yhqiu16/OCOWFC/docs/fpl21_nand_flash_controller_yunhuiqiu_fudan.pdf

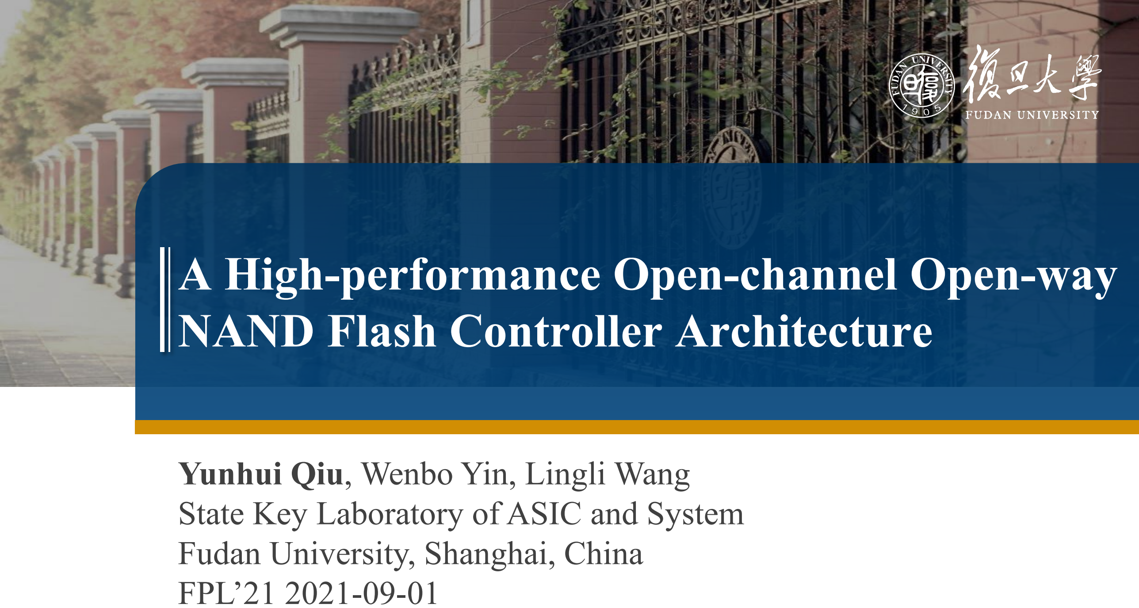
[picture p1: page 1]

# A High-performance Open-channel Open-way NAND Flash Controller Architecture

Yunhui Qiu, Wenbo Yin, Lingli Wang
State Key Laboratory of ASIC and System
Fudan University, Shanghai, China FPL’21 2021-09-01

NAND-Flash-based SSD

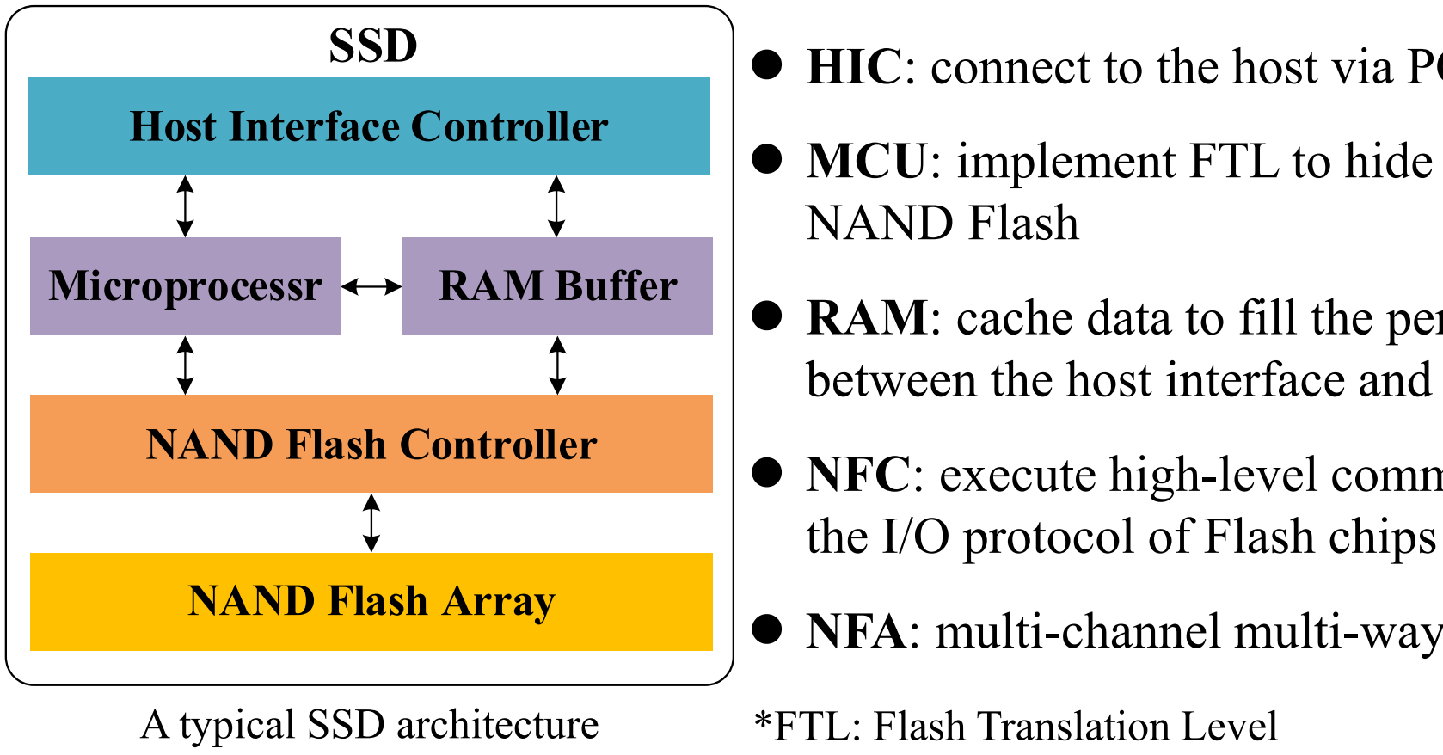
[picture p2: figure]
A typical SSD architecture; SSD; Microprocessr; NAND Flash Controller; NAND Flash Array; Host Interface Controller; RAM Buffer; NAND Flash; the I/O protocol of Flash chips; *FTL: Flash Translation Level

- MCU: implement FTL to hide the peculiarities of
- HIC: connect to the host via PCIe, SATA…
- RAM: cache data to fill the performance gap between the host interface and Flash media
- NFC: execute high-level commands according to
- NFA: multi-channel multi-way Flash chips

Flash Operations

### Challenges

R T
read
cmd

data
transfer

busy
period
(a) read page
P | T | P | S
post-prog
cmd

data
transfer

check
status

busy
period
(b) program page

pre-prog
cmd

E S
check
status

erase
cmd

busy
period
(c) erase block

~10µs

~100µs

~1000µs

- I/O speed: ~10MT/s - ~1000MT/s, lower than the host interface
- Slow execution: serious under-utilization of I/O bandwidth

Multi-level Parallelism
- Channel-level parallelism

multiple channels with independent I/O buses

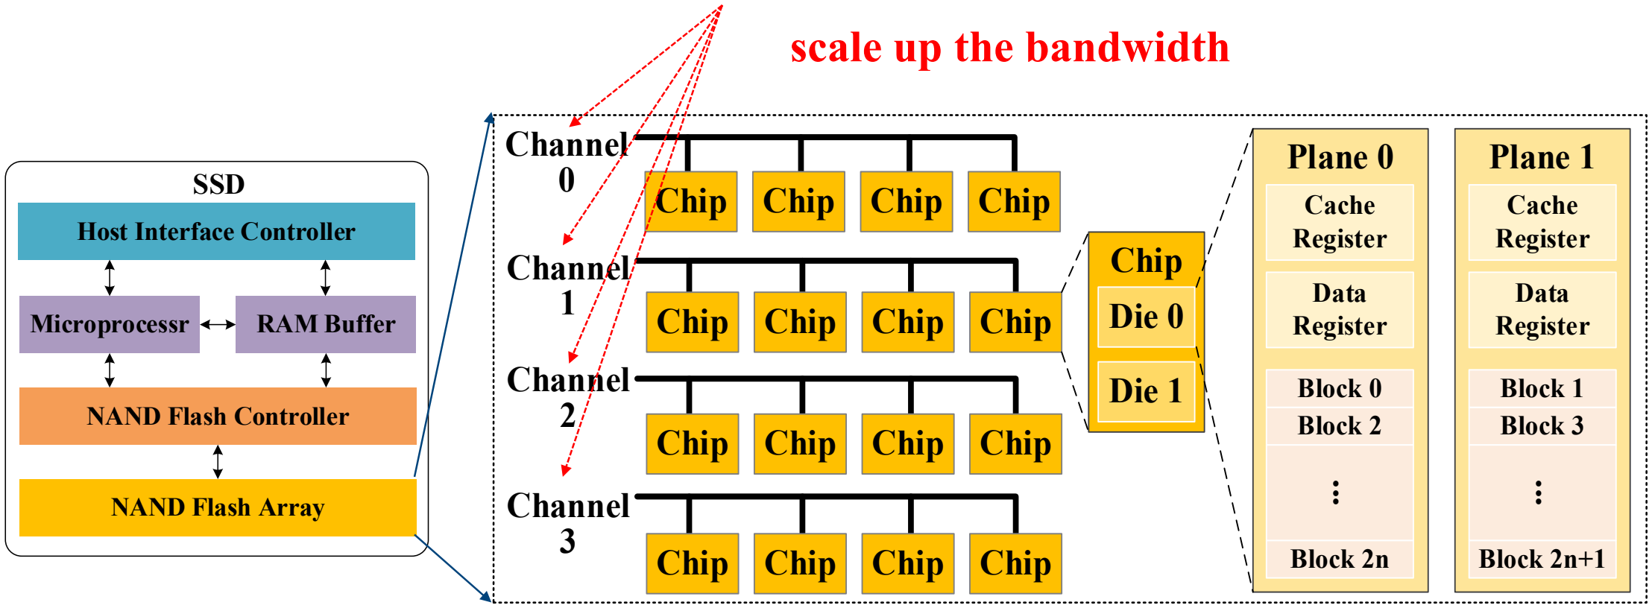
[picture p3: figure]
SSD; Microprocessr; NAND Flash Controller; NAND Flash Array; Host Interface Controller; RAM Buffer; Plane 0; Plane 1; Chip; Chip Chip Chip Chip; Channel 0; Die 0; Die 1; Cache Register Data Register; Block 0 Block 2; Block 2n ...; Block 1 Block 3; Block 2n+1 ...; Channel 1; Channel 2; Channel 3; scale up the bandwidth

Multi-level Parallelism
- Channel-level parallelism: independent I/O buses, scale up the bandwidth
- Way-level interleaving
multiple ways (chips or dies) share an I/O bus

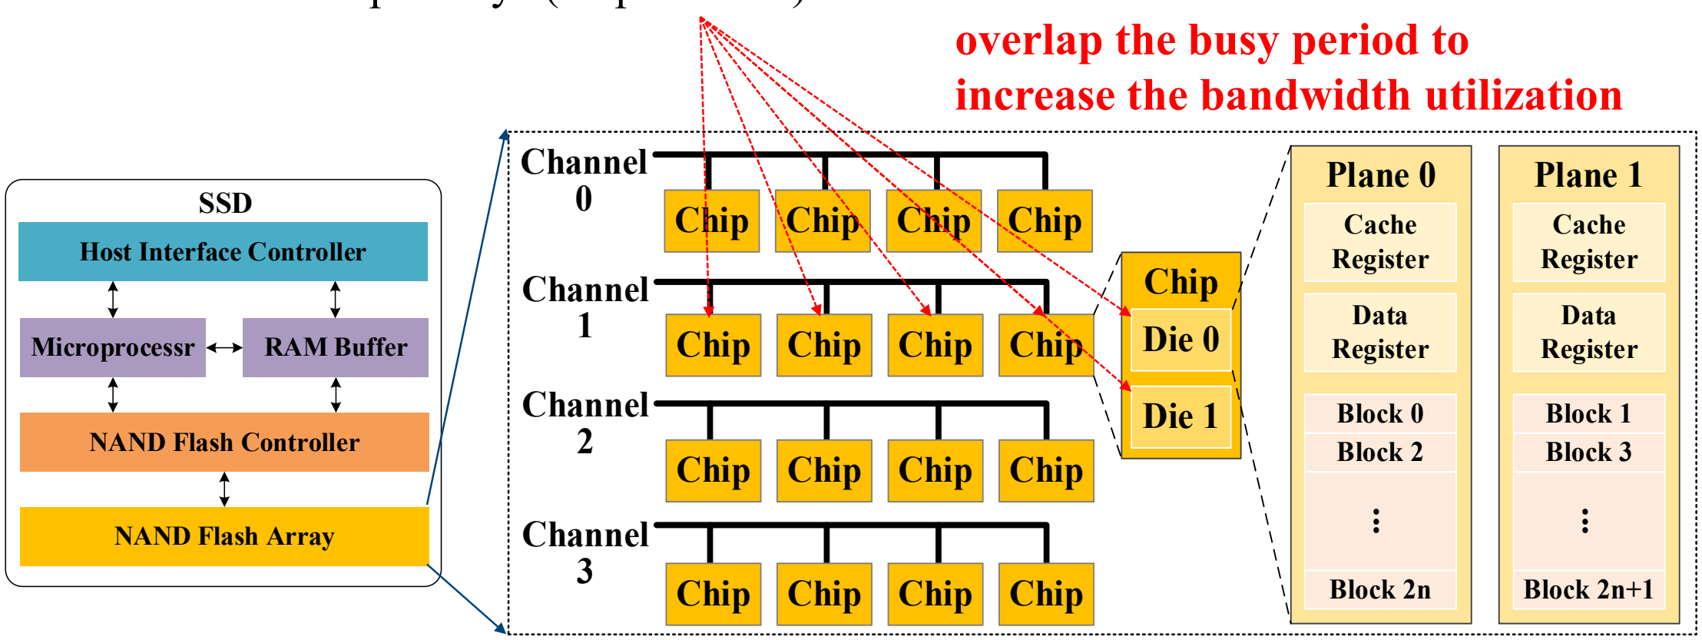
[picture p4: figure]
SSD; Microprocessr; NAND Flash Controller; NAND Flash Array; Host Interface Controller; RAM Buffer; Plane 0; Plane 1; Chip; Chip Chip Chip Chip; Channel 0; Die 0; Die 1; Cache Register Data Register; Block 0 Block 2; Block 2n ...; Block 1 Block 3; Block 2n+1 ...; Channel 1; Channel 2; Channel 3; overlap the busy period to increase the bandwidth utilization

Multi-level Parallelism
- Channel-level parallelism: independent I/O buses, scale up the bandwidth
- Way-level interleaving: share an I/O bus, increase the bandwidth utilization
- Plane-level interleaving
multiple planes in a die operate concurrently with some constraints increase the bandwidth utilization

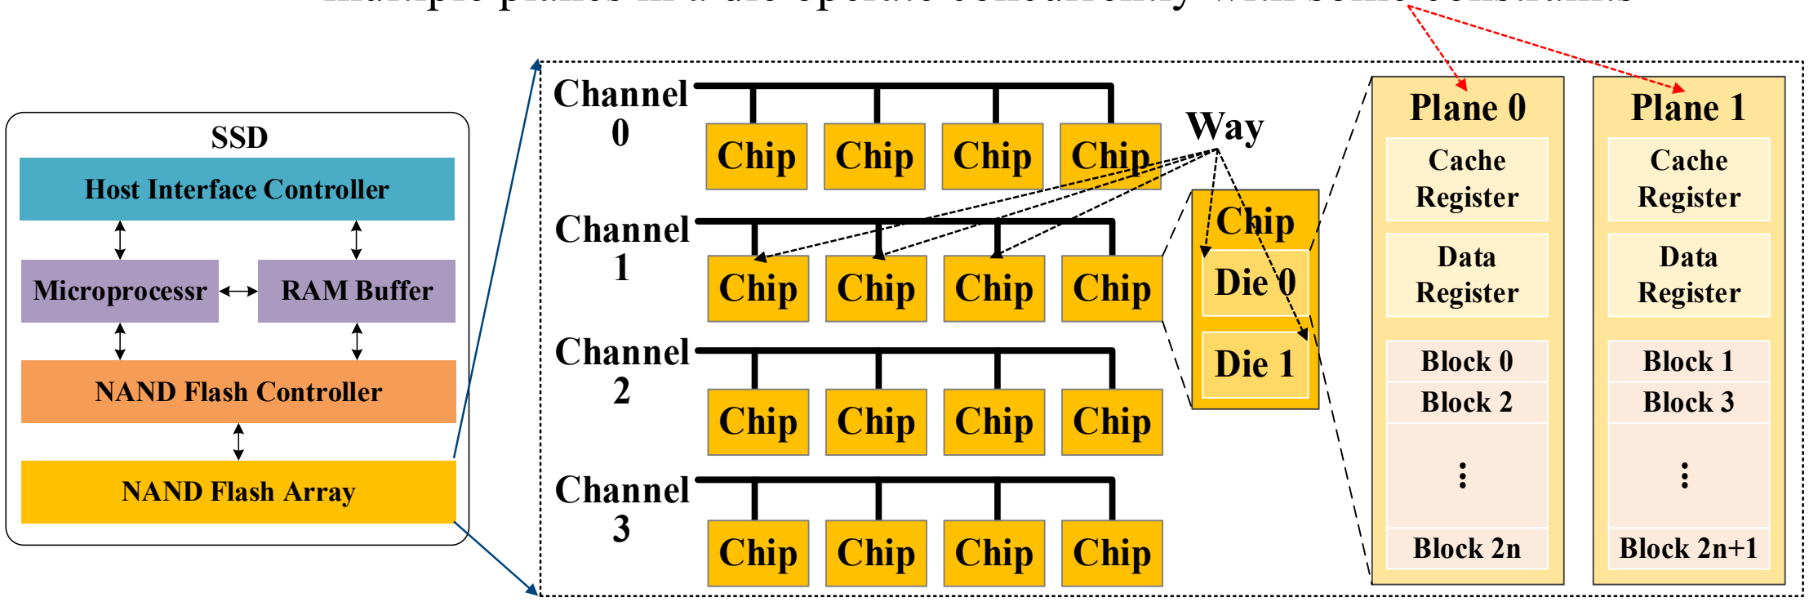
[picture p5: figure]
SSD; Microprocessr; NAND Flash Controller; NAND Flash Array; Host Interface Controller; RAM Buffer; Plane 0; Plane 1; Chip; Chip Chip Chip Chip; Channel 0; Die 0; Die 1; Cache Register Data Register; Block 0 Block 2; Block 2n ...; Block 1 Block 3; Block 2n+1 ...; Channel 1; Channel 2; Channel 3; Way

Multi-level Parallelism
- Channel-level parallelism: independent I/O buses, scale up the bandwidth
- Way-level interleaving: share an I/O bus, increase the bandwidth utilization
- Plane-level interleaving: operate concurrently, increase the bandwidth utilization
- Cache mode pipelining: increase throughput | pipelining

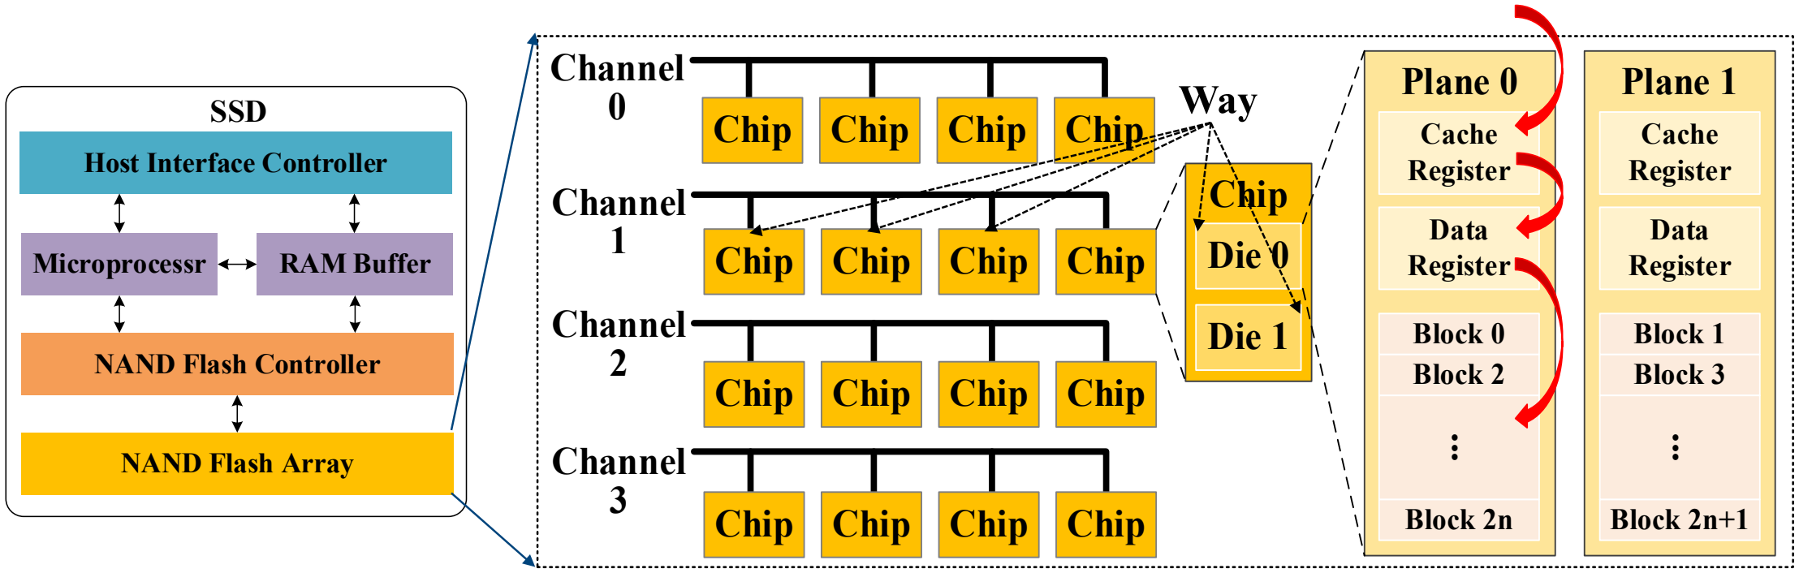
[picture p6: figure]
SSD; Microprocessr; NAND Flash Controller; NAND Flash Array; Host Interface Controller; RAM Buffer; Plane 0; Plane 1; Chip; Chip Chip Chip Chip; Channel 0; Die 0; Die 1; Cache Register Data Register; Block 0 Block 2; Block 2n ...; Block 1 Block 3; Block 2n+1 ...; Channel 1; Channel 2; Channel 3; Way

Motivation: exploit the multi-level parallelism

### 1. Flash simulators [11], [13]-[18]

- fast prototyping and verification
- hard to accurately model hardware controllers
- cannot be evaluated, verified, or tested in a practical environment

Related Work

### 2. Firmware-based I/O scheduling [5], [8], [19]

- tight coupling between FTL and Flash controller
- frequent and time-consuming software-hardware interactions impose serious

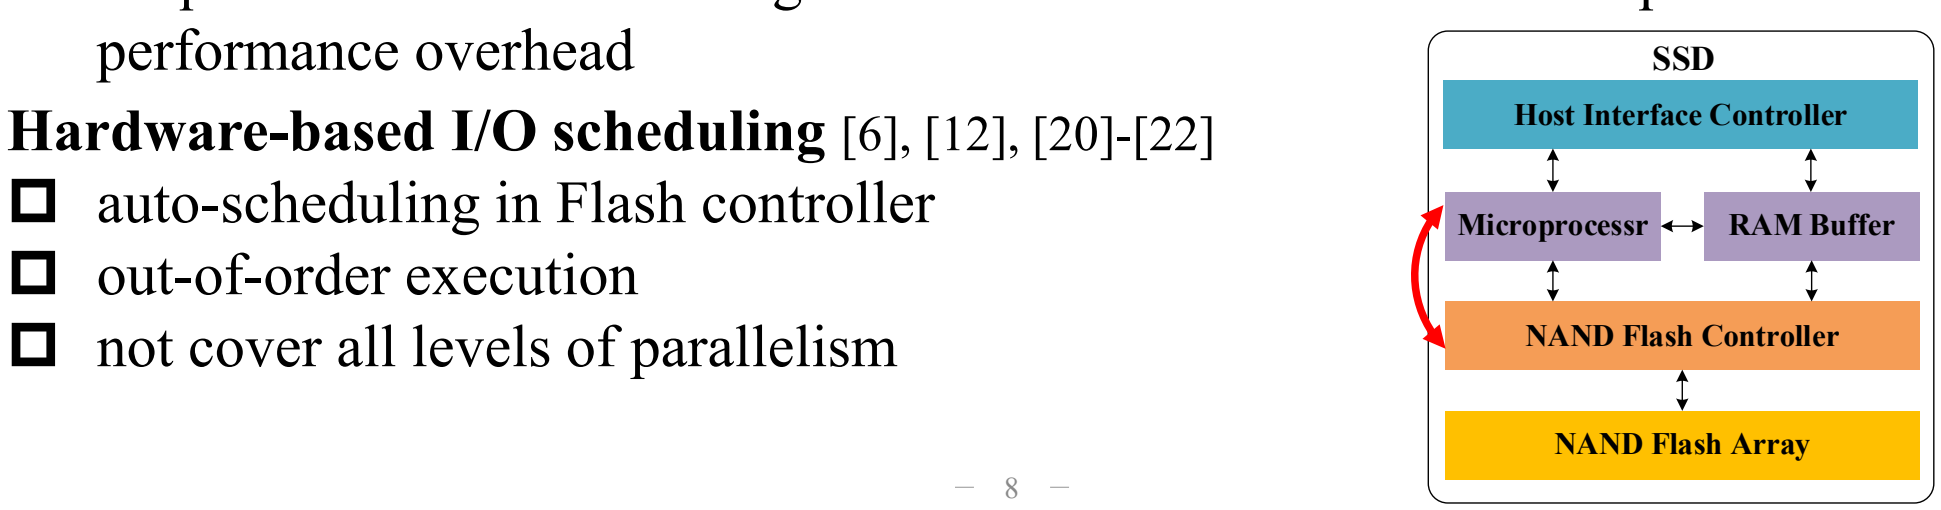
[picture p7: figure]
performance overhead; SSD; Microprocessr; NAND Flash Controller; NAND Flash Array; Host Interface Controller; RAM Buffer; auto-scheduling in Flash controller out-of-order execution not cover all levels of parallelism

### 3. Hardware-based I/O scheduling [6], [12], [20]-[22]

Contributions
An open-source high-performance open-channel open-way Flash controller supporting channel-way-plane levels of parallelism and cache mode pipelining.

### 1. open-way architecture

- expose multi-channel multi-way Flash topology to upper-level module
- queue-based asynchronous interface for each way

### 2. dual-level hardware scheduler

- increase multi-plane and cache mode operations
- auto-interleave commands in fine granularity

### 3. Flash command classification

- four groups: checking status, reading data, writing data, and others.
- one FSM for each group, rather than each command

*open-source RTL codes: https://github.com/yhqiu16/OCOWFC

# Flash Controller Design

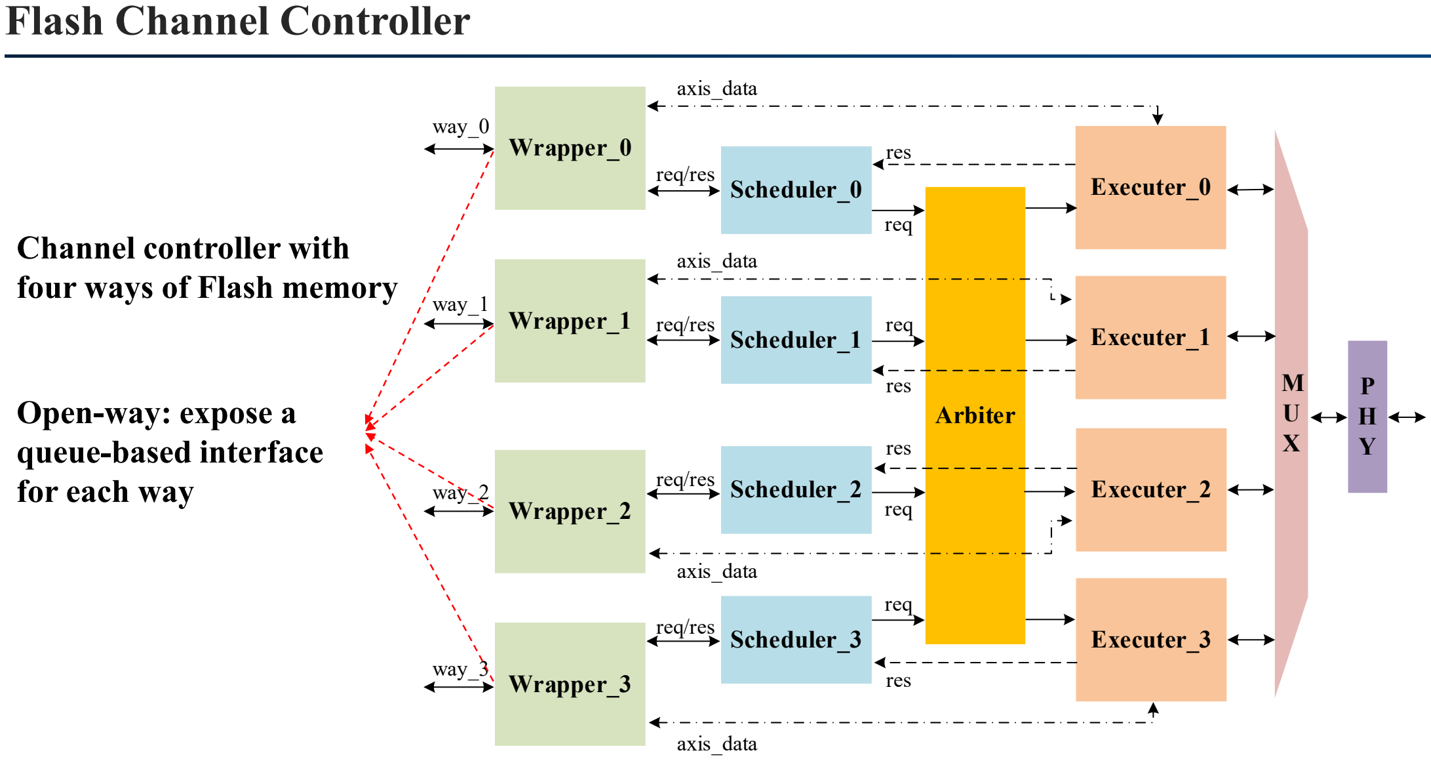
[picture p8: figure]
Flash Channel Controller; Channel controller with four ways of Flash memory; Scheduler_0; Scheduler_1; Executer_0; Executer_1; Arbiter; req; res; req/res; axis_data; Executer_2; Executer_3; Scheduler_2; Scheduler_3; Wrapper_0; Wrapper_1; Wrapper_2; Wrapper_3; way_0; way_1; way_2; way_3; Open-way: expose a queue-based interface for each way

Flash Command Classification

Reset Operations
RESET
SYNCHRONOUS RE-SET
RESET LUN
Identification Operations
READ ID
READ PARAMETERPAGE
READ UNIQUE ID
Configuration Operations
VOLUME SELECT
ODT CONFIGURE
GET FEATURES
SET FEATURES
GET FEATURES byLUN
SET FEATURES byLUN
Column Address Operations
CHANGE READ COL-UMN
CHANGE READ COL-UMN ENHANCED (ONFI) CHANGE READ COL-UMN ENHANCED (JEDEC) CHANGE WRITECOLUMN
CHANGE ROWAD-DRESS

Status Operations
READ STATUS
READ STATUS EN-HANCED
Read Operations
READ MODE
READ PAGE
READ PAGE MULTI-PLANE
READ PAGE CACHESEQUENTIAL
READ PAGE CACHERANDOM
READ PAGE CACHELAST
Program Operations
PROGRAM PAGE
PROGRAM PAGEMULTI-PLANE
PROGRAM PAGECACHE
Erase Operations
ERASE BLOCK
ERASE BLOCK MULTI-PLANE (ON-FI) ERASE BLOCK MUL-TI-PLANE (JEDEC) Copyback Operations
COPYBACK READ
COPYBACK PRO-GRAM
COPYBACK PRO-GRAM MULTI- PLANE

Flash
commands

Flash Command Classification

Flash commands classified into four groups: status, erase, read, and program
- status: status checking commands, e.g. read status and read status enhanced.
- erase: commands not using DQS signals, e.g. erase block and reset.
- read: read data using DQS signals, e.g. read page and read parameter page.
- program: write data using DQS signals, e.g. program page and set feature. One FSM for each group, rather than for each command

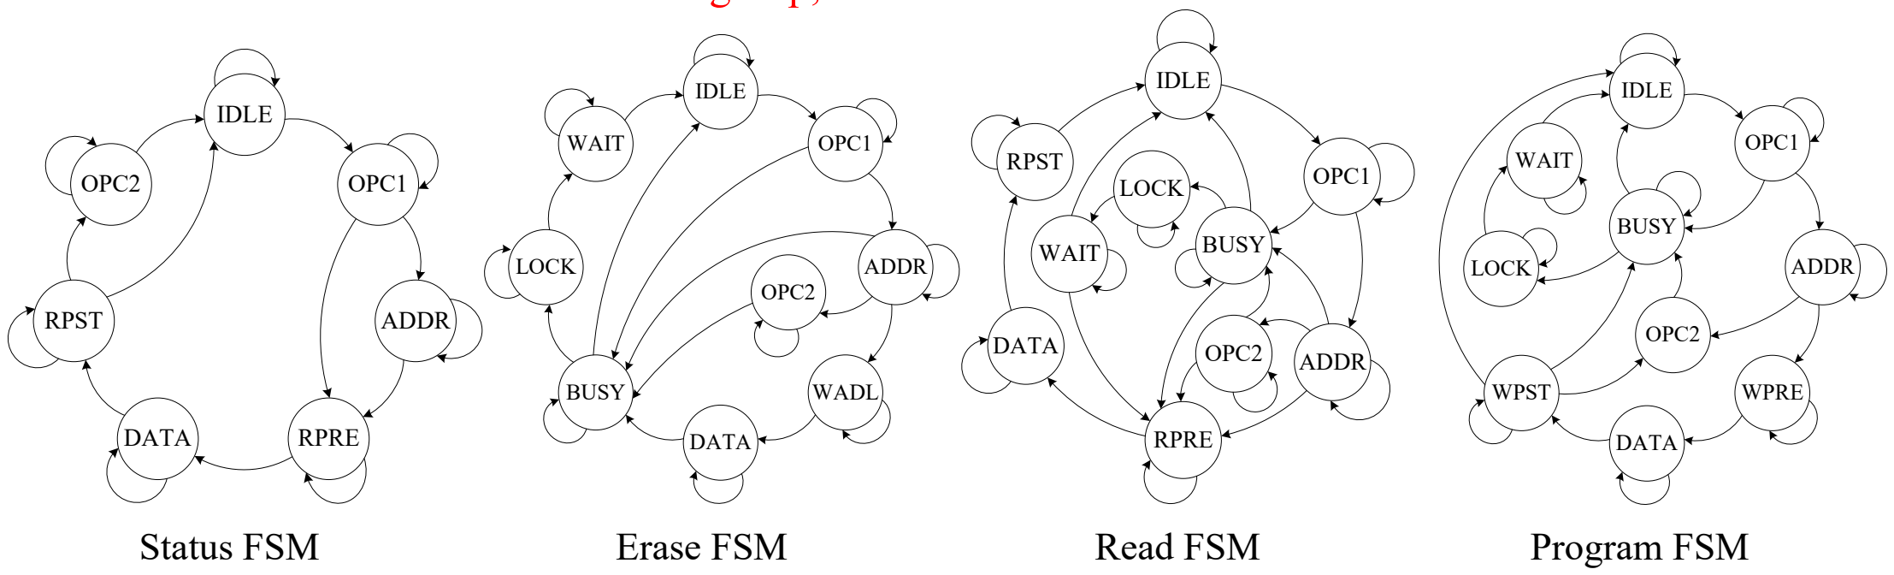
[picture p9: figure]
IDLE; OPC1; ADDR; DATA; RPRE; RPST; OPC2; LOCK; BUSY; WADL; WAIT; WPST; WPRE; Status FSM; Erase FSM; Read FSM; Program FSM

Flash Command Classification Hardware-automated executer Auto-schedule the command launching, data transferring, and status checking

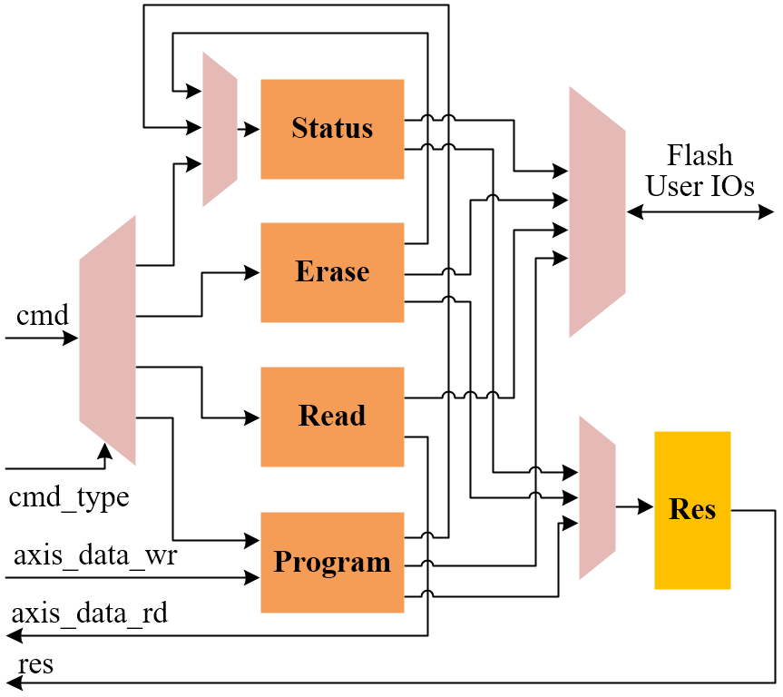
[picture p10: figure]

Executer architecture

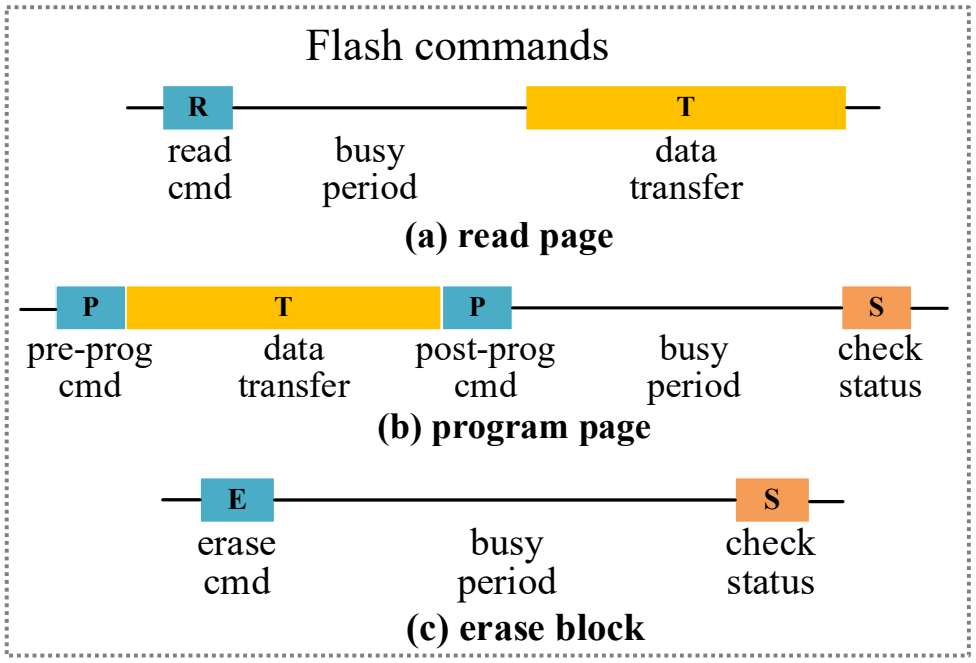
[picture p11: figure]
R T read cmd; data transfer; busy period (a) read page; post-prog cmd; check status; busy period (b) program page; pre-prog cmd; E S check status; erase cmd; busy period (c) erase block; Flash commands

Fine-grained Interleaving

Way-level fine-grained interleaving to overlap the busy period

R0 | T0 | R0 | T0
R1 | T1 | R1 | T1
R2 | T2 | R2 | T2
R3 | T3 | R3 | T3
T0 | R0 | T1 | R1 | T2 | R2 | T3 | R3 | T0

way 0

way 1

way 2

way 3

shared bus

Long busy period & Commands executed in serial for a single way

bandwidth utilization

decrease

increase

original busy period overlapped

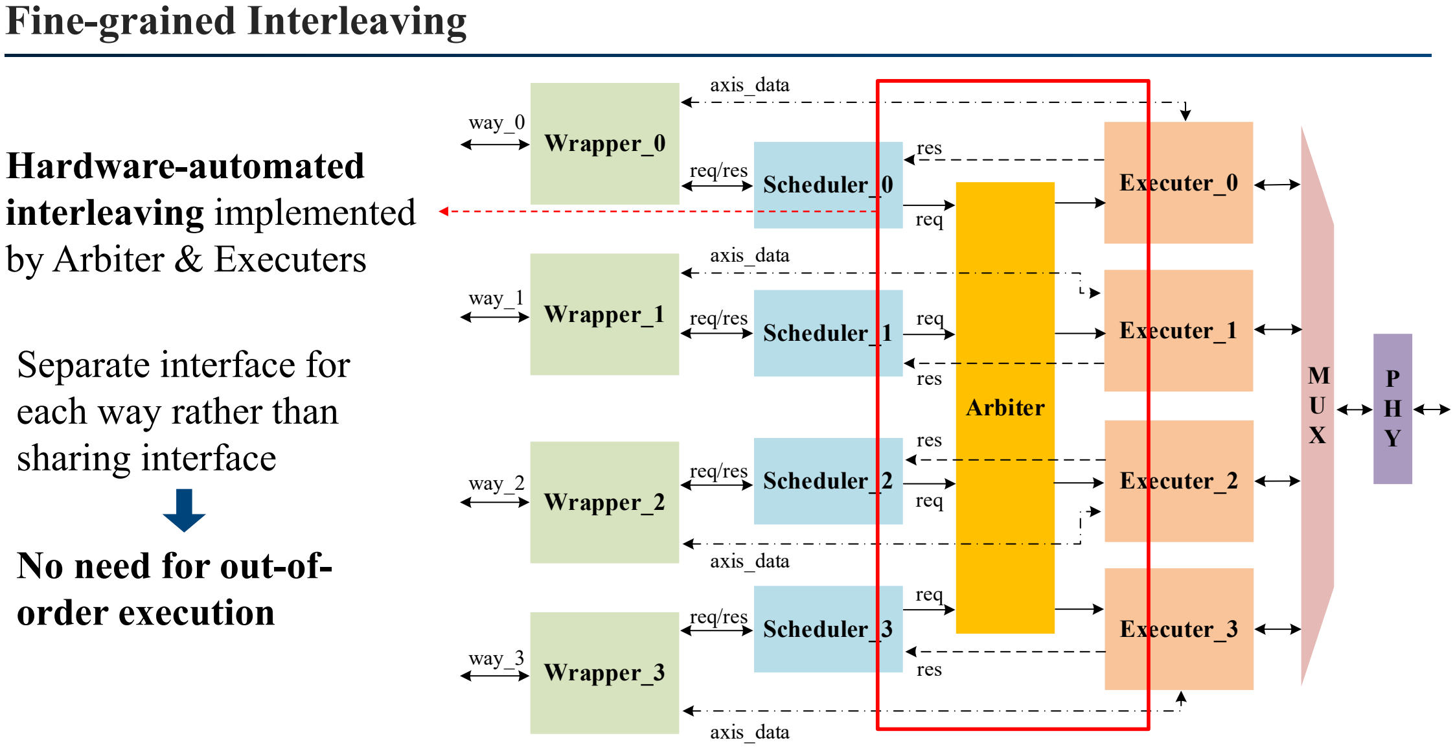
[picture p12: figure]
Fine-grained Interleaving; Hardware-automated interleaving implemented by Arbiter & Executers; Scheduler_0; Scheduler_1; Executer_0; Executer_1; Arbiter; req; res; req/res; axis_data; Executer_2; Executer_3; Scheduler_2; Scheduler_3; Wrapper_0; Wrapper_1; Wrapper_2; Wrapper_3; way_0; way_1; way_2; way_3; Separate interface for each way rather than sharing interface; No need for out-of- order execution

High-level Scheduling

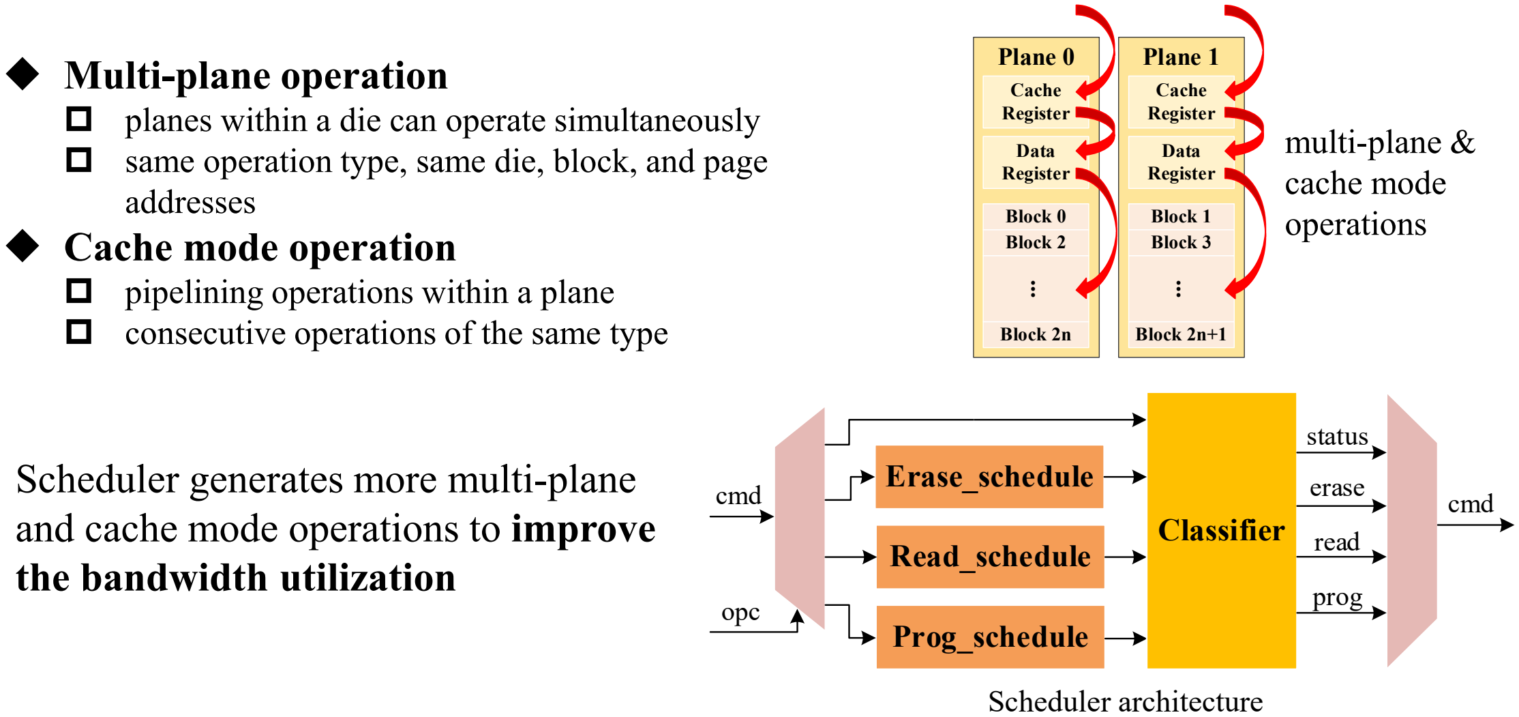
[picture p13: figure]
Scheduler generates more multi-plane and cache mode operations to improve; the bandwidth utilization; Read_schedule; Prog_schedule; cmd cmd; opc; Classifier; prog; read; erase; status; Erase_schedule; Plane 0; Plane 1; Cache Register Data Register; Block 0 Block 2; Block 2n ...; Block 1 Block 3; Block 2n+1 ...; Scheduler architecture; multi-plane & cache mode operations; Multi-plane operation; addresses Cache mode operation pipelining operations within a plane

- planes within a die can operate simultaneously
- same operation type, same die, block, and page
- consecutive operations of the same type

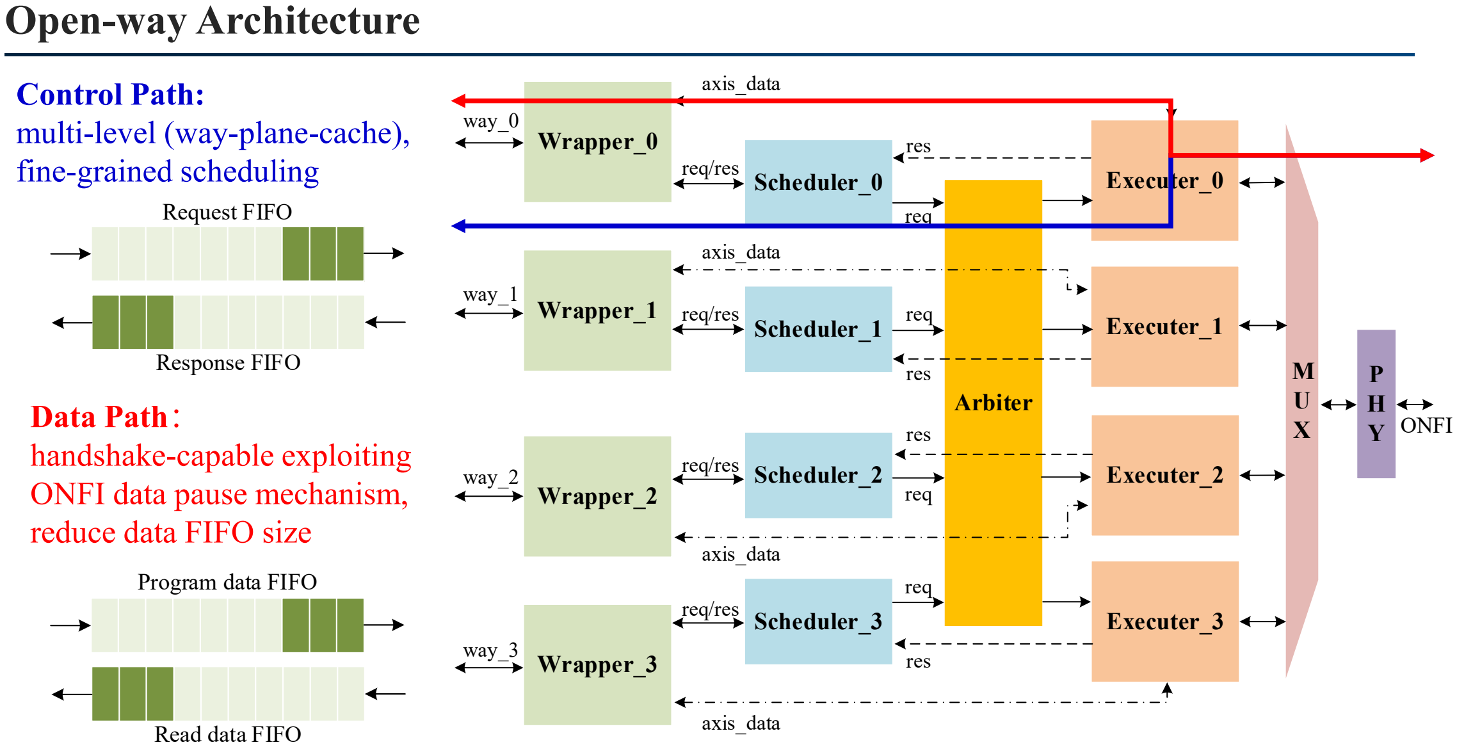
[picture p14: figure]
Open-way Architecture; Control Path: multi-level (way-plane-cache),; fine-grained scheduling; Scheduler_0; Scheduler_1; Executer_0; Executer_1; Arbiter; req; res; req/res; axis_data; Executer_2; Executer_3; Scheduler_2; Scheduler_3; Wrapper_0; Wrapper_1; Wrapper_2; Wrapper_3; way_0; way_1; way_2; way_3; Data Path： handshake-capable exploiting ONFI data pause mechanism, reduce data FIFO size; Program data FIFO; Read data FIFO; Request FIFO; Response FIFO; ONFI

# Evaluations

Experimental Setup

- Heterogeneous platform: FPGA + CPU
- Tester: generate various commands
- NFC: four channels, four ways per channel

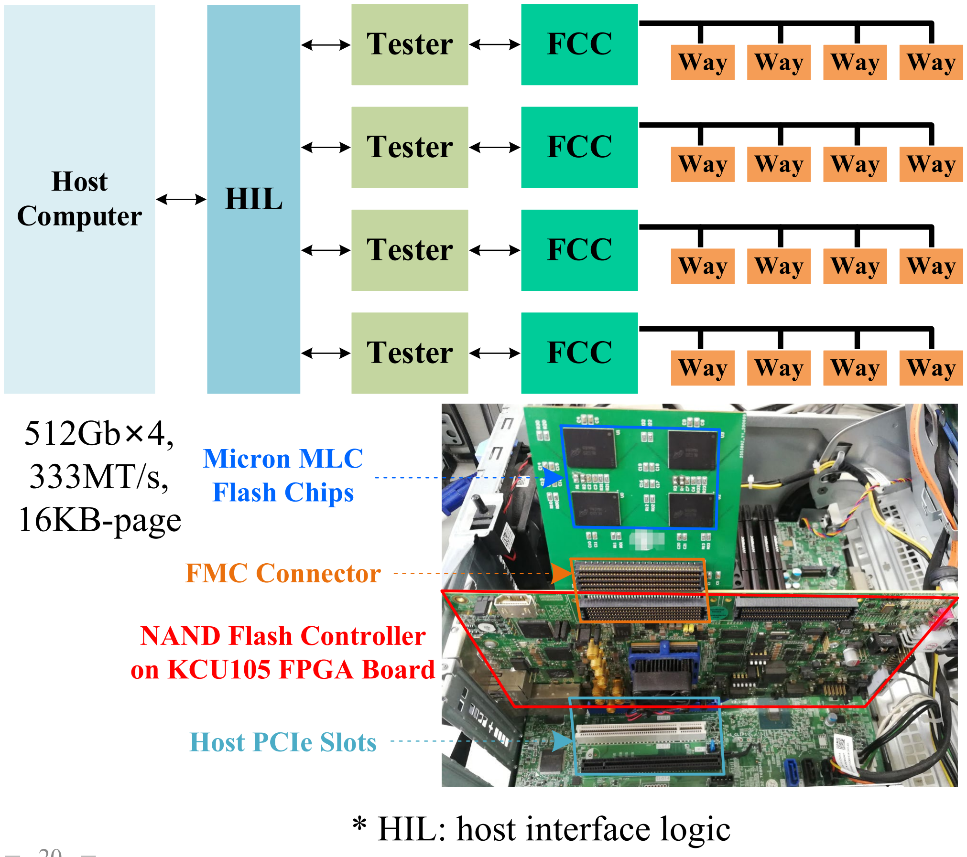
[picture p15: figure]
Way Way Way Way; HIL; Tester; FCC; Host Computer; NAND Flash Controller on KCU105 FPGA Board; FMC Connector; Micron MLC Flash Chips; Host PCIe Slots; 512Gb×4, 333MT/s, 16KB-page; * HIL: host interface logic

Flash operations | Typical | Max
Read page time | -- | 115μs
Cache read busy time | 26μs | 115μs
Program page time | 1600μs | 3000μs
Cache program busy time | 1100μs | 3000μs
Erase block time | 3ms | 12ms

Flash timing characteristics

Overlap the busy period completely:
Given I/O speed (f), page size (s), and busy time (t), the interleaving page number (n): nn =
ffff
ss
n = 2.3/61.0 for read/program
Max theoretical bandwidth: 1.33GB/s

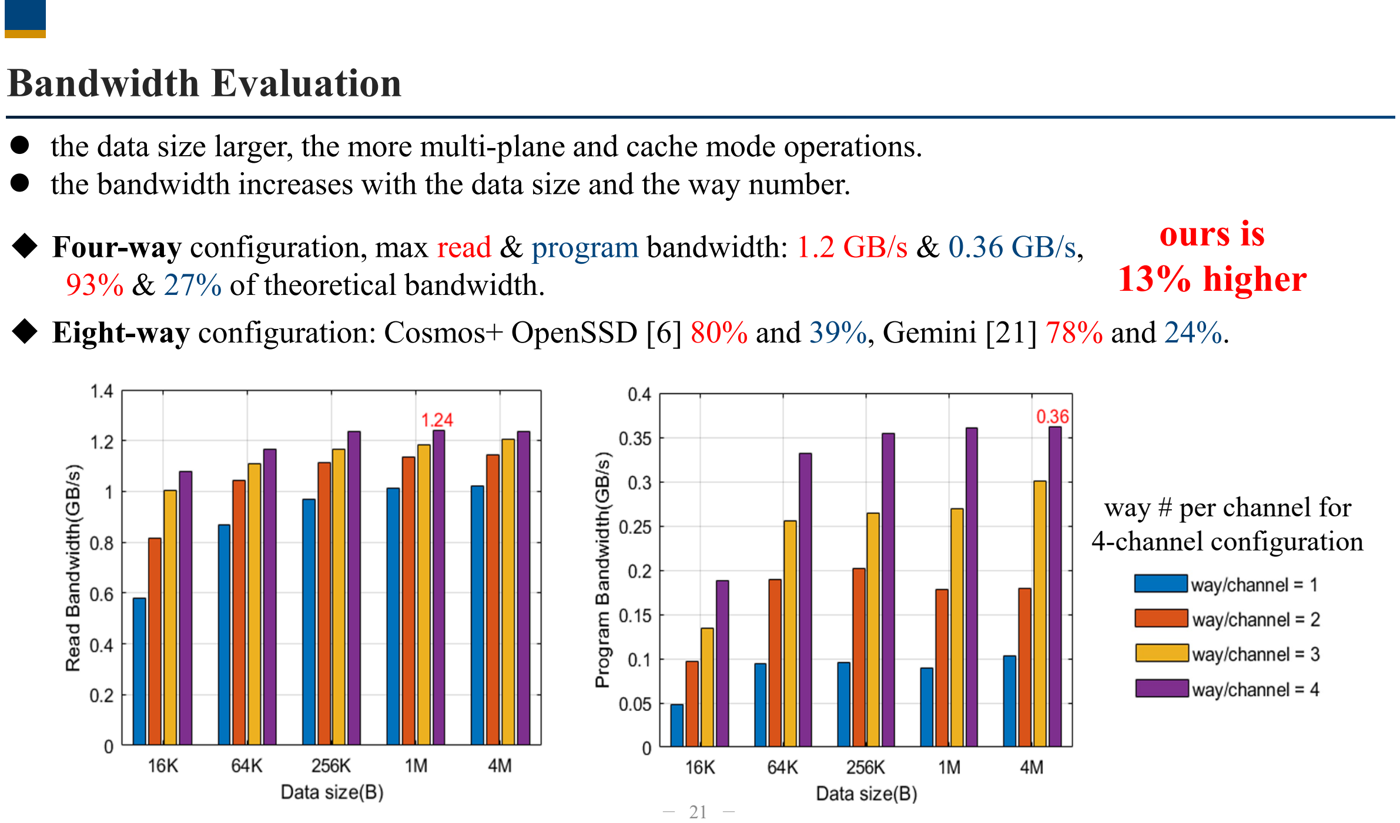
[picture p16: page 21]

Bandwidth Evaluation

- Four-way configuration, max read & program bandwidth: 1.2 GB/s & 0.36 GB/s, 93% & 27% of theoretical bandwidth.
- the data size larger, the more multi-plane and cache mode operations.
- the bandwidth increases with the data size and the way number.
- Eight-way configuration: Cosmos+ OpenSSD [6] 80% and 39%, Gemini [21] 78% and 24%.

ours is
13% higher

way # per channel for
4-channel configuration

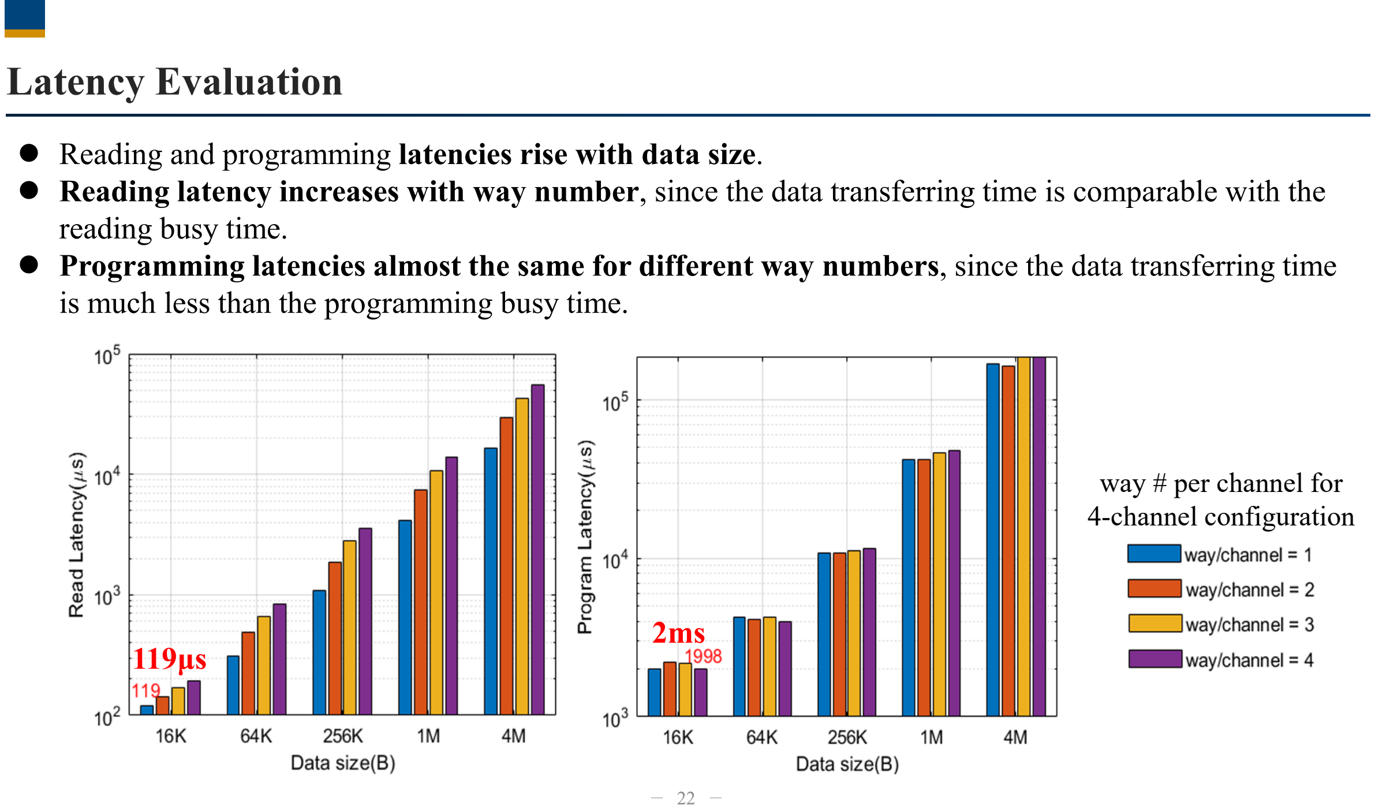
[picture p17: page 22]

Latency Evaluation

- Reading and programming latencies rise with data size.
- Reading latency increases with way number, since the data transferring time is comparable with the reading busy time.
- Programming latencies almost the same for different way numbers, since the data transferring time is much less than the programming busy time.

119μs

2ms

way # per channel for
4-channel configuration

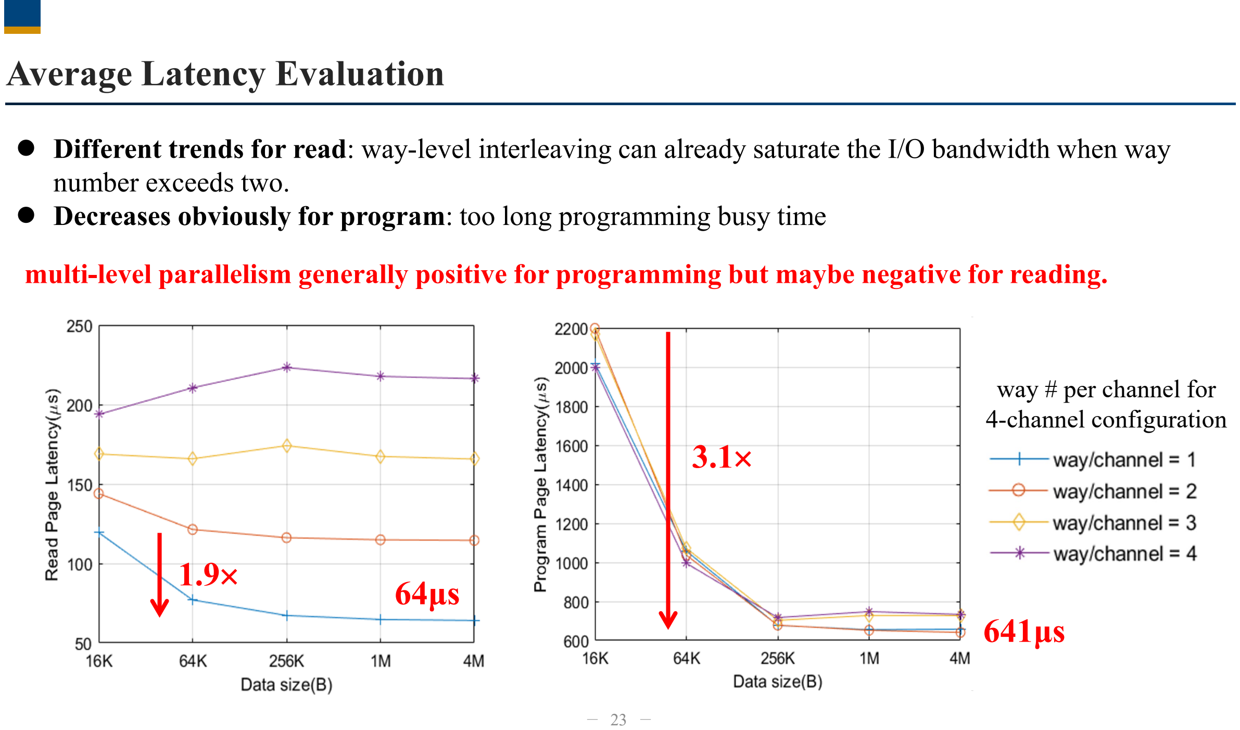
[picture p18: page 23]

Average Latency Evaluation

- Different trends for read: way-level interleaving can already saturate the I/O bandwidth when way number exceeds two.
- Decreases obviously for program: too long programming busy time

64μs
641μs

3.1×

1.9×

multi-level parallelism generally positive for programming but maybe negative for reading.

way # per channel for
4-channel configuration

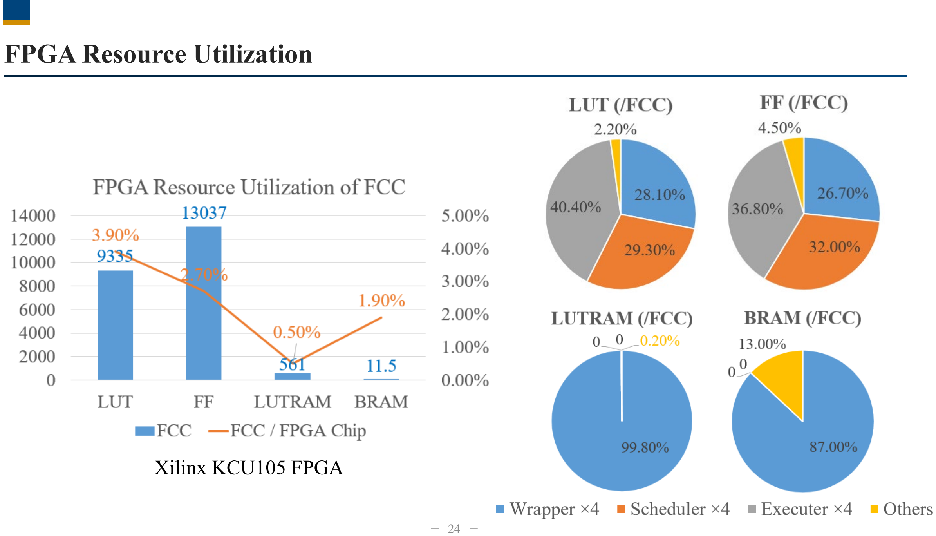
[picture p19: page 24]

FPGA Resource Utilization

Xilinx KCU105 FPGA

Resource Utilization Comparisons

Name | FPGA Device | Page Size | LUT | FF | BRAM
FCC in Gemini [21] | Vertex-6
| XC6VLX240T | 4KB | 1673 | 2314 | 13
FCC in Cosmos+ OpenSSD [6] | Zynq-7000
| XC7Z045-3FFG900 | 16KB | 10988 | 7548 | 21
Our FCC | KCU105
| XCKU040-2FFGVA1156E | 16KB | 9335 | 13037 | 11.5

FPGA resource utilization comparisons between our FCC and other FCCs

Lowest BRAM usage: due to the open-way architecture and the data pause mechanism exploitation Larger LUT & FF usage: our FCC supports more levels of parallelism and more Flash operations.

# Summary

Conclusions

1. Multi-level parallelism
- channel-way-plane-cache (parallel or interleaving or pipelining)
2. Flash controller design
- open-way architecture to improve bandwidth utilization
- dual-level hardware scheduler to improve bandwidth utilization
- Flash command classification to reduce hardware resources
3. Evaluation
- max. bandwidth: 1.2 GB/s, 93% of theoretical bandwidth,
at least 13% higher than other controllers
- min. latency for page read/program: 119μs/2ms
- min. read/program latency with fine-grained interleaving: 64μs /641μs, speeding up by 1.9× and 3.1×

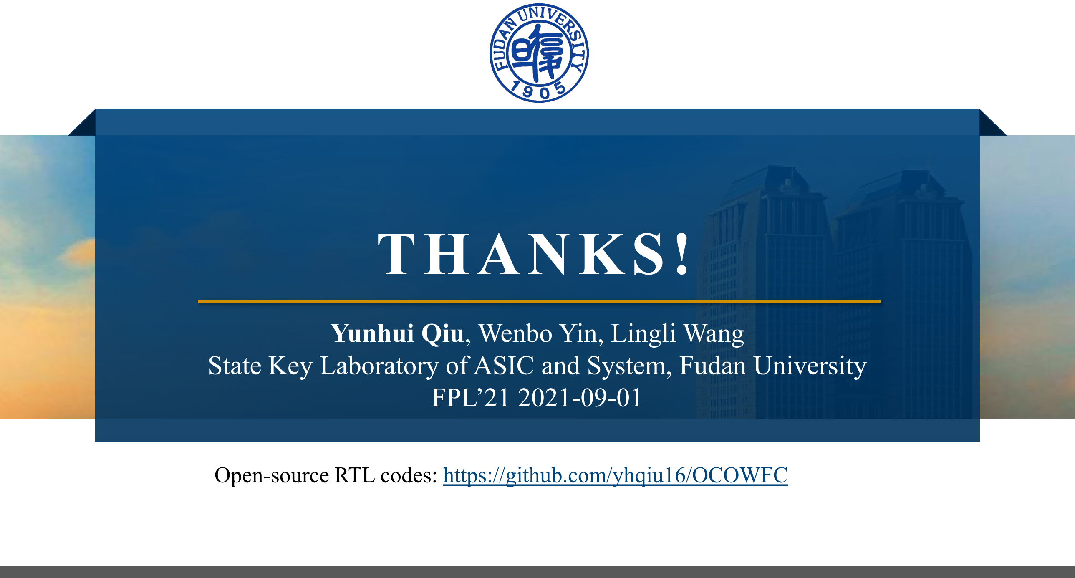
[picture p20: page 28]

# THANKS!

Yunhui Qiu, Wenbo Yin, Lingli Wang State Key Laboratory of ASIC and System, Fudan University FPL’21 2021-09-01

Open-source RTL codes: https://github.com/yhqiu16/OCOWFC
