yhqiu16/OCOWFC/project/NFC/NFC.srcs/sources_1/ip/xdma_0/xdma_v4_1/hdl/verilog/xdma_0_core_top.sv

//-----------------------------------------------------------------------------
//
// (c) Copyright 2012-2012 Xilinx, Inc. All rights reserved.
//
// This file contains confidential and proprietary information
// of Xilinx, Inc. and is protected under U.S. and
// international copyright and other intellectual property
// laws.
//
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
// CRITICAL APPLICATIONS
// Xilinx products are not designed or intended to be fail-
// safe, or for use in any application requiring fail-safe
// performance, such as life-support or safety devices or
// systems, Class III medical devices, nuclear facilities,
// applications related to the deployment of airbags, or any
// other applications that could lead to death, personal
// injury, or severe property or environmental damage
// (individually and collectively, "Critical
// Applications"). Customer assumes the sole risk and
// liability of any use of Xilinx products in Critical
// Applications, subject only to applicable laws and
// regulations governing limitations on product liability.
//
// THIS COPYRIGHT NOTICE AND DISCLAIMER MUST BE RETAINED AS
// PART OF THIS FILE AT ALL TIMES.
//
//-----------------------------------------------------------------------------
//
// Project    : The Xilinx PCI Express DMA 
// File       : xdma_0_core_top.sv
// Version    : 4.1
//-----------------------------------------------------------------------------

`timescale 1ps/1ps
`include "xdma_axi4mm_axi_bridge.vh"
`include "dma_defines.vh"
`include "dma_defines.svh"
module xdma_0_core_top 
#(
  parameter       COMPONENT_NAME               = "xdma_0",
  parameter       VERSION                      = 6,
  parameter       C_DEVICE_NUMBER              = 0, // Device number for Root Port configurations only
  parameter       VCU1262                      = "FALSE",
  parameter       xlnx_ref_board               = "None",
  parameter       GTWIZ_IN_CORE                = 1,
  parameter       INS_LOSS_PROFILE             = "Add-in_Card",
  parameter       PL_UPSTREAM_FACING           = "TRUE",
  parameter       TL_LEGACY_MODE_ENABLE        = "FALSE",
  parameter       PCIE_BLK_LOCN                = 0,
  parameter       PL_LINK_CAP_MAX_LINK_WIDTH   = 1,
  parameter       PL_LINK_CAP_MAX_LINK_SPEED   = 1,
  parameter       REF_CLK_FREQ                 = 0,
  parameter       FREE_RUN_FREQ                = 1,
  parameter       DRP_CLK_SEL                  = 0,
  parameter       AXI_ADDR_WIDTH               = 32,
  parameter       AXI_DATA_WIDTH               = 64,
  parameter       CORE_CLK_FREQ                = 2,
  parameter       PLL_TYPE                     = 0,
  parameter       USER_CLK_FREQ                = 1,
  parameter       PIPE_DEBUG_EN                = "FALSE",
  parameter       SILICON_REV                  = "Production",
  parameter       PIPE_SIM                     = "FALSE",
  parameter       EXT_CH_GT_DRP                = "FALSE",
  parameter       PCIE3_DRP                    = "FALSE",
  parameter       DEDICATE_PERST               = "TRUE",
  parameter       SYS_RESET_POLARITY           = 0,
  parameter       MCAP_ENABLEMENT              = "NONE",
  parameter       MCAP_FPGA_BITSTREAM_VERSION = 32'h00000000,
  parameter       EXT_STARTUP_PRIMITIVE        = "FALSE",
  parameter       PF0_VENDOR_ID                = 16'h10EE,
  parameter       PF0_DEVICE_ID                = 16'h9011,
  parameter       PF0_REVISION_ID              = 8'h00,
  parameter       PF0_SUBSYSTEM_VENDOR_ID      = 16'h10EE,
  parameter       PF0_SUBSYSTEM_ID             = 16'h0007,
  parameter       PF0_CLASS_CODE               = 24'h058000,
  parameter       PF1_VENDOR_ID                = 16'h10EE,
  parameter       PF1_DEVICE_ID                = 16'h9111,
  parameter       PF1_REVISION_ID              = 8'h00,
  parameter       PF1_SUBSYSTEM_VENDOR_ID      = 16'h10EE,
  parameter       PF1_SUBSYSTEM_ID             = 16'h0007,
  parameter       PF1_CLASS_CODE               = 24'h058000,
  parameter       PF2_DEVICE_ID                = 16'h9211,
  parameter       PF2_REVISION_ID              = 8'h00,
  parameter       PF2_SUBSYSTEM_ID             = 16'h0007,
  parameter       PF3_DEVICE_ID                = 16'h9311,
  parameter       PF3_REVISION_ID              = 8'h00,
  parameter       PF3_SUBSYSTEM_ID             = 16'h0007,
  parameter       AXILITE_MASTER_APERTURE_SIZE = 5'b00101,
  parameter       AXILITE_MASTER_CONTROL       = 3'b100,
  parameter       XDMA_APERTURE_SIZE           = 5'b00101,
  parameter       XDMA_CONTROL                 = 3'b000,
  parameter       AXIST_BYPASS_APERTURE_SIZE   = 5'b00101,
  parameter       AXIST_BYPASS_CONTROL         = 3'b000,
  parameter [63:0]C_PCIEBAR2AXIBAR_0           = 64'h0000000000000000,
  parameter [63:0]C_PCIEBAR2AXIBAR_1           = 64'h0000000000000000,
  parameter [63:0]C_PCIEBAR2AXIBAR_2           = 64'h0000000000000000,
  parameter       PF0_INTERRUPT_PIN            = 3'b001,
  parameter       PF0_MSI_CAP_MULTIMSGCAP      = 0,
  parameter       C_COMP_TIMEOUT               = 0,
  parameter       SHARED_LOGIC                 = 1,
  parameter       SHARED_LOGIC_CLK             = "FALSE",
  parameter       SHARED_LOGIC_CLK_7XG2        = "FALSE",
  parameter       SHARED_LOGIC_BOTH            = "FALSE",
  parameter       SHARED_LOGIC_BOTH_7XG2       = "FALSE",
  parameter       SHARED_LOGIC_GTC             = "FALSE",
  parameter       SHARED_LOGIC_GTC_7XG2        = "FALSE",
  parameter       EN_TRANSCEIVER_STATUS_PORTS  = "FALSE",
  parameter       IS_BOARD_PROJECT             = 0,
  parameter       EN_GT_SELECTION              = "FALSE",
  parameter       SELECT_QUAD                  = "GTH_Quad_224",
  parameter       ULTRASCALE                   = "FALSE",
  parameter       ULTRASCALE_PLUS              = "FALSE",
  parameter       V7_GEN3                      = "FALSE",
  parameter       MSI_ENABLED                  = "TRUE",
  parameter       DEV_PORT_TYPE                = 0,
  parameter       XDMA_PCIE_64BIT_EN           = "FALSE",
  parameter       XDMA_AXI_INTF_MM             = 1,
  parameter       XDMA_AXILITE_MASTER          = "FALSE",
  parameter       XDMA_AXIST_BYPASS            = "FALSE",
  parameter       XDMA_RNUM_CHNL               = 1,
  parameter       XDMA_WNUM_CHNL               = 1,
  parameter       XDMA_AXILITE_SLAVE           = "FALSE",
  parameter       XDMA_NUM_USR_IRQ             = 1,
  parameter       XDMA_RNUM_RIDS               = 32,
  parameter       XDMA_WNUM_RIDS               = 16,
  parameter       C_M_AXI_ID_WIDTH             = 4,
  parameter       C_FAMILY                     = "virtex7",
  parameter       XDMA_NUM_PCIE_TAG            = 64,
  parameter       EN_WCHNL_0                   = "TRUE",
  parameter       EN_WCHNL_1                   = "FALSE",
  parameter       EN_WCHNL_2                   = "FALSE",
  parameter       EN_WCHNL_3                   = "FALSE",
  parameter       EN_WCHNL_4                   = "FALSE",
  parameter       EN_WCHNL_5                   = "FALSE",
  parameter       EN_WCHNL_6                   = "FALSE",
  parameter       EN_WCHNL_7                   = "FALSE",
  parameter       EN_RCHNL_0                   = "TRUE",
  parameter       EN_RCHNL_1                   = "FALSE",
  parameter       EN_RCHNL_2                   = "FALSE",
  parameter       EN_RCHNL_3                   = "FALSE",
  parameter       EN_RCHNL_4                   = "FALSE",
  parameter       EN_RCHNL_5                   = "FALSE",
  parameter       EN_RCHNL_6                   = "FALSE",
  parameter       EN_RCHNL_7                   = "FALSE",
  parameter       XDMA_DSC_BYPASS              = "FALSE",
  parameter       C_METERING_ON                = 1,
  parameter       RX_DETECT                    = 0,
  parameter       DSC_BYPASS_RD                = 0,
  parameter       DSC_BYPASS_WR                = 0,
  parameter       XDMA_STS_PORTS               = "FALSE",
  parameter       MSIX_ENABLED                 = "FALSE",
  parameter       WR_CH0_ENABLED               = "FALSE",
  parameter       WR_CH1_ENABLED               = "FALSE",
  parameter       WR_CH2_ENABLED               = "FALSE",
  parameter       WR_CH3_ENABLED               = "FALSE",
  parameter       RD_CH0_ENABLED               = "FALSE",
  parameter       RD_CH1_ENABLED               = "FALSE",
  parameter       RD_CH2_ENABLED               = "FALSE",
  parameter       RD_CH3_ENABLED               = "FALSE",
  parameter       CFG_MGMT_IF                  = "TRUE",
  parameter       RQ_SEQ_NUM_IGNORE            = 0,
  parameter       CFG_EXT_IF                   = "TRUE",
  parameter       LEGACY_CFG_EXT_IF            = "TRUE",
  parameter       C_PARITY_CHECK               = 1,
  parameter       C_PARITY_GEN                 = 1,
  parameter       C_PARITY_PROP                = 0,
  parameter       EN_DEBUG_PORTS               = "FALSE",
  parameter       VU9P_BOARD                   = "FALSE",
  parameter       ENABLE_JTAG_DBG              = "FALSE",
  parameter       ENABLE_IBERT                 = "FALSE",
  parameter       MM_SLAVE_EN                  = 0,
  parameter       DMA_EN                       = 1,
  parameter       FUNC_MODE                    = 1,
  parameter       INTERRUPT_OUT_WIDTH          = 1,
  parameter       C_MSI_RX_PIN_EN              = 0,
  parameter       C_MSIX_RX_PIN_EN             = 1,
  parameter       C_INTX_RX_PIN_EN             = 1,
  parameter       MSIX_RX_DECODE_EN            = "FALSE",
  parameter       MSIX_VEC_NUM                 = 1024,
  parameter       PF1_ENABLED                  = 0,
  parameter       PF2_ENABLED                  = 0,
  parameter       PF3_ENABLED                  = 0,
  parameter       C_AXIBAR_NUM                 = 1,
  parameter [63:0]C_AXIBAR_0                   = 64'h0000_0000_0000_0000,
  parameter [63:0]C_AXIBAR_HIGHADDR_0          = 64'hffff_ffff_ffff_ffff,
  parameter [63:0]C_AXIBAR_1                   = 64'h0000_0000_0000_0000,
  parameter [63:0]C_AXIBAR_HIGHADDR_1          = 64'hffff_ffff_ffff_ffff,
  parameter [63:0]C_AXIBAR_2                   = 64'h0000_0000_0000_0000,
  parameter [63:0]C_AXIBAR_HIGHADDR_2          = 64'hffff_ffff_ffff_ffff,
  parameter [63:0]C_AXIBAR_3                   = 64'h0000_0000_0000_0000,
  parameter [63:0]C_AXIBAR_HIGHADDR_3          = 64'hffff_ffff_ffff_ffff,
  parameter [63:0]C_AXIBAR_4                   = 64'h0000_0000_0000_0000,
  parameter [63:0]C_AXIBAR_HIGHADDR_4          = 64'hffff_ffff_ffff_ffff,
  parameter [63:0]C_AXIBAR_5                   = 64'h0000_0000_0000_0000,
  parameter [63:0]C_AXIBAR_HIGHADDR_5          = 64'hffff_ffff_ffff_ffff,
  parameter [63:0]C_AXIBAR2PCIEBAR_0           = 64'h0000_0000_0000_0000,
  parameter [63:0]C_AXIBAR2PCIEBAR_1           = 64'h0000_0000_0000_0000,
  parameter [63:0]C_AXIBAR2PCIEBAR_2           = 64'h0000_0000_0000_0000,
  parameter [63:0]C_AXIBAR2PCIEBAR_3           = 64'h0000_0000_0000_0000,
  parameter [63:0]C_AXIBAR2PCIEBAR_4           = 64'h0000_0000_0000_0000,
  parameter [63:0]C_AXIBAR2PCIEBAR_5           = 64'h0000_0000_0000_0000,
  parameter       EN_AXI_SLAVE_IF              = "TRUE",
  parameter       EN_AXI_MASTER_IF             = "TRUE",
  parameter       C_INCLUDE_BAROFFSET_REG      = 1,
  parameter [31:0]C_BASEADDR                   = 32'hFFFF_FFFF,
  parameter [31:0]C_HIGHADDR                   = 32'h0000_0000,
  parameter       C_S_AXI_NUM_READ             = 8,
  parameter       C_M_AXI_NUM_READ             = 8,
  parameter       C_S_AXI_NUM_WRITE            = 8,
  parameter       C_M_AXI_NUM_WRITE            = 8,
  parameter       MSIX_IMPL_EXT                = "TRUE",
  parameter       AXI_ACLK_LOOPBACK            = "FALSE",
  parameter       PL_DISABLE_UPCONFIG_CAPABLE  = "FALSE",
  parameter       PF0_BAR0_APERTURE_SIZE       = 5'b00011,
  parameter       PF0_BAR0_CONTROL             = 3'b100,
  parameter       PF0_BAR1_APERTURE_SIZE       = 5'b00000,
  parameter       PF0_BAR1_CONTROL             = 3'b000,
  parameter       PF0_BAR2_APERTURE_SIZE       = 5'b00011,
  parameter       PF0_BAR2_CONTROL             = 3'b100,
  parameter       PF0_BAR3_APERTURE_SIZE       = 5'b00011,
  parameter       PF0_BAR3_CONTROL             = 3'b000,
  parameter       PF0_BAR4_APERTURE_SIZE       = 5'b00011,
  parameter       PF0_BAR4_CONTROL             = 3'b100,
  parameter       PF0_BAR5_APERTURE_SIZE       = 5'b00011,
  parameter       PF0_BAR5_CONTROL             = 3'b000,
  parameter       PF0_EXPANSION_ROM_ENABLE     = "FALSE",
  parameter [4:0] PF0_EXPANSION_ROM_APERTURE_SIZE = 5'b00011,
  parameter       PF1_BAR0_APERTURE_SIZE       = 5'b00011,
  parameter       PF1_BAR0_CONTROL             = 3'b100,
  parameter       PF1_BAR1_APERTURE_SIZE       = 5'b00000,
  parameter       PF1_BAR1_CONTROL             = 3'b000,
  parameter       PF1_BAR2_APERTURE_SIZE       = 5'b00011,
  parameter       PF1_BAR2_CONTROL             = 3'b100,
  parameter       PF1_BAR3_APERTURE_SIZE       = 5'b00011,
  parameter       PF1_BAR3_CONTROL             = 3'b000,
  parameter       PF1_BAR4_APERTURE_SIZE       = 5'b00011,
  parameter       PF1_BAR4_CONTROL             = 3'b100,
  parameter       PF1_BAR5_APERTURE_SIZE       = 5'b00011,
  parameter       PF1_BAR5_CONTROL             = 3'b000,
  parameter       PF1_EXPANSION_ROM_ENABLE     = "FALSE",
  parameter [4:0] PF1_EXPANSION_ROM_APERTURE_SIZE = 5'b00011,
  parameter [63:0]PF1_PCIEBAR2AXIBAR_0         = 64'h0000000000000000,
  parameter [63:0]PF1_PCIEBAR2AXIBAR_1         = 64'h0000000000000000,
  parameter [63:0]PF1_PCIEBAR2AXIBAR_2         = 64'h0000000000000000,
  parameter [63:0]PF1_PCIEBAR2AXIBAR_3         = 64'h0000000000000000,
  parameter [63:0]PF1_PCIEBAR2AXIBAR_4         = 64'h0000000000000000,
  parameter [63:0]PF1_PCIEBAR2AXIBAR_5         = 64'h0000000000000000,
  parameter [63:0]PF1_PCIEBAR2AXIBAR_6         = 64'h0000000000000000,
  parameter       PCIEBAR_NUM                  = 6,
  parameter [63:0]C_PCIEBAR2AXIBAR_3           = 64'h00000000,
  parameter [63:0]C_PCIEBAR2AXIBAR_4           = 64'h00000000,
  parameter [63:0]C_PCIEBAR2AXIBAR_5           = 64'h00000000,
  parameter [63:0]C_PCIEBAR2AXIBAR_6           = 64'h00000000,
  parameter       BARLITE1                     = 0,
  parameter       BARLITE2                     = 0,
  parameter       C_MSIX_INT_TABLE_EN          = 1,
  parameter       VCU118_BOARD                 = "FALSE",
  parameter       TCQ                          = 1,
  parameter       C_AXIBAR_AS_0                = 1,
  parameter       C_AXIBAR_AS_1                = 1,
  parameter       C_AXIBAR_AS_2                = 1,
  parameter       C_AXIBAR_AS_3                = 1,
  parameter       C_AXIBAR_AS_4                = 1,
  parameter       C_AXIBAR_AS_5                = 1,
  parameter       C_MSI_ENABLED                = MSI_ENABLED,
  parameter       C_NUM_DSC_PCIE_RID           = 32,
  parameter       C_NUM_PCIE_DSC_CPL_DID       = 256,
  parameter       C_NUM_AXI_DSC_CPL_DID        = 64,
  parameter [7:0] MULTQ_CHNL                   = 8'h00,
  parameter       IMPL_TARGET                  = "SOFT",
  parameter       C_M_AXI_DATA_WIDTH           = AXI_DATA_WIDTH,
  parameter       C_M_AXI_WUSER_WIDTH          = C_M_AXI_DATA_WIDTH/8,
  parameter       C_M_AXI_BUSER_WIDTH          = 1,
  parameter       C_M_AXI_RUSER_WIDTH          = C_M_AXI_DATA_WIDTH/8,
  parameter       USE_ATTR                     = 0,  // dont want to use Attribute
  parameter       XDMA_DSC_ENG                 = 1,  // Use XDMA dsc format
  parameter       C_H2C_TUSER_WIDTH            = 48,
  parameter       C_C2H_TUSER_WIDTH            = 64,
  parameter       C_AXIBAR_REGIONEN            = 0,
  parameter       C_AXIBAR_NOXLATE             = 0,
  parameter       C_AXIBAR2PCIEATTR_0          = 3'b000,
  parameter       C_AXIBAR2PCIEATTR_1          = 3'b000,
  parameter       C_AXIBAR2PCIEATTR_2          = 3'b000,
  parameter       C_AXIBAR2PCIEATTR_3          = 3'b000,
  parameter       C_AXIBAR2PCIEATTR_4          = 3'b000,
  parameter       C_AXIBAR2PCIEATTR_5          = 3'b000,
  parameter       C_IGNORE_SIZE_AXI_SLAVE      = 1,
  parameter       C_TIMEOUT0_SEL               = 4'h14,
  parameter       C_TIMEOUT1_SEL               = 4'h15,
  parameter       C_TIMEOUT_MULT               = 3'h3,
  parameter       C_OLD_BRIDGE_TIMEOUT         = 0,
  parameter       C_LAST_CORE_CAP_ADDR         = 12'h100,     // DWORD address of last enabled block capability
  parameter       C_VSEC_CAP_ADDR              = 12'h128,     // DWORD address of start of VSEC Header
  parameter       C_VSEC_CAP_LAST              = "FALSE",     // VSEC next capability offset control
  parameter       C_VSEC_ID                    = 16'h0000,
  parameter       C_NUM_USER_INTR              = 9,           // Number of user interrupts in User interrupt vector
  parameter       C_NUM_USER_NEW_INTR          = 6,           // Number of user interrupts in User interrupt vector
  parameter       C_USER_PTR                   = 16'h00D8,    // Address pointer to User Space
  parameter       C_S_AXI_SUPPORTS_NARROW_BURST= 0,
  parameter       C_S_AXI_ID_WIDTH             = 4,
  parameter       C_S_AXI_ADDR_WIDTH           = 64,
  parameter       C_S_AXI_DATA_WIDTH           = AXI_DATA_WIDTH,
  parameter       C_M_AXI_ADDR_WIDTH           = 64,
  parameter       C_S_AXIS_DATA_WIDTH          = AXI_DATA_WIDTH,
  parameter       C_M_AXIS_DATA_WIDTH          = AXI_DATA_WIDTH,
  parameter       C_M_AXIS_RQ_USER_WIDTH       = 60,
  parameter       C_S_AXIS_CQP_USER_WIDTH      = 85,
  parameter       C_S_AXIS_CQ_USER_WIDTH       = 85,
  parameter       C_M_AXIS_RC_USER_WIDTH       = 75,
  parameter       C_S_AXIS_CC_USER_WIDTH       = 33,
  parameter       C_M_AXIL_AWUSER_WIDTH        = 11,
  parameter       C_M_AXIL_ARUSER_WIDTH        = 11,
  parameter       C_M_AXI_AWUSER_WIDTH         = 8,
  parameter       C_M_AXI_ARUSER_WIDTH         = 8,
  parameter       C_S_KEEP_WIDTH               = C_S_AXI_DATA_WIDTH / 32,
  parameter       C_M_KEEP_WIDTH               = C_M_AXI_DATA_WIDTH / 32,
  parameter       C_KEEP_WIDTH                 = AXI_DATA_WIDTH/8,
  parameter       C_S_AXIS_USER_WIDTH          = 64,
  parameter       C_M_AXIS_USER_WIDTH          = 64,
  parameter       C_ADDR_ALGN                  = 1, // Bytes
  parameter       C_ECC_ENABLE                 = 0,
  parameter       C_DSC_MAGIC_EN               = 1,
  parameter       C_NUMQ_PER_CHNL              = 256,
  parameter       C_SLAVE_READ_64OS_EN         = 0,
  parameter       C_RD_BUFFER_ADDR_SIZE        = C_SLAVE_READ_64OS_EN ? 10 : 9,
  parameter       C_RD_BUFFER_SIZE_BITS        = C_SLAVE_READ_64OS_EN ?  6 : 5,
  parameter       C_PCIEBAR_NUM                = PCIEBAR_NUM,
  parameter       C_PCIEBAR_AS                 = 1,
  parameter       C_NUM_MSIX_VECTORS           = 32,
  parameter       DMA_SP                       = 0,
  parameter       DMA_MM                       = 1,
  parameter       DMA_ST                       = 0,
  parameter       DMA_RESET_SOURCE_SEL         = 0,
  parameter       C_ADDR_BITS                  = 64,
  parameter       STS_WIDTH                    = 8,
  parameter       BACKPRESSURE                 = 0,
  parameter       USR_MPL_SIZE                 = 4096,
  parameter       USR_MRS_SIZE                 = 4096,
  parameter       PMON_EN                      = 1,
  parameter       MULT_PF_DES                  = "FALSE",
  parameter       SPLIT_DMA                    = "FALSE",
  parameter       SPLIT_DMA_SINGLE_PF          = "FALSE",
  parameter       PIPE_LINE_STAGE              = 2,
  parameter       AXIS_PIPE_LINE_STAGE         = 2,
  parameter       VU9P_TUL_EX                  = "FALSE",
  parameter       PCIE_BLK_TYPE                = 0,
  parameter       GEN4_EIEOS_0S7               = "FALSE",
  parameter       CCIX_ENABLE                  = "FALSE",
  parameter       CCIX_DVSEC	                 = "FALSE",
  parameter       ENABLE_ATS_SWITCH            = "FALSE",
  parameter       CDC_WB_EN                    = 1,
  parameter       AXIS_CCIX_RX_TDATA_WIDTH     = (AXI_DATA_WIDTH == 512 ? 512 : 256),
  parameter       AXIS_CCIX_TX_TDATA_WIDTH     = (AXI_DATA_WIDTH == 512 ? 512 : 256),
  parameter       AXIS_CCIX_RX_TUSER_WIDTH     = (AXI_DATA_WIDTH == 512 ? 101 : 47),
  parameter       AXIS_CCIX_TX_TUSER_WIDTH     = (AXI_DATA_WIDTH == 512 ? 101 : 47),
  parameter       C_ATS_DATA_WIDTH             = AXI_DATA_WIDTH,
  parameter       C_ATS_CQ_TUSER_WIDTH         = C_S_AXIS_CQ_USER_WIDTH,
  parameter       C_ATS_CC_TUSER_WIDTH         = C_S_AXIS_CC_USER_WIDTH,
  parameter       C_ATS_RQ_TUSER_WIDTH         = C_M_AXIS_RQ_USER_WIDTH,
  parameter       C_ATS_RC_TUSER_WIDTH         = C_M_AXIS_RC_USER_WIDTH,
  parameter       C_ATS_SWITCH_UNIQUE_BDF      = 1,
  parameter       EXT_SYS_CLK_BUFG             = "FALSE",
  parameter       GTCOM_IN_CORE                = 1,
  parameter       C_NUM_OF_SC                  = 1,
  parameter       USR_IRQ_EXDES                = "FALSE",
  parameter       AXI_VIP_IN_EXDES             = "FALSE",
  parameter       XDMA_NON_INCREMENTAL_EXDES   = "FALSE",
  parameter       XDMA_ST_INFINITE_DESC_EXDES  = "FALSE",
  parameter       ACS_EXT_CAP_ENABLE           = "FALSE",
  parameter       EXT_XVC_VSEC_ENABLE          = "FALSE",
  parameter       EN_PCIE_DEBUG_PORTS          = "FALSE",
  parameter       MULTQ_EN                     = 0,
  parameter       C_PCIE_PFS_SUPPORTED         = 0,
  parameter       C_SRIOV_EN                   = 0,
  parameter       BARLITE_EXT_PF0              = 6'h00,
  parameter       BARLITE_EXT_PF1              = 6'h00,
  parameter       BARLITE_EXT_PF2              = 6'h00,
  parameter       BARLITE_EXT_PF3              = 6'h00,
  parameter       BARLITE_INT_PF0              = 6'h01,
  parameter       BARLITE_INT_PF1              = 6'h00,
  parameter       BARLITE_INT_PF2              = 6'h00,
  parameter       BARLITE_INT_PF3              = 6'h00,
  parameter       NUM_VFS_PF0                  = 4,
  parameter       NUM_VFS_PF1                  = 0,
  parameter       NUM_VFS_PF2                  = 0,
  parameter       NUM_VFS_PF3                  = 0,
  parameter       FIRSTVF_OFFSET_PF0           = 0,
  parameter       FIRSTVF_OFFSET_PF1           = 0,
  parameter       FIRSTVF_OFFSET_PF2           = 0,
  parameter       FIRSTVF_OFFSET_PF3           = 0,
  parameter       VF_BARLITE_EXT_PF0           = 6'h00,
  parameter       VF_BARLITE_EXT_PF1           = 6'h00,
  parameter       VF_BARLITE_EXT_PF2           = 6'h00,
  parameter       VF_BARLITE_EXT_PF3           = 6'h00,
  parameter       VF_BARLITE_INT_PF0           = 6'h01,
  parameter       VF_BARLITE_INT_PF1           = 6'h00,
  parameter       VF_BARLITE_INT_PF2           = 6'h00,
  parameter       VF_BARLITE_INT_PF3           = 6'h00,
  parameter       C_C2H_NUM_CHNL               = 4,
  parameter       C_H2C_NUM_CHNL               = 4,
  parameter       H2C_XDMA_CHNL                = 8'h0F,
  parameter       C2H_XDMA_CHNL                = 8'h0F,
  parameter[17:0] AXISTEN_IF_ENABLE_MSG_ROUTE  =18'h0,
  parameter       ENABLE_MORE                  ="FALSE",
  parameter       DISABLE_BRAM_PIPELINE        ="FALSE",
  parameter       DISABLE_EQ_SYNCHRONIZER      ="FALSE",
  parameter       C_ENABLE_RESOURCE_REDUCTION  ="FALSE",
  parameter       C_ATS_ENABLE                 ="FALSE",
  parameter       C_PRI_ENABLE                 ="FALSE",
  parameter       C_FF_ON_INT_IF               ="FALSE",
  parameter       SOFT_RESET_EN                ="FALSE",
  parameter[29:0] C_ATS_OFFSET                 = 30'h120, // In DW offset; << 2 bits for Byte offset
  parameter[29:0] C_PR_OFFSET                  = 30'h124, // In DW offset; << 2 bits for Byte offset
  parameter[11:0] C_ATS_CAP_NEXTPTR            = 12'h000,
  parameter[11:0] C_PR_CAP_NEXTPTR             = 12'h000,
  parameter[4:0]  C_INV_QUEUE_DEPTH            = 5'h00,
  parameter[1:0]  TL_PF_ENABLE_REG             = 2'h0,
  parameter       PCIE_ID_IF                   = "FALSE",
  parameter[31:0] C_OST_PR_CAP                 = 32'h0,
  parameter       AXSIZE_BYTE_ACCESS_EN        = "FALSE",
  parameter       PF_SWAP                      = "FALSE",
  parameter    [4:0]PF0_MSIX_TAR_ID            = 5'h8,
  parameter    [4:0]PF1_MSIX_TAR_ID            = 5'h9,
  parameter       RUNBIT_FIX                   = "FALSE",
  parameter       RBAR_ENABLE                  = "FALSE",
  parameter       C_SMMU_EN                    = 0,
  parameter       C_M_AXI_NUM_READQ            = 2,
  parameter       USE_STANDARD_INTERFACES      = "FALSE",
  parameter       DMA_2RP                      = "FALSE",
  parameter       SRIOV_ACTIVE_VFS             = 252
)
(
  sys_clk,
  sys_clk_ce_out,
  sys_clk_gt,
  sys_rst_n,
  dma_bridge_resetn,
  user_lnk_up,
  cfg_ltssm_state,

  pci_exp_txp,
  pci_exp_txn,
  pci_exp_rxp,
  pci_exp_rxn,

  free_run_clock,

  gt_drp_clk,
  axi_aclk,
  axi_aresetn,

  axi_ctl_aclk,
  axi_ctl_aresetn,

  usr_irq_req,
  usr_irq_ack,
  usr_irq_function_number,
  msi_enable,
  msix_enable,
  msi_vector_width,

  // AXI MM interface
  m_axi_awid,
  m_axi_awaddr,
  m_axi_awlen,
  m_axi_awsize,
  m_axi_awburst,
  m_axi_awprot,
  m_axi_awvalid,
  m_axi_awready,
  m_axi_awlock,
  m_axi_awcache,
  m_axi_wdata,
  m_axi_wuser,
  m_axi_wstrb,
  m_axi_wlast,
  m_axi_wvalid,
  m_axi_wready,
  m_axi_bid,
  m_axi_bresp,
  m_axi_bvalid,
  m_axi_bready,
  m_axi_arid,
  m_axi_araddr,
  m_axi_arlen,
  m_axi_arsize,
  m_axi_arburst,
  m_axi_arprot,
  m_axi_arvalid,
  m_axi_arready,
  m_axi_arlock,
  m_axi_arcache,
  m_axi_rid,
  m_axi_rdata,
  m_axi_ruser,
  m_axi_rresp,
  m_axi_rlast,
  m_axi_rvalid,
  m_axi_rready,

  // AXI BYPASS interface
  m_axib_awid,
  m_axib_awaddr,
  m_axib_awuser,
  m_axib_awlen,
  m_axib_awsize,
  m_axib_awburst,
  m_axib_awprot,
  m_axib_awvalid,
  m_axib_awready,
  m_axib_awlock,
  m_axib_awcache,
  m_axib_wdata,
  m_axib_wuser,
  m_axib_wstrb,
  m_axib_wlast,
  m_axib_wvalid,
  m_axib_wready,
  m_axib_bid,
  m_axib_bresp,
  m_axib_bvalid,
  m_axib_bready,
  m_axib_arid,
  m_axib_araddr,
  m_axib_aruser,
  m_axib_arlen,
  m_axib_arsize,
  m_axib_arburst,
  m_axib_arprot,
  m_axib_arvalid,
  m_axib_arready,
  m_axib_arlock,
  m_axib_arcache,
  m_axib_rid,
  m_axib_rdata,
  m_axib_ruser,
  m_axib_rresp,
  m_axib_rlast,
  m_axib_rvalid,
  m_axib_rready,

// AXI-Slave Interface (BRIDGE)
  s_axib_awid,
  s_axib_awaddr,
  s_axib_awregion,
  s_axib_awlen,
  s_axib_awsize,
  s_axib_awburst,
  s_axib_awvalid,
  s_axib_awready,
  s_axib_wdata,
  s_axib_wstrb,
  s_axib_wlast,
  s_axib_wvalid,
  s_axib_wready,
  s_axib_bid,
  s_axib_bresp,
  s_axib_bvalid,
  s_axib_bready,
  s_axib_arid,
  s_axib_araddr,
  s_axib_arregion,
  s_axib_arlen,
  s_axib_arsize,
  s_axib_arburst,
  s_axib_arvalid,
  s_axib_arready,
  s_axib_rid,
  s_axib_rresp,
  s_axib_rlast,
  s_axib_rvalid,
  s_axib_rdata,
  s_axib_wuser,
  s_axib_ruser,
  s_axib_rready,
  interrupt_out,
  interrupt_out_msi_vec0to31,
  interrupt_out_msi_vec32to63,
  interrupt_out_msix_0,
  interrupt_out_msix_1,
  interrupt_out_msix_2,
  interrupt_out_msix_3,
  s_axis_c2h_tdata_0,
  s_axis_c2h_tlast_0,
  s_axis_c2h_tuser_0,
  s_axis_c2h_tkeep_0,
  s_axis_c2h_tvalid_0,
  s_axis_c2h_tready_0,

  m_axis_h2c_tdata_0,
  m_axis_h2c_tlast_0,
  m_axis_h2c_tuser_0,
  m_axis_h2c_tkeep_0,
  m_axis_h2c_tvalid_0,
  m_axis_h2c_tready_0,

  s_axis_c2h_tdata_1,
  s_axis_c2h_tlast_1,
  s_axis_c2h_tuser_1,
  s_axis_c2h_tkeep_1,
  s_axis_c2h_tvalid_1,
  s_axis_c2h_tready_1,

  m_axis_h2c_tdata_1,
  m_axis_h2c_tlast_1,
  m_axis_h2c_tuser_1,
  m_axis_h2c_tkeep_1,
  m_axis_h2c_tvalid_1,
  m_axis_h2c_tready_1,

  s_axis_c2h_tdata_2,
  s_axis_c2h_tlast_2,
  s_axis_c2h_tuser_2,
  s_axis_c2h_tkeep_2,
  s_axis_c2h_tvalid_2,
  s_axis_c2h_tready_2,

  m_axis_h2c_tdata_2,
  m_axis_h2c_tlast_2,
  m_axis_h2c_tuser_2,
  m_axis_h2c_tkeep_2,
  m_axis_h2c_tvalid_2,
  m_axis_h2c_tready_2,

  s_axis_c2h_tdata_3,
  s_axis_c2h_tlast_3,
  s_axis_c2h_tuser_3,
  s_axis_c2h_tkeep_3,
  s_axis_c2h_tvalid_3,
  s_axis_c2h_tready_3,

  m_axis_h2c_tdata_3,
  m_axis_h2c_tlast_3,
  m_axis_h2c_tuser_3,
  m_axis_h2c_tkeep_3,
  m_axis_h2c_tvalid_3,
  m_axis_h2c_tready_3,

  // AXI-Lite Interface
  m_axil_awaddr,
  m_axil_awuser,
  m_axil_awprot,
  m_axil_awvalid,
  m_axil_awready,
  m_axil_wdata,
  m_axil_wstrb,
  m_axil_wvalid,
  m_axil_wready,
  m_axil_bvalid,
  m_axil_bresp,
  m_axil_bready,
  m_axil_araddr,
  m_axil_aruser,
  m_axil_arprot,
  m_axil_arvalid,
  m_axil_arready,
  m_axil_rdata,
  m_axil_rresp,
  m_axil_rvalid,
  m_axil_rready,

  // AXI-Lite Interface
  s_axil_awaddr,
  s_axil_awprot,
  s_axil_awvalid,
  s_axil_awready,
  s_axil_wdata,
  s_axil_wstrb,
  s_axil_wvalid,
  s_axil_wready,
  s_axil_bvalid,
  s_axil_bresp,
  s_axil_bready,
  s_axil_araddr,
  s_axil_arprot,
  s_axil_arvalid,
  s_axil_arready,
  s_axil_rdata,
  s_axil_rresp,
  s_axil_rvalid,
  s_axil_rready,

  // Descriptor Bypass
  c2h_dsc_byp_ready_0,
  c2h_dsc_byp_src_addr_0,
  c2h_dsc_byp_dst_addr_0,
  c2h_dsc_byp_len_0,
  c2h_dsc_byp_ctl_0,
  c2h_dsc_byp_load_0,

  c2h_dsc_byp_ready_1,
  c2h_dsc_byp_src_addr_1,
  c2h_dsc_byp_dst_addr_1,
  c2h_dsc_byp_len_1,
  c2h_dsc_byp_ctl_1,
  c2h_dsc_byp_load_1,

  c2h_dsc_byp_ready_2,
  c2h_dsc_byp_src_addr_2,
  c2h_dsc_byp_dst_addr_2,
  c2h_dsc_byp_len_2,
  c2h_dsc_byp_ctl_2,
  c2h_dsc_byp_load_2,

  c2h_dsc_byp_ready_3,
  c2h_dsc_byp_src_addr_3,
  c2h_dsc_byp_dst_addr_3,
  c2h_dsc_byp_len_3,
  c2h_dsc_byp_ctl_3,
  c2h_dsc_byp_load_3,

  h2c_dsc_byp_ready_0,
  h2c_dsc_byp_src_addr_0,
  h2c_dsc_byp_dst_addr_0,
  h2c_dsc_byp_len_0,
  h2c_dsc_byp_ctl_0,
  h2c_dsc_byp_load_0,

  h2c_dsc_byp_ready_1,
  h2c_dsc_byp_src_addr_1,
  h2c_dsc_byp_dst_addr_1,
  h2c_dsc_byp_len_1,
  h2c_dsc_byp_ctl_1,
  h2c_dsc_byp_load_1,

  h2c_dsc_byp_ready_2,
  h2c_dsc_byp_src_addr_2,
  h2c_dsc_byp_dst_addr_2,
  h2c_dsc_byp_len_2,
  h2c_dsc_byp_ctl_2,
  h2c_dsc_byp_load_2,

  h2c_dsc_byp_ready_3,
  h2c_dsc_byp_src_addr_3,
  h2c_dsc_byp_dst_addr_3,
  h2c_dsc_byp_len_3,
  h2c_dsc_byp_ctl_3,
  h2c_dsc_byp_load_3,

  c2h_sts_0,
  h2c_sts_0,
  c2h_sts_1,
  h2c_sts_1,
  c2h_sts_2,
  h2c_sts_2,
  c2h_sts_3,
  h2c_sts_3,

  pipe_debug_ctl_in_tx0,
  pipe_debug_ctl_in_tx1,
  pipe_debug_ctl_in_rx0,
  pipe_debug_ctl_in_rx1,
  pipe_debug_ltssm_rec_spd_1,
  pipe_debug_ltssm_pol_act,
  pipe_debug_ctl_vec4,
  pipe_debug_mux_ctl,
  pipe_debug_debug_out_128_0,
  pipe_debug_debug_out_ext_16_0,
  pipe_debug_debug_out_128_1,
  pipe_debug_debug_out_ext_16_1,
  pipe_debug_debug_out_128_2,
  pipe_debug_debug_out_ext_16_2,
  pipe_debug_debug_out_128_3,
  pipe_debug_debug_out_ext_16_3,
  pipe_debug_inject_tx_status,
  pipe_debug_inject_rx_status,


  cfg_vend_id,
  cfg_subsys_vend_id,
  cfg_dev_id_pf0,
  cfg_rev_id_pf0,
  cfg_subsys_id_pf0,
  cfg_dev_id_pf1,
  cfg_rev_id_pf1,
  cfg_subsys_id_pf1,
  cfg_dev_id_pf2,
  cfg_rev_id_pf2,
  cfg_subsys_id_pf2,
  cfg_dev_id_pf3,
  cfg_rev_id_pf3,
  cfg_subsys_id_pf3,
  common_commands_in,
  pipe_rx_0_sigs,
  pipe_rx_1_sigs,
  pipe_rx_2_sigs,
  pipe_rx_3_sigs,
  pipe_rx_4_sigs,
  pipe_rx_5_sigs,
  pipe_rx_6_sigs,
  pipe_rx_7_sigs,
  pipe_rx_8_sigs,
  pipe_rx_9_sigs,
  pipe_rx_10_sigs,
  pipe_rx_11_sigs,
  pipe_rx_12_sigs,
  pipe_rx_13_sigs,
  pipe_rx_14_sigs,
  pipe_rx_15_sigs,
  common_commands_out,
  pipe_tx_0_sigs,
  pipe_tx_1_sigs,
  pipe_tx_2_sigs,
  pipe_tx_3_sigs,
  pipe_tx_4_sigs,
  pipe_tx_5_sigs,
  pipe_tx_6_sigs,
  pipe_tx_7_sigs,
  pipe_tx_8_sigs,
  pipe_tx_9_sigs,
  pipe_tx_10_sigs,
  pipe_tx_11_sigs,
  pipe_tx_12_sigs,
  pipe_tx_13_sigs,
  pipe_tx_14_sigs,
  pipe_tx_15_sigs,

  cfg_mgmt_addr,
  cfg_mgmt_write,
  cfg_mgmt_write_data,
  cfg_mgmt_byte_enable,
  cfg_mgmt_read,
  cfg_mgmt_read_data,
  cfg_mgmt_read_write_done,
  cfg_mgmt_type1_cfg_reg_access,

  pipe_txprbssel,
  pipe_rxprbssel,
  pipe_txprbsforceerr,
  pipe_rxprbscntreset,
  pipe_loopback,
  pipe_rxprbserr,
  pipe_txinhibit,
  pipe_rst_fsm,
  pipe_qrst_fsm,
  pipe_rate_fsm,
  pipe_sync_fsm_tx,
  pipe_sync_fsm_rx,
  pipe_drp_fsm,
  pipe_rst_idle,
  pipe_qrst_idle,
  pipe_rate_idle,
  pipe_eyescandataerror,
  pipe_rxstatus,
  pipe_dmonitorout,
  pipe_cpll_lock,
  pipe_qpll_lock,
  pipe_rxpmaresetdone,
  pipe_rxbufstatus,
  pipe_txphaligndone,
  pipe_txphinitdone,
  pipe_txdlysresetdone,
  pipe_rxphaligndone,
  pipe_rxdlysresetdone,
  pipe_rxsyncdone,
  pipe_rxdisperr,
  pipe_rxnotintable,
  pipe_rxcommadet,
  gt_ch_drp_rdy,
  pipe_debug_0,
  pipe_debug_1,
  pipe_debug_2,
  pipe_debug_3,
  pipe_debug_4,
  pipe_debug_5,
  pipe_debug_6,
  pipe_debug_7,
  pipe_debug_8,
  pipe_debug_9,
  pipe_debug,

  gt_pcieuserratedone,
  gt_loopback,
  gt_txprbsforceerr,
  gt_txinhibit,
  gt_txprbssel,
  gt_rxprbssel,
  gt_rxprbscntreset,
  gt_dmonitorclk,
  gt_dmonfiforeset,
  gt_txelecidle,
  gt_txresetdone,
  gt_rxresetdone,
  gt_rxpmaresetdone,
  gt_txphaligndone,
  gt_txphinitdone,
  gt_txdlysresetdone,
  gt_rxphaligndone,
  gt_rxdlysresetdone,
  gt_rxsyncdone,
  gt_eyescandataerror,
  gt_rxprbserr,
  gt_dmonitorout,
  gt_rxcommadet,
  gt_phystatus,
  gt_rxvalid,
  gt_rxcdrlock,
  gt_pcierateidle,
  gt_pcieuserratestart,
  gt_gtpowergood,
  gt_cplllock,
  gt_rxoutclk,
  gt_rxrecclkout,
  gt_qpll1lock,
  gt_rxstatus,
  gt_rxbufstatus,
  gt_bufgtdiv,
  phy_txeq_ctrl,
  phy_txeq_preset,
  phy_rst_fsm,
  phy_txeq_fsm,
  phy_rxeq_fsm,
  phy_rst_idle,
  phy_rrst_n,
  phy_prst_n,

  ext_ch_gt_drpclk,
  ext_ch_gt_drpaddr,
  ext_ch_gt_drpen,
  ext_ch_gt_drpwe,
  ext_ch_gt_drpdi,
  ext_ch_gt_drprdy,
  ext_ch_gt_drpdo,
  //--------------------------------------------------------------------------------------//
  //  MCAP Design Switch signal                                                           //
  //   - This signal goes high once the tandem stage2 bitstream is loaded.                //
  //   - This signal may be asserted high by SW after the first PR programming sequence   //
  //     has completed.                                                                   //
  //   - After going high, this signal should not be written back to zero by SW.          //
  //--------------------------------------------------------------------------------------//
  mcap_design_switch,
  //--------------------------------------------------------------------------------------//
  //  Configuration Arbitration Signals                                                   //
  //    - These signals should be used to arbitrate for control of the underlying FPGA    //
  //      Configuration logic. Request, Grant, and Release signals should be connected in //
  //      the user design.                                                                //
  //--------------------------------------------------------------------------------------//
  cap_req,
  cap_gnt,
  cap_rel,
  //--------------------------------------------------------------------------------------//
  //  End of Startup (EOS) Signal                                                         //
  //    - This singal should be driven directly by the End of Startup (EOS) output of     //
  //      the STARTUP primitive                                                           //
  //--------------------------------------------------------------------------------------//
  mcap_eos_in,
  //--------------------------------------------------------------------------------------//
  //  Startup Signals                                                                     //
  //    - The startup interface is exposed to the external user for connectifity to other //
  //      IPs                                                                             //
  //--------------------------------------------------------------------------------------//
  startup_cfgclk,
  startup_cfgmclk,
  startup_di,
  startup_eos,
  startup_preq,
  startup_do,
  startup_dts,
  startup_fcsbo,
  startup_fcsbts,
  startup_gsr,
  startup_gts,
  startup_keyclearb,
  startup_pack,
  startup_usrcclko,
  startup_usrcclkts,
  startup_usrdoneo,
  startup_usrdonets,

  drp_rdy,
  drp_do,
  drp_clk,
  drp_en,
  drp_we,
  drp_addr,
  drp_di,

  cfg_ext_read_received,
  cfg_ext_write_received,
  cfg_ext_register_number,
  cfg_ext_function_number,
  cfg_ext_write_data,
  cfg_ext_write_byte_enable,
  cfg_ext_read_data,
  cfg_ext_read_data_valid,

  // --- Shared Logic Clock Internal Interface for pcie3_7x
  int_pclk_out_slave,
  int_pipe_rxusrclk_out,
  int_rxoutclk_out,
  int_dclk_out,
  int_userclk1_out,
  int_userclk2_out,
  int_oobclk_out,
  int_qplllock_out,
  int_qplloutclk_out,
  int_qplloutrefclk_out,
  int_pclk_sel_slave,

  // --- Shared Logic Clock External Interface for pcie3_7x
  pipe_pclk_in,
  pipe_rxusrclk_in,
  pipe_rxoutclk_in,
  pipe_dclk_in,
  pipe_userclk1_in,
  pipe_userclk2_in,
  pipe_oobclk_in,
  pipe_mmcm_rst_n,
  pipe_mmcm_lock_in,
  pipe_txoutclk_out,
  pipe_rxoutclk_out,
  pipe_pclk_sel_out,
  pipe_gen3_out,

  // --- Shared Logic External GT COMMON for pcie3_7x
  qpll_drp_crscode,
  qpll_drp_fsm,
  qpll_drp_done,
  qpll_drp_reset,
  qpll_qplllock,
  qpll_qplloutclk,
  qpll_qplloutrefclk,
  qpll_qplld,
  qpll_qpllreset,
  qpll_drp_clk,
  qpll_drp_rst_n,
  qpll_drp_ovrd,
  qpll_drp_gen3,
  qpll_drp_start,

  // --- Shared Logic GT_COMMON Internal Interface for pcie3_us
  int_qpll1lock_out,
  int_qpll1outclk_out,
  int_qpll1outrefclk_out,

  // --- Shared Logic GT_COMMON External Interface for pcie3_us
  ext_qpll1refclk,
  ext_qpll1pd,
  ext_qpll1rate,
  ext_qpll1reset,
  ext_qpll1lock_out,
  ext_qpll1outclk_out,
  ext_qpll1outrefclk_out,

  m_axis_rq_tdata_out,
  m_axis_rq_tlast_out,
  m_axis_rq_tuser_out,
  m_axis_rq_tkeep_out,
  m_axis_rq_tready_out,
  m_axis_rq_tvalid_out,

  s_axis_rc_tdata_out,
  s_axis_rc_tuser_out,
  s_axis_rc_tlast_out,
  s_axis_rc_tkeep_out,
  s_axis_rc_tvalid_out,
  s_axis_rc_tready_out,

  s_axis_cq_tdata_out,
  s_axis_cq_tuser_out,
  s_axis_cq_tlast_out,
  s_axis_cq_tkeep_out,
  s_axis_cq_tvalid_out,
  s_axis_cq_tready_out,

  m_axis_cc_tdata_out,
  m_axis_cc_tuser_out,
  m_axis_cc_tlast_out,
  m_axis_cc_tkeep_out,
  m_axis_cc_tvalid_out,
  m_axis_cc_tready_out,

  gt_qpll0lock,
  gt_gen34_eios_det,
  gt_txoutclk,
  gt_txoutclkfabric,
  gt_rxoutclkfabric,
  gt_txoutclkpcs,
  gt_rxoutclkpcs,
  gt_txpmareset,
  gt_rxpmareset,
  gt_txpcsreset,
  gt_rxpcsreset,
  gt_rxbufreset,
  gt_rxcdrreset,
  gt_rxdfelpmreset,
  gt_txprogdivresetdone,
  gt_txpmaresetdone,
  gt_txsyncdone,
  gt_rxprbslocked,

  //--------------------------------------------------------------------------
  //  GT WIZARD IP is not in the US PCIe core
  //--------------------------------------------------------------------------
  bufgtce_us_out ,
  bufgtcemask_us_out ,
  bufgtdiv_us_out ,
  bufgtreset_us_out ,
  bufgtrstmask_us_out ,
  cplllock_us_out,
  dmonitorout_us_out,
  drpdo_us_out,
  drprdy_us_out,
  eyescandataerror_us_out,
  gthtxn_us_out,
  gthtxp_us_out,
  gtpowergood_us_out,
  pcierategen3_us_out,
  pcierateidle_us_out,
  pcierateqpllpd_us_out,
  pcierateqpllreset_us_out,
  pciesynctxsyncdone_us_out,
  pcieusergen3rdy_us_out,
  pcieuserphystatusrst_us_out,
  pcieuserratestart_us_out,
  pcsrsvdout_us_out,
  phystatus_us_out,
  rxbufstatus_us_out,
  rxbyteisaligned_us_out,
  rxbyterealign_us_out,
  rxcdrlock_us_out,
  rxclkcorcnt_us_out,
  rxcommadet_us_out,
  rxctrl0_us_out,
  rxctrl1_us_out,
  rxctrl2_us_out,
  rxctrl3_us_out,
  rxdata_us_out,
  rxdlysresetdone_us_out,
  rxelecidle_us_out,
  rxoutclk_us_out,
  rxphaligndone_us_out,
  rxpmaresetdone_us_out,
  rxprbserr_us_out,
  rxprbslocked_us_out,
  rxprgdivresetdone_us_out,
  rxratedone_us_out,
  rxresetdone_us_out,
  rxstatus_us_out,
  rxsyncdone_us_out,
  rxvalid_us_out,
  txdlysresetdone_us_out,
  txoutclk_us_out,
  txphaligndone_us_out,
  txphinitdone_us_out,
  txpmaresetdone_us_out,
  txprgdivresetdone_us_out,
  txresetdone_us_out,
  txsyncout_us_out,
  txsyncdone_us_out,

  cpllpd_us_in,
  rxdfeagchold_us_in ,
  rxdfecfokhold_us_in,
  rxdfelfhold_us_in  ,
  rxdfekhhold_us_in  ,
  rxdfetap2hold_us_in,
  rxdfetap3hold_us_in,
  rxdfetap4hold_us_in,
  rxdfetap5hold_us_in,
  rxdfetap6hold_us_in,
  rxdfetap7hold_us_in,
  rxdfetap8hold_us_in,
  rxdfetap9hold_us_in,
  rxdfetap10hold_us_in,
  rxdfetap11hold_us_in,
  rxdfetap12hold_us_in,
  rxdfetap13hold_us_in,
  rxdfetap14hold_us_in,
  rxdfetap15hold_us_in,
  rxdfeuthold_us_in,
  rxdfevphold_us_in,
  rxoshold_us_in   ,
  rxlpmgchold_us_in,
  rxlpmhfhold_us_in,
  rxlpmlfhold_us_in,
  rxlpmoshold_us_in,
  cpllreset_us_in,
  dmonfiforeset_us_in,
  dmonitorclk_us_in,
  drpclk_us_in,
  drpaddr_us_in,
  drpdi_us_in,
  drpen_us_in,
  drpwe_us_in,
  eyescanreset_us_in,
  gthrxn_us_in,
  gthrxp_us_in,
  gtrefclk0_us_in,
  gtrxreset_us_in,
  gttxreset_us_in,
  gtwiz_reset_rx_done_us_in,
  gtwiz_reset_tx_done_us_in,
  gtwiz_userclk_rx_active_us_in ,
  gtwiz_userclk_tx_active_us_in ,
  gtwiz_userclk_tx_reset_us_in,
  loopback_us_in,
  pcieeqrxeqadaptdone_us_in ,
  pcierstidle_us_in,
  pciersttxsyncstart_us_in,
  pcieuserratedone_us_in,
  pcsrsvdin_us_in,
  rx8b10ben_us_in,
  rxbufreset_us_in,
  rxcdrhold_us_in,
  rxcommadeten_us_in,
  rxlpmen_us_in,
  rxmcommaalignen_us_in,
  rxpcommaalignen_us_in,
  rxpd_us_in,
  rxpolarity_us_in,
  rxprbscntreset_us_in,
  rxprbssel_us_in,
  rxprogdivreset_us_in,
  rxrate_us_in,
  rxratemode_us_in,
  rxslide_us_in,
  rxuserrdy_us_in,
  rxusrclk2_us_in,
  rxusrclk_us_in,
  tx8b10ben_us_in,
  txctrl0_us_in,
  txctrl1_us_in,
  txctrl2_us_in,
  txdata_us_in,
  txdeemph_us_in,
  txdetectrx_us_in,
  txdiffctrl_us_in,
  txdlybypass_us_in,
  txdlyen_us_in,
  txdlyhold_us_in,
  txdlyovrden_us_in,
  txdlysreset_us_in,
  txdlyupdown_us_in,
  txelecidle_us_in,
  txinhibit_us_in,
  txmaincursor_us_in,
  txmargin_us_in,
  txoutclksel_us_in,
  txpd_us_in,
  txphalign_us_in,
  txphalignen_us_in,
  txphdlypd_us_in,
  txphdlyreset_us_in,
  txphdlytstclk_us_in ,
  txphinit_us_in,
  txphovrden_us_in,
  txpostcursor_us_in,
  txprbsforceerr_us_in,
  txprbssel_us_in,
  txprecursor_us_in,
  txprogdivreset_us_in,
  txrate_us_in,
  txswing_us_in,
  txsyncallin_us_in,
  txsyncin_us_in,
  txsyncmode_us_in,
  txuserrdy_us_in,
  txusrclk2_us_in,
  txusrclk_us_in,

  qpll0clk_us_in,
  qpll0refclk_us_in,
  qpll1clk_us_in,
  qpll1refclk_us_in,

  gtrefclk01_us_in,
  qpll1pd_us_in,
  qpll1reset_us_in,
  qpllrsvd2_us_in,
  qpllrsvd3_us_in,
  qpll1lock_us_out,
  qpll1outclk_us_out,
  qpll1outrefclk_us_out,

  //--------------------------------------------------------------------------
  //  GT WIZARD IP is not in the US+ PCIe core
  //--------------------------------------------------------------------------
  gtrefclk01_usp_in,
  gtrefclk00_usp_in,
  pcierateqpll0_usp_in,
  pcierateqpll1_usp_in,
  qpll0pd_usp_in,
  qpll0reset_usp_in,
  qpll1pd_usp_in,
  qpll1reset_usp_in,
  qpll0lock_usp_out,
  qpll0outclk_usp_out,
  qpll0outrefclk_usp_out,
  qpll1lock_usp_out,
  qpll1outclk_usp_out,
  qpll1outrefclk_usp_out,
  qpll0freqlock_usp_in,
  qpll1freqlock_usp_in,
  pcierateqpllpd_usp_out,
  pcierateqpllreset_usp_out,

  rcalenb_usp_in,
  txpisopd_usp_in,
  bufgtce_usp_out,
  bufgtcemask_usp_out,
  bufgtdiv_usp_out,
  bufgtreset_usp_out,
  bufgtrstmask_usp_out,
  cpllfreqlock_usp_in,
  cplllock_usp_out,
  cpllpd_usp_in,
  cpllreset_usp_in,
  dmonfiforeset_usp_in,
  dmonitorclk_usp_in,
  dmonitorout_usp_out,
  eyescanreset_usp_in,
  gtpowergood_usp_out,
  gtrefclk0_usp_in,
  gtrxreset_usp_in,
  gttxreset_usp_in,
  gtwiz_reset_rx_done_usp_in,
  gtwiz_reset_tx_done_usp_in,
  gtwiz_userclk_rx_active_usp_in,
  gtwiz_userclk_tx_active_usp_in,

  loopback_usp_in,
  pcieeqrxeqadaptdone_usp_in,
  pcierategen3_usp_out,
  pcierateidle_usp_out,
  pcierstidle_usp_in,
  pciersttxsyncstart_usp_in,
  pciesynctxsyncdone_usp_out,
  pcieusergen3rdy_usp_out,
  pcieuserphystatusrst_usp_out,
  pcieuserratedone_usp_in,
  pcieuserratestart_usp_out,
  phystatus_usp_out,
  resetovrd_usp_in,
  rx8b10ben_usp_in,
  rxbufreset_usp_in,
  rxbufstatus_usp_out,
  rxbyteisaligned_usp_out,
  rxbyterealign_usp_out,
  rxcdrfreqreset_usp_in,
  rxcdrhold_usp_in,
  rxcdrlock_usp_out,
  rxcdrreset_usp_in,
  rxclkcorcnt_usp_out,
  rxcommadet_usp_out,
  rxcommadeten_usp_in,
  rxctrl0_usp_out,
  rxctrl1_usp_out,
  rxctrl2_usp_out,
  rxctrl3_usp_out,
  rxdata_usp_out,
  rxdfeagchold_usp_in,
  rxdfecfokhold_usp_in,
  rxdfekhhold_usp_in,
  rxdfelfhold_usp_in,
  rxdfelpmreset_usp_in,
  rxdfetap10hold_usp_in,
  rxdfetap11hold_usp_in,
  rxdfetap12hold_usp_in,
  rxdfetap13hold_usp_in,
  rxdfetap14hold_usp_in,
  rxdfetap15hold_usp_in,
  rxdfetap2hold_usp_in,
  rxdfetap3hold_usp_in,
  rxdfetap4hold_usp_in,
  rxdfetap5hold_usp_in,
  rxdfetap6hold_usp_in,
  rxdfetap7hold_usp_in,
  rxdfetap8hold_usp_in,
  rxdfetap9hold_usp_in,
  rxdfeuthold_usp_in,
  rxdfevphold_usp_in,
  rxdlysresetdone_usp_out,
  rxelecidle_usp_out,
  rxlpmen_usp_in,
  rxlpmgchold_usp_in,
  rxlpmhfhold_usp_in,
  rxlpmlfhold_usp_in,
  rxlpmoshold_usp_in,
  rxmcommaalignen_usp_in,
  rxoshold_usp_in,
  rxoutclk_usp_out,
  rxoutclkfabric_usp_out,
  rxoutclkpcs_usp_out,
  rxpcommaalignen_usp_in,
  rxpcsreset_usp_in,
  rxpd_usp_in,
  rxphaligndone_usp_out,
  rxpmareset_usp_in,
  rxpmaresetdone_usp_out,
  rxpolarity_usp_in,
  rxprbscntreset_usp_in,
  rxprbserr_usp_out,
  rxprbslocked_usp_out,
  rxprbssel_usp_in,
  rxprogdivreset_usp_in,
  rxrate_usp_in,
  rxratedone_usp_out,
  rxrecclkout_usp_out,
  rxresetdone_usp_out,
  rxslide_usp_in,
  rxstatus_usp_out,
  rxsyncdone_usp_out,
  rxtermination_usp_in,
  rxuserrdy_usp_in,
  rxusrclk2_usp_in,
  rxusrclk_usp_in,
  rxvalid_usp_out,
  tx8b10ben_usp_in,
  txctrl0_usp_in,
  txctrl1_usp_in,
  txctrl2_usp_in,
  txdata_usp_in,
  txdeemph_usp_in,
  txdetectrx_usp_in,
  txdiffctrl_usp_in,
  txdlybypass_usp_in,
  txdlyen_usp_in,
  txdlyhold_usp_in,
  txdlyovrden_usp_in,
  txdlysreset_usp_in,
  txdlysresetdone_usp_out,
  txdlyupdown_usp_in,
  txelecidle_usp_in,
  txmaincursor_usp_in,
  txmargin_usp_in,
  txoutclk_usp_out,
  txoutclkfabric_usp_out,
  txoutclkpcs_usp_out,
  txoutclksel_usp_in,
  txpcsreset_usp_in,
  txpd_usp_in,
  txphalign_usp_in,
  txphaligndone_usp_out,
  txphalignen_usp_in,
  txphdlypd_usp_in,
  txphdlyreset_usp_in,
  txphdlytstclk_usp_in,
  txphinit_usp_in,
  txphinitdone_usp_out,
  txphovrden_usp_in,
  rxratemode_usp_in,
  txpmareset_usp_in,
  txpmaresetdone_usp_out,
  txpostcursor_usp_in,
  txprbsforceerr_usp_in,
  txprbssel_usp_in,
  txprecursor_usp_in,
  txprgdivresetdone_usp_out,
  txprogdivreset_usp_in,
  txrate_usp_in,
  txresetdone_usp_out,
  txswing_usp_in,
  txsyncallin_usp_in,
  txsyncdone_usp_out,
  txsyncin_usp_in,
  txsyncmode_usp_in,
  txsyncout_usp_out,
  txuserrdy_usp_in,
  txusrclk2_usp_in,
  txusrclk_usp_in,
  drpclk_usp_in,
  drpaddr_usp_in,
  drpen_usp_in,
  drprst_usp_in,
  drpwe_usp_in,
  drpdi_usp_in,
  drprdy_usp_out,
  drpdo_usp_out,

  ext_phy_clk_pclk2_gt,
  ext_phy_clk_int_clock,
  ext_phy_clk_pclk,
  ext_phy_clk_phy_pclk2,
  ext_phy_clk_phy_coreclk,
  ext_phy_clk_phy_userclk,
  ext_phy_clk_phy_mcapclk,

  ext_phy_clk_bufg_gt_ce,
  ext_phy_clk_bufg_gt_reset,
  ext_phy_clk_rst_idle,
  ext_phy_clk_txoutclk,
  ext_phy_clk_bufgtcemask,
  ext_phy_clk_gt_bufgtrstmask,
  ext_phy_clk_bufgtdiv,

  //---------- Internal GT COMMON Ports US+ ----------------------
  int_usp_qpll0lock_out,
  int_usp_qpll0outrefclk_out,
  int_usp_qpll0outclk_out,
  int_usp_qpll1lock_out,
  int_usp_qpll1outrefclk_out,
  int_usp_qpll1outclk_out,

  //---------- External GT COMMON Ports US+ ----------------------
  ext_usp_qpllxrefclk,
  ext_usp_qpllxrate,
  ext_usp_qpllxrcalenb,

  ext_usp_qpll0pd,
  ext_usp_qpll0reset,
  ext_usp_qpll0lock_out,
  ext_usp_qpll0outclk_out,
  ext_usp_qpll0outrefclk_out,
  ext_usp_qpll1pd,
  ext_usp_qpll1reset,
  ext_usp_qpll1lock_out,
  ext_usp_qpll1outclk_out,
  ext_usp_qpll1outrefclk_out,

  //--------------------------------------------------------------------------
  cfg_negotiated_width_o,
  cfg_current_speed_o,
  cfg_ltssm_state_o,
  pipe_tx0_rcvr_det,
  pipe_clk,
  sys_clk_bufg,
  pipe_tx0_powerdown,
  cfg_function_status,
  cfg_max_read_req,
  cfg_max_payload,
  cfg_flr_done,
  cfg_flr_in_process,
  cfg_vf_flr_in_process,
  cfg_vf_flr_func_num,
  cfg_vf_flr_done,
  cfg_interrupt_msi_enable,
  cfg_interrupt_msix_enable,
  cfg_interrupt_msix_mask,
  cfg_interrupt_msix_data,
  cfg_interrupt_msix_address,
  cfg_interrupt_msix_int,
  cfg_interrupt_msi_sent,
  cfg_interrupt_msi_fail,
  cfg_interrupt_msix_sent,
  cfg_interrupt_msix_fail,

  phy_rdy_out_sd,
  cfg_err_cor_in_sd,
  cfg_link_training_enable_sd,
  cfg_ltssm_state_sd,
  user_lnk_up_sd,
  s_axis_rq_tdata_sd,
  s_axis_rq_tlast_sd,
  s_axis_rq_tuser_sd,
  s_axis_rq_tkeep_sd,
  s_axis_rq_tvalid_sd,
  s_axis_rq_tready_sd,

  m_axis_rc_tdata_sd,
  m_axis_rc_tuser_sd,
  m_axis_rc_tlast_sd,
  m_axis_rc_tkeep_sd,
  m_axis_rc_tvalid_sd,
  m_axis_rc_tready_sd,

  m_axis_cq_tdata_sd,
  m_axis_cq_tuser_sd,
  m_axis_cq_tlast_sd,
  m_axis_cq_tkeep_sd,
  m_axis_cq_tvalid_sd,
  m_axis_cq_tready_sd,

  s_axis_cc_tdata_sd,
  s_axis_cc_tuser_sd,
  s_axis_cc_tlast_sd,
  s_axis_cc_tkeep_sd,
  s_axis_cc_tvalid_sd,
  s_axis_cc_tready_sd,

  rbar_bar_size_sd,
  rbar_function_number_sd,
  rbar_write_enable_bar0_sd,
  rbar_write_enable_bar1_sd,
  rbar_write_enable_bar2_sd,
  rbar_write_enable_bar3_sd,
  rbar_write_enable_bar4_sd,
  rbar_write_enable_bar5_sd,
  user_clk_sd,
  user_reset_sd,
  pcie_cq_np_req_sd,
  pcie_cq_np_req_count_sd,
  pcie_tfc_nph_av_sd,
  pcie_tfc_npd_av_sd,
  pcie_rq_seq_num_vld0_sd,
  pcie_rq_seq_num0_sd,
  pcie_rq_seq_num_vld1_sd,
  pcie_rq_seq_num1_sd,
  cfg_fc_nph_sd,
  cfg_fc_sel_sd,
  cfg_phy_link_down_sd,
  cfg_phy_link_status_sd,
  cfg_negotiated_width_sd,
  cfg_current_speed_sd,
  cfg_pl_status_change_sd,
  cfg_hot_reset_out_sd,
  cfg_ds_port_number_sd,
  cfg_ds_bus_number_sd,
  cfg_ds_device_number_sd,
  cfg_ds_function_number_sd,
  cfg_dsn_sd,
  cfg_function_status_sd,
  cfg_max_read_req_sd,
  cfg_max_payload_sd,
  cfg_err_uncor_in_sd,
  cfg_flr_done_sd,
  cfg_flr_in_process_sd,
  cfg_vf_flr_in_process_sd,


  cfg_err_cor_out_sd,
  cfg_err_nonfatal_out_sd,
  cfg_err_fatal_out_sd,
  cfg_local_error_out_sd,

  cfg_msg_received_sd,
  cfg_msg_received_data_sd,
  cfg_msg_received_type_sd,
  cfg_msg_transmit_sd,
  cfg_msg_transmit_type_sd,
  cfg_msg_transmit_data_sd,
  cfg_msg_transmit_done_sd,

  cfg_mgmt_addr_sd,
  cfg_mgmt_write_sd,
  cfg_mgmt_write_data_sd,
  cfg_mgmt_byte_enable_sd,
  cfg_mgmt_read_sd,
  cfg_mgmt_type1_cfg_reg_access_sd,
  cfg_mgmt_read_data_sd,
  cfg_mgmt_read_write_done_sd,
  cfg_mgmt_function_number_sd,

  cfg_interrupt_int_sd,
  cfg_interrupt_sent_sd,
  cfg_interrupt_pending_sd,

  cfg_interrupt_msi_enable_sd,
  cfg_interrupt_msi_mask_update_sd,
  cfg_interrupt_msi_data_sd,
  cfg_interrupt_msi_int_sd,
  cfg_interrupt_msi_pending_status_sd,
  cfg_interrupt_msi_pending_status_data_enable_sd,
  cfg_interrupt_msi_pending_status_function_num_sd,
  cfg_interrupt_msi_attr_sd,
  cfg_interrupt_msi_tph_present_sd,
  cfg_interrupt_msi_tph_type_sd,
  cfg_interrupt_msi_tph_st_tag_sd,
  cfg_interrupt_msi_function_number_sd,

  cfg_interrupt_msi_sent_sd,
  cfg_interrupt_msi_fail_sd,

  cfg_interrupt_msix_enable_sd,
  cfg_interrupt_msix_mask_sd,
  cfg_interrupt_msix_data_sd,
  cfg_interrupt_msix_address_sd,
  cfg_interrupt_msix_int_sd,
  cfg_interrupt_msix_vf_enable_sd,
  cfg_interrupt_msix_vf_mask_sd,

  rd_interrupt,
  wr_interrupt,
  ats_pri_en,
  cfg_fc_vc_sel,
  core_clk,

  // CXS interface
  cxs0_active_req_tx,
  cxs0_active_ack_tx,
  cxs0_deact_hint_tx,
  cxs0_valid_tx,
  cxs0_crdgnt_tx,
  cxs0_crdrtn_tx,
  cxs0_cntl_tx,
  cxs0_data_tx,
  cxs0_valid_chk_tx,
  cxs0_crdgnt_chk_tx,
  cxs0_crdrtn_chk_tx,
  cxs0_cntl_chk_tx,
  cxs0_data_chk_tx,
  cxs0_active_req_rx,
  cxs0_active_ack_rx,
  cxs0_deact_hint_rx,
  cxs0_valid_rx,
  cxs0_crdgnt_rx,
  cxs0_crdrtn_rx,
  cxs0_cntl_rx,
  cxs0_data_rx,
  cxs0_valid_chk_rx,
  cxs0_crdgnt_chk_rx,
  cxs0_crdrtn_chk_rx,
  cxs0_cntl_chk_rx,
  cxs0_data_chk_rx,

  // CXS interface
  pcie4_cxs0_active_req_tx_sd,
  pcie4_cxs0_active_ack_tx_sd,
  pcie4_cxs0_deact_hint_tx_sd,
  pcie4_cxs0_valid_tx_sd,
  pcie4_cxs0_crdgnt_tx_sd,
  pcie4_cxs0_crdrtn_tx_sd,
  pcie4_cxs0_cntl_tx_sd,
  pcie4_cxs0_data_tx_sd,
  pcie4_cxs0_valid_chk_tx_sd,
  pcie4_cxs0_crdgnt_chk_tx_sd,
  pcie4_cxs0_crdrtn_chk_tx_sd,
  pcie4_cxs0_cntl_chk_tx_sd,
  pcie4_cxs0_data_chk_tx_sd,
  pcie4_cxs0_active_req_rx_sd,
  pcie4_cxs0_active_ack_rx_sd,
  pcie4_cxs0_deact_hint_rx_sd,
  pcie4_cxs0_valid_rx_sd,
  pcie4_cxs0_crdgnt_rx_sd,
  pcie4_cxs0_crdrtn_rx_sd,
  pcie4_cxs0_cntl_rx_sd,
  pcie4_cxs0_data_rx_sd,
  pcie4_cxs0_valid_chk_rx_sd,
  pcie4_cxs0_crdgnt_chk_rx_sd,
  pcie4_cxs0_crdrtn_chk_rx_sd,
  pcie4_cxs0_cntl_chk_rx_sd,
  pcie4_cxs0_data_chk_rx_sd,

  ccix_optimized_tlp_tx_and_rx_enable_in,

  sc0_ats_s_axis_rq_tvalid,
  sc0_ats_s_axis_rq_tready,
  sc0_ats_s_axis_rq_tdata,
  sc0_ats_s_axis_rq_tkeep,
  sc0_ats_s_axis_rq_tlast,
  sc0_ats_s_axis_rq_tuser,

  sc0_ats_m_axis_rc_tvalid,
  sc0_ats_m_axis_rc_tready,
  sc0_ats_m_axis_rc_tdata,
  sc0_ats_m_axis_rc_tkeep,
  sc0_ats_m_axis_rc_tlast,
  sc0_ats_m_axis_rc_tuser,

  sc0_ats_s_axis_cc_tvalid,
  sc0_ats_s_axis_cc_tready,
  sc0_ats_s_axis_cc_tdata,
  sc0_ats_s_axis_cc_tkeep,
  sc0_ats_s_axis_cc_tlast,
  sc0_ats_s_axis_cc_tuser,

  sc0_ats_m_axis_cq_tvalid,
  sc0_ats_m_axis_cq_tready,
  sc0_ats_m_axis_cq_tdata,
  sc0_ats_m_axis_cq_tkeep,
  sc0_ats_m_axis_cq_tlast,
  sc0_ats_m_axis_cq_tuser,

  sc1_ats_s_axis_rq_tvalid,
  sc1_ats_s_axis_rq_tready,
  sc1_ats_s_axis_rq_tdata,
  sc1_ats_s_axis_rq_tkeep,
  sc1_ats_s_axis_rq_tlast,
  sc1_ats_s_axis_rq_tuser,

  sc1_ats_m_axis_rc_tvalid,
  sc1_ats_m_axis_rc_tready,
  sc1_ats_m_axis_rc_tdata,
  sc1_ats_m_axis_rc_tkeep,
  sc1_ats_m_axis_rc_tlast,
  sc1_ats_m_axis_rc_tuser,

  sc1_ats_s_axis_cc_tvalid,
  sc1_ats_s_axis_cc_tready,
  sc1_ats_s_axis_cc_tdata,
  sc1_ats_s_axis_cc_tkeep,
  sc1_ats_s_axis_cc_tlast,
  sc1_ats_s_axis_cc_tuser,

  sc1_ats_m_axis_cq_tvalid,
  sc1_ats_m_axis_cq_tready,
  sc1_ats_m_axis_cq_tdata,
  sc1_ats_m_axis_cq_tkeep,
  sc1_ats_m_axis_cq_tlast,
  sc1_ats_m_axis_cq_tuser,

  // AXI SLAVE Interface to MicroProcessor
  s_aclk,
  s_aresetn,
  s_axi_araddr,
  s_axi_arburst,
  s_axi_arcache,
  s_axi_arid,
  s_axi_arlen,
  s_axi_arlock,
  s_axi_arprot,
  s_axi_arqos,
  s_axi_arready,
  s_axi_arsize,
  s_axi_aruser,
  s_axi_arvalid,
  s_axi_awaddr,
  s_axi_awburst,
  s_axi_awcache,
  s_axi_awid,
  s_axi_awlen,
  s_axi_awlock,
  s_axi_awprot,
  s_axi_awqos,
  s_axi_awready,
  s_axi_awsize,
  s_axi_awuser,
  s_axi_awvalid,
  s_axi_bid,
  s_axi_bready,
  s_axi_bresp,
  s_axi_bvalid,
  s_axi_rdata,
  s_axi_rid,
  s_axi_rlast,
  s_axi_rready,
  s_axi_rresp,
  s_axi_rvalid,
  s_axi_wdata,
  s_axi_wlast,
  s_axi_wready,
  s_axi_wstrb,
  s_axi_wvalid,

  // ATS Signals - Start
  atspri_m_axis_cq_tdata,
  atspri_m_axis_cq_tuser,
  atspri_m_axis_cq_tlast,
  atspri_m_axis_cq_tkeep,
  atspri_m_axis_cq_tvalid,
  atspri_m_axis_cq_tready,
  atspri_s_axis_rq_tdata,
  atspri_s_axis_rq_tuser,
  atspri_s_axis_rq_tlast,
  atspri_s_axis_rq_tkeep,
  atspri_s_axis_rq_tvalid,
  atspri_s_axis_rq_tready,
  cfg_status_ats_stu,
  cfg_status_ats_en,
  cfg_status_pr_en,
  cfg_status_pr_rst,
  cfg_status_pr_uprgi,
  cfg_status_set_uprgi,
  cfg_status_pr_rf,
  cfg_status_set_rf,
  cfg_status_set_s,
  cfg_status_clr_s,
  cfg_status_ost_pr_alloc
  // ATS Signals - End
);
  //--------------------------------------------------------------------------
  //  GT WIZARD IP is not in the US+ PCIe core
  //--------------------------------------------------------------------------
  output  [(PL_LINK_CAP_MAX_LINK_WIDTH-1)>>2:0]      gtrefclk01_usp_in;
  output  [(PL_LINK_CAP_MAX_LINK_WIDTH-1)>>2:0]      gtrefclk00_usp_in;
  output  [((((PL_LINK_CAP_MAX_LINK_WIDTH-1)>>2)+1)*3)-1:0] pcierateqpll0_usp_in;
  output  [((((PL_LINK_CAP_MAX_LINK_WIDTH-1)>>2)+1)*3)-1:0] pcierateqpll1_usp_in;
  output  [(PL_LINK_CAP_MAX_LINK_WIDTH-1)>>2 : 0]   qpll0pd_usp_in;
  output  [(PL_LINK_CAP_MAX_LINK_WIDTH-1)>>2 : 0]   qpll0reset_usp_in;
  output  [(PL_LINK_CAP_MAX_LINK_WIDTH-1)>>2 : 0]   qpll1pd_usp_in;
  output  [(PL_LINK_CAP_MAX_LINK_WIDTH-1)>>2 : 0]   qpll1reset_usp_in;
  input   [(PL_LINK_CAP_MAX_LINK_WIDTH-1)>>2:0]     qpll0lock_usp_out;
  input   [(PL_LINK_CAP_MAX_LINK_WIDTH-1)>>2:0]     qpll0outclk_usp_out;
  input   [(PL_LINK_CAP_MAX_LINK_WIDTH-1)>>2:0]     qpll0outrefclk_usp_out;
  input   [(PL_LINK_CAP_MAX_LINK_WIDTH-1)>>2:0]     qpll1lock_usp_out;
  input   [(PL_LINK_CAP_MAX_LINK_WIDTH-1)>>2:0]     qpll1outclk_usp_out;
  input   [(PL_LINK_CAP_MAX_LINK_WIDTH-1)>>2:0]     qpll1outrefclk_usp_out;
  output  [PL_LINK_CAP_MAX_LINK_WIDTH-1:0]          qpll0freqlock_usp_in;
  output  [PL_LINK_CAP_MAX_LINK_WIDTH-1:0]          qpll1freqlock_usp_in;
  input   [(PL_LINK_CAP_MAX_LINK_WIDTH*2)-1:0]      pcierateqpllpd_usp_out;
  input   [(PL_LINK_CAP_MAX_LINK_WIDTH*2)-1:0]      pcierateqpllreset_usp_out;

  output  [(PL_LINK_CAP_MAX_LINK_WIDTH-1)>>2 : 0]   rcalenb_usp_in;
  output  [PL_LINK_CAP_MAX_LINK_WIDTH-1:0]      txpisopd_usp_in;
  input   [PL_LINK_CAP_MAX_LINK_WIDTH-1:0]      bufgtce_usp_out;
  input   [(PL_LINK_CAP_MAX_LINK_WIDTH* 3)-1:0] bufgtcemask_usp_out;
  input   [(PL_LINK_CAP_MAX_LINK_WIDTH* 9)-1:0] bufgtdiv_usp_out;
  input   [PL_LINK_CAP_MAX_LINK_WIDTH-1:0]      bufgtreset_usp_out;
  input   [(PL_LINK_CAP_MAX_LINK_WIDTH* 3)-1:0] bufgtrstmask_usp_out;
  output  [PL_LINK_CAP_MAX_LINK_WIDTH-1:0]      cpllfreqlock_usp_in;
  input   [PL_LINK_CAP_MAX_LINK_WIDTH-1:0]      cplllock_usp_out;
  output  [PL_LINK_CAP_MAX_LINK_WIDTH-1:0]      cpllpd_usp_in;
  output  [PL_LINK_CAP_MAX_LINK_WIDTH-1:0]      cpllreset_usp_in;
  output  [PL_LINK_CAP_MAX_LINK_WIDTH-1:0]      dmonfiforeset_usp_in;
  output  [PL_LINK_CAP_MAX_LINK_WIDTH-1:0]      dmonitorclk_usp_in;
  input   [(PL_LINK_CAP_MAX_LINK_WIDTH*16)-1:0] dmonitorout_usp_out;
  output  [PL_LINK_CAP_MAX_LINK_WIDTH-1:0]      eyescanreset_usp_in;
  input   [PL_LINK_CAP_MAX_LINK_WIDTH-1:0]      gtpowergood_usp_out;
  output  [PL_LINK_CAP_MAX_LINK_WIDTH-1:0]      gtrefclk0_usp_in;
  output  [PL_LINK_CAP_MAX_LINK_WIDTH-1:0]      gtrxreset_usp_in;
  output  [PL_LINK_CAP_MAX_LINK_WIDTH-1:0]      gttxreset_usp_in;
  output  gtwiz_reset_rx_done_usp_in;
  output  gtwiz_reset_tx_done_usp_in;
  output  gtwiz_userclk_rx_active_usp_in;
  output  gtwiz_userclk_tx_active_usp_in;

  output  [(PL_LINK_CAP_MAX_LINK_WIDTH* 3)-1:0] loopback_usp_in;
  output  [PL_LINK_CAP_MAX_LINK_WIDTH-1:0] pcieeqrxeqadaptdone_usp_in;
  input   [PL_LINK_CAP_MAX_LINK_WIDTH-1:0] pcierategen3_usp_out;
  input   [PL_LINK_CAP_MAX_LINK_WIDTH-1:0] pcierateidle_usp_out;
  output  [PL_LINK_CAP_MAX_LINK_WIDTH-1:0] pcierstidle_usp_in;
  output  [PL_LINK_CAP_MAX_LINK_WIDTH-1:0] pciersttxsyncstart_usp_in;
  input   [PL_LINK_CAP_MAX_LINK_WIDTH-1:0] pciesynctxsyncdone_usp_out;
  input   [PL_LINK_CAP_MAX_LINK_WIDTH-1:0] pcieusergen3rdy_usp_out;
  input   [PL_LINK_CAP_MAX_LINK_WIDTH-1:0] pcieuserphystatusrst_usp_out;
  output  [PL_LINK_CAP_MAX_LINK_WIDTH-1:0] pcieuserratedone_usp_in;
  input   [PL_LINK_CAP_MAX_LINK_WIDTH-1:0] pcieuserratestart_usp_out;
  input   [PL_LINK_CAP_MAX_LINK_WIDTH-1:0] phystatus_usp_out;
  output  [PL_LINK_CAP_MAX_LINK_WIDTH-1:0] resetovrd_usp_in;

  output  [PL_LINK_CAP_MAX_LINK_WIDTH-1:0]         rx8b10ben_usp_in;
  output  [PL_LINK_CAP_MAX_LINK_WIDTH-1:0]         rxbufreset_usp_in;
  input   [(PL_LINK_CAP_MAX_LINK_WIDTH*3)-1:0]     rxbufstatus_usp_out;
  input   [PL_LINK_CAP_MAX_LINK_WIDTH-1 : 0]       rxbyteisaligned_usp_out;
  input   [PL_LINK_CAP_MAX_LINK_WIDTH-1 : 0]       rxbyterealign_usp_out;
  output  [PL_LINK_CAP_MAX_LINK_WIDTH-1:0]         rxcdrfreqreset_usp_in;
  output  [PL_LINK_CAP_MAX_LINK_WIDTH-1:0]         rxcdrhold_usp_in;
  input   [PL_LINK_CAP_MAX_LINK_WIDTH-1:0]         rxcdrlock_usp_out;
  output  [PL_LINK_CAP_MAX_LINK_WIDTH-1:0]         rxcdrreset_usp_in;
  input   [(PL_LINK_CAP_MAX_LINK_WIDTH * 2)-1 : 0] rxclkcorcnt_usp_out;
  input   [PL_LINK_CAP_MAX_LINK_WIDTH-1:0]         rxcommadet_usp_out;
  output  [PL_LINK_CAP_MAX_LINK_WIDTH-1:0]         rxcommadeten_usp_in;
  input   [(PL_LINK_CAP_MAX_LINK_WIDTH*16)-1:0]    rxctrl0_usp_out;
  input   [(PL_LINK_CAP_MAX_LINK_WIDTH*16)-1:0]    rxctrl1_usp_out;
  input   [(PL_LINK_CAP_MAX_LINK_WIDTH*8)-1:0]     rxctrl2_usp_out;
  input   [(PL_LINK_CAP_MAX_LINK_WIDTH*8)-1:0]     rxctrl3_usp_out;
  input   [(PL_LINK_CAP_MAX_LINK_WIDTH*128)-1:0]   rxdata_usp_out;
  output  [PL_LINK_CAP_MAX_LINK_WIDTH-1 : 0]       rxdfeagchold_usp_in;
  output  [PL_LINK_CAP_MAX_LINK_WIDTH-1 : 0]       rxdfecfokhold_usp_in;
  output  [PL_LINK_CAP_MAX_LINK_WIDTH-1 : 0]       rxdfekhhold_usp_in;
  output  [PL_LINK_CAP_MAX_LINK_WIDTH-1 : 0]       rxdfelfhold_usp_in;
  output  [PL_LINK_CAP_MAX_LINK_WIDTH-1:0]         rxdfelpmreset_usp_in;
  output  [PL_LINK_CAP_MAX_LINK_WIDTH-1 : 0]       rxdfetap10hold_usp_in;
  output  [PL_LINK_CAP_MAX_LINK_WIDTH-1 : 0]       rxdfetap11hold_usp_in;
  output  [PL_LINK_CAP_MAX_LINK_WIDTH-1 : 0]       rxdfetap12hold_usp_in;
  output  [PL_LINK_CAP_MAX_LINK_WIDTH-1 : 0]       rxdfetap13hold_usp_in;
  output  [PL_LINK_CAP_MAX_LINK_WIDTH-1 : 0]       rxdfetap14hold_usp_in;
  output  [PL_LINK_CAP_MAX_LINK_WIDTH-1 : 0]       rxdfetap15hold_usp_in;
  output  [PL_LINK_CAP_MAX_LINK_WIDTH-1 : 0]       rxdfetap2hold_usp_in;
  output  [PL_LINK_CAP_MAX_LINK_WIDTH-1 : 0]       rxdfetap3hold_usp_in;
  output  [PL_LINK_CAP_MAX_LINK_WIDTH-1 : 0]       rxdfetap4hold_usp_in;
  output  [PL_LINK_CAP_MAX_LINK_WIDTH-1 : 0]       rxdfetap5hold_usp_in;
  output  [PL_LINK_CAP_MAX_LINK_WIDTH-1 : 0]       rxdfetap6hold_usp_in;
  output  [PL_LINK_CAP_MAX_LINK_WIDTH-1 : 0]       rxdfetap7hold_usp_in;
  output  [PL_LINK_CAP_MAX_LINK_WIDTH-1 : 0]       rxdfetap8hold_usp_in;
  output  [PL_LINK_CAP_MAX_LINK_WIDTH-1 : 0]       rxdfetap9hold_usp_in;
  output  [PL_LINK_CAP_MAX_LINK_WIDTH-1 : 0]       rxdfeuthold_usp_in;
  output  [PL_LINK_CAP_MAX_LINK_WIDTH-1 : 0]       rxdfevphold_usp_in;
  input   [PL_LINK_CAP_MAX_LINK_WIDTH-1:0]         rxdlysresetdone_usp_out;
  input   [PL_LINK_CAP_MAX_LINK_WIDTH-1:0]         rxelecidle_usp_out;
  output  [PL_LINK_CAP_MAX_LINK_WIDTH-1:0]         rxlpmen_usp_in;
  output  [PL_LINK_CAP_MAX_LINK_WIDTH-1 : 0]       rxlpmgchold_usp_in;
  output  [PL_LINK_CAP_MAX_LINK_WIDTH-1 : 0]       rxlpmhfhold_usp_in;
  output  [PL_LINK_CAP_MAX_LINK_WIDTH-1 : 0]       rxlpmlfhold_usp_in;
  output  [PL_LINK_CAP_MAX_LINK_WIDTH-1 : 0]       rxlpmoshold_usp_in;
  output  [PL_LINK_CAP_MAX_LINK_WIDTH-1:0]         rxmcommaalignen_usp_in;
  output  [PL_LINK_CAP_MAX_LINK_WIDTH-1 : 0]       rxoshold_usp_in;
  input   [PL_LINK_CAP_MAX_LINK_WIDTH-1 : 0]       rxoutclk_usp_out;
  input   [PL_LINK_CAP_MAX_LINK_WIDTH-1:0]         rxoutclkfabric_usp_out;
  input   [PL_LINK_CAP_MAX_LINK_WIDTH-1:0]         rxoutclkpcs_usp_out;
  output  [PL_LINK_CAP_MAX_LINK_WIDTH-1:0]         rxpcommaalignen_usp_in;
  output  [PL_LINK_CAP_MAX_LINK_WIDTH-1:0]         rxpcsreset_usp_in;
  output  [(PL_LINK_CAP_MAX_LINK_WIDTH* 2)-1:0]    rxpd_usp_in;
  input   [PL_LINK_CAP_MAX_LINK_WIDTH-1:0]         rxphaligndone_usp_out;
  output  [PL_LINK_CAP_MAX_LINK_WIDTH-1:0]         rxpmareset_usp_in;
  input   [PL_LINK_CAP_MAX_LINK_WIDTH-1:0]         rxpmaresetdone_usp_out;
  output  [PL_LINK_CAP_MAX_LINK_WIDTH-1:0]         rxpolarity_usp_in;
  output  [PL_LINK_CAP_MAX_LINK_WIDTH-1:0]         rxprbscntreset_usp_in;
  input   [PL_LINK_CAP_MAX_LINK_WIDTH-1:0]         rxprbserr_usp_out;
  input   [PL_LINK_CAP_MAX_LINK_WIDTH-1:0]         rxprbslocked_usp_out;
  output  [(PL_LINK_CAP_MAX_LINK_WIDTH* 4)-1:0]    rxprbssel_usp_in;
  output  [PL_LINK_CAP_MAX_LINK_WIDTH-1:0]         rxprogdivreset_usp_in;
  output  [(PL_LINK_CAP_MAX_LINK_WIDTH* 3)-1:0]    rxrate_usp_in;
  input   [PL_LINK_CAP_MAX_LINK_WIDTH-1:0]         rxratedone_usp_out;
  input   [PL_LINK_CAP_MAX_LINK_WIDTH-1:0]         rxrecclkout_usp_out;
  input   [PL_LINK_CAP_MAX_LINK_WIDTH-1:0]         rxresetdone_usp_out;
  output  [PL_LINK_CAP_MAX_LINK_WIDTH-1:0]         rxslide_usp_in;
  input   [(PL_LINK_CAP_MAX_LINK_WIDTH* 3)-1:0]    rxstatus_usp_out;
  input   [PL_LINK_CAP_MAX_LINK_WIDTH-1:0]         rxsyncdone_usp_out;
  output  [PL_LINK_CAP_MAX_LINK_WIDTH-1:0]         rxtermination_usp_in;
  output  [PL_LINK_CAP_MAX_LINK_WIDTH-1:0]         rxuserrdy_usp_in;
  output  [PL_LINK_CAP_MAX_LINK_WIDTH-1:0]         rxusrclk2_usp_in;
  output  [PL_LINK_CAP_MAX_LINK_WIDTH-1:0]         rxusrclk_usp_in;
  input   [PL_LINK_CAP_MAX_LINK_WIDTH-1:0]         rxvalid_usp_out;

  output  [PL_LINK_CAP_MAX_LINK_WIDTH-1:0]       tx8b10ben_usp_in;
  output  [(PL_LINK_CAP_MAX_LINK_WIDTH*16)-1:0]  txctrl0_usp_in;
  output  [(PL_LINK_CAP_MAX_LINK_WIDTH*16)-1:0]  txctrl1_usp_in;
  output  [(PL_LINK_CAP_MAX_LINK_WIDTH* 8)-1:0]  txctrl2_usp_in;
  output  [(PL_LINK_CAP_MAX_LINK_WIDTH*128)-1:0] txdata_usp_in;
  output  [(PL_LINK_CAP_MAX_LINK_WIDTH* 2)-1:0]  txdeemph_usp_in;
  output  [PL_LINK_CAP_MAX_LINK_WIDTH-1:0]       txdetectrx_usp_in;
  output  [(PL_LINK_CAP_MAX_LINK_WIDTH*5)-1:0]   txdiffctrl_usp_in;
  output  [PL_LINK_CAP_MAX_LINK_WIDTH-1:0]       txdlybypass_usp_in;
  output  [PL_LINK_CAP_MAX_LINK_WIDTH-1:0]       txdlyen_usp_in;
  output  [PL_LINK_CAP_MAX_LINK_WIDTH-1:0]       txdlyhold_usp_in;
  output  [PL_LINK_CAP_MAX_LINK_WIDTH-1:0]       txdlyovrden_usp_in;
  output  [PL_LINK_CAP_MAX_LINK_WIDTH-1:0]       txdlysreset_usp_in;
  input   [PL_LINK_CAP_MAX_LINK_WIDTH-1:0]       txdlysresetdone_usp_out;
  output  [PL_LINK_CAP_MAX_LINK_WIDTH-1:0]       txdlyupdown_usp_in;
  output  [PL_LINK_CAP_MAX_LINK_WIDTH-1:0]       txelecidle_usp_in;
  output  [(PL_LINK_CAP_MAX_LINK_WIDTH* 7)-1:0]  txmaincursor_usp_in;
  output  [(PL_LINK_CAP_MAX_LINK_WIDTH* 3)-1:0]  txmargin_usp_in;
  input   [PL_LINK_CAP_MAX_LINK_WIDTH-1:0]       txoutclk_usp_out;
  input   [PL_LINK_CAP_MAX_LINK_WIDTH-1:0]       txoutclkfabric_usp_out;
  input   [PL_LINK_CAP_MAX_LINK_WIDTH-1:0]       txoutclkpcs_usp_out;
  output  [(PL_LINK_CAP_MAX_LINK_WIDTH* 3)-1:0]  txoutclksel_usp_in;
  output  [PL_LINK_CAP_MAX_LINK_WIDTH-1:0]       txpcsreset_usp_in;
  output  [(PL_LINK_CAP_MAX_LINK_WIDTH* 2)-1:0]  txpd_usp_in;
  output  [PL_LINK_CAP_MAX_LINK_WIDTH-1:0]       txphalign_usp_in;
  input   [PL_LINK_CAP_MAX_LINK_WIDTH-1:0]       txphaligndone_usp_out;
  output  [PL_LINK_CAP_MAX_LINK_WIDTH-1:0]       txphalignen_usp_in;
  output  [PL_LINK_CAP_MAX_LINK_WIDTH-1:0]       txphdlypd_usp_in;
  output  [PL_LINK_CAP_MAX_LINK_WIDTH-1:0]       txphdlyreset_usp_in;
  output  [PL_LINK_CAP_MAX_LINK_WIDTH-1:0]       txphdlytstclk_usp_in;
  output  [PL_LINK_CAP_MAX_LINK_WIDTH-1:0]       txphinit_usp_in;
  input   [PL_LINK_CAP_MAX_LINK_WIDTH-1:0]       txphinitdone_usp_out;
  output  [PL_LINK_CAP_MAX_LINK_WIDTH-1:0]       txphovrden_usp_in;
  output  [PL_LINK_CAP_MAX_LINK_WIDTH-1:0]       rxratemode_usp_in;
  output  [PL_LINK_CAP_MAX_LINK_WIDTH-1:0]       txpmareset_usp_in;
  input   [PL_LINK_CAP_MAX_LINK_WIDTH-1 : 0]     txpmaresetdone_usp_out;
  output  [(PL_LINK_CAP_MAX_LINK_WIDTH* 5)-1:0]  txpostcursor_usp_in;
  output  [PL_LINK_CAP_MAX_LINK_WIDTH-1:0]       txprbsforceerr_usp_in;
  output  [(PL_LINK_CAP_MAX_LINK_WIDTH* 4)-1:0]  txprbssel_usp_in;
  output  [(PL_LINK_CAP_MAX_LINK_WIDTH* 5)-1:0]  txprecursor_usp_in;
  input   [PL_LINK_CAP_MAX_LINK_WIDTH-1:0]       txprgdivresetdone_usp_out;
  output  [PL_LINK_CAP_MAX_LINK_WIDTH-1:0]       txprogdivreset_usp_in;
  output  [(PL_LINK_CAP_MAX_LINK_WIDTH* 3)-1:0]  txrate_usp_in;
  input   [PL_LINK_CAP_MAX_LINK_WIDTH-1:0]       txresetdone_usp_out;
  output  [PL_LINK_CAP_MAX_LINK_WIDTH-1:0]       txswing_usp_in;
  output  [(PL_LINK_CAP_MAX_LINK_WIDTH-1) : 0]   txsyncallin_usp_in;
  input   [PL_LINK_CAP_MAX_LINK_WIDTH-1 : 0]     txsyncdone_usp_out;
  output  [(PL_LINK_CAP_MAX_LINK_WIDTH-1) : 0]   txsyncin_usp_in;
  output  [PL_LINK_CAP_MAX_LINK_WIDTH-1:0]       txsyncmode_usp_in;
  input   [PL_LINK_CAP_MAX_LINK_WIDTH-1:0]       txsyncout_usp_out;
  output  [PL_LINK_CAP_MAX_LINK_WIDTH-1:0]       txuserrdy_usp_in;
  output  [PL_LINK_CAP_MAX_LINK_WIDTH-1:0]       txusrclk2_usp_in;
  output  [PL_LINK_CAP_MAX_LINK_WIDTH-1:0]       txusrclk_usp_in;

  output                                            drpclk_usp_in;
  output  [((PL_LINK_CAP_MAX_LINK_WIDTH * 10)-1):0] drpaddr_usp_in;
  output  [((PL_LINK_CAP_MAX_LINK_WIDTH *  1)-1):0] drpen_usp_in;
  output  [((PL_LINK_CAP_MAX_LINK_WIDTH *  1)-1):0] drprst_usp_in;
  output  [((PL_LINK_CAP_MAX_LINK_WIDTH *  1)-1):0] drpwe_usp_in;
  output  [((PL_LINK_CAP_MAX_LINK_WIDTH * 16)-1):0] drpdi_usp_in;
  input   [((PL_LINK_CAP_MAX_LINK_WIDTH *  1)-1):0] drprdy_usp_out;
  input   [((PL_LINK_CAP_MAX_LINK_WIDTH * 16)-1):0] drpdo_usp_out;

  input        ext_phy_clk_pclk2_gt;
  input        ext_phy_clk_int_clock;
  input        ext_phy_clk_pclk;
  input        ext_phy_clk_phy_pclk2;
  input        ext_phy_clk_phy_coreclk;
  input        ext_phy_clk_phy_userclk;
  input        ext_phy_clk_phy_mcapclk;

  output       ext_phy_clk_bufg_gt_ce;
  output       ext_phy_clk_bufg_gt_reset;
  output       ext_phy_clk_rst_idle;
  output       ext_phy_clk_txoutclk;
  output       ext_phy_clk_bufgtcemask;
  output       ext_phy_clk_gt_bufgtrstmask;
  output [8:0] ext_phy_clk_bufgtdiv;

//----- Internal GT COMMON Ports US+ ----------------------
  output [((PL_LINK_CAP_MAX_LINK_WIDTH-1)>>2):0] int_usp_qpll0lock_out;
  output [((PL_LINK_CAP_MAX_LINK_WIDTH-1)>>2):0] int_usp_qpll0outrefclk_out;
  output [((PL_LINK_CAP_MAX_LINK_WIDTH-1)>>2):0] int_usp_qpll0outclk_out;
  output [((PL_LINK_CAP_MAX_LINK_WIDTH-1)>>2):0] int_usp_qpll1lock_out;
  output [((PL_LINK_CAP_MAX_LINK_WIDTH-1)>>2):0] int_usp_qpll1outrefclk_out;
  output [((PL_LINK_CAP_MAX_LINK_WIDTH-1)>>2):0] int_usp_qpll1outclk_out;

//----- External GT COMMON Ports US+ ----------------------
  output [((PL_LINK_CAP_MAX_LINK_WIDTH-1)>>2):0] ext_usp_qpllxrefclk;
  output [((((PL_LINK_CAP_MAX_LINK_WIDTH-1)>>2)+1)*3)-1:0] ext_usp_qpllxrate;
  output                                                   ext_usp_qpllxrcalenb;

  output [((PL_LINK_CAP_MAX_LINK_WIDTH-1)>>2):0] ext_usp_qpll0pd;
  output [((PL_LINK_CAP_MAX_LINK_WIDTH-1)>>2):0] ext_usp_qpll0reset;
  input  [((PL_LINK_CAP_MAX_LINK_WIDTH-1)>>2):0] ext_usp_qpll0lock_out;
  input  [((PL_LINK_CAP_MAX_LINK_WIDTH-1)>>2):0] ext_usp_qpll0outclk_out;
  input  [((PL_LINK_CAP_MAX_LINK_WIDTH-1)>>2):0] ext_usp_qpll0outrefclk_out;
  output [((PL_LINK_CAP_MAX_LINK_WIDTH-1)>>2):0] ext_usp_qpll1pd;
  output [((PL_LINK_CAP_MAX_LINK_WIDTH-1)>>2):0] ext_usp_qpll1reset;
  input  [((PL_LINK_CAP_MAX_LINK_WIDTH-1)>>2):0] ext_usp_qpll1lock_out;
  input  [((PL_LINK_CAP_MAX_LINK_WIDTH-1)>>2):0] ext_usp_qpll1outclk_out;
  input  [((PL_LINK_CAP_MAX_LINK_WIDTH-1)>>2):0] ext_usp_qpll1outrefclk_out;

 //--------------------------------------------------------------------------
 //  GT WIZARD IP is not in the US PCIe core
 //--------------------------------------------------------------------------

  input [(PL_LINK_CAP_MAX_LINK_WIDTH* 3)-1:0]    bufgtce_us_out ;
  input [(PL_LINK_CAP_MAX_LINK_WIDTH* 3)-1:0]    bufgtcemask_us_out ;
  input [(PL_LINK_CAP_MAX_LINK_WIDTH* 9)-1:0]    bufgtdiv_us_out ;
  input [(PL_LINK_CAP_MAX_LINK_WIDTH* 3)-1:0]    bufgtreset_us_out ;
  input [(PL_LINK_CAP_MAX_LINK_WIDTH* 3)-1:0]    bufgtrstmask_us_out ;
  input [PL_LINK_CAP_MAX_LINK_WIDTH-1:0]         cplllock_us_out;
  input [(PL_LINK_CAP_MAX_LINK_WIDTH*17)-1:0]    dmonitorout_us_out;
  input [(PL_LINK_CAP_MAX_LINK_WIDTH* 16)-1:0]   drpdo_us_out;
  input [(PL_LINK_CAP_MAX_LINK_WIDTH* 1)-1:0]    drprdy_us_out;
  input [PL_LINK_CAP_MAX_LINK_WIDTH-1:0]         eyescandataerror_us_out;
  input [PL_LINK_CAP_MAX_LINK_WIDTH-1:0]         gthtxn_us_out;
  input [PL_LINK_CAP_MAX_LINK_WIDTH-1:0]         gthtxp_us_out;
  input [PL_LINK_CAP_MAX_LINK_WIDTH-1:0]         gtpowergood_us_out;
  input [PL_LINK_CAP_MAX_LINK_WIDTH-1:0]         pcierategen3_us_out;
  input [PL_LINK_CAP_MAX_LINK_WIDTH-1:0]         pcierateidle_us_out;
  input [(PL_LINK_CAP_MAX_LINK_WIDTH*2)-1:0]     pcierateqpllpd_us_out;
  input [(PL_LINK_CAP_MAX_LINK_WIDTH*2)-1:0]     pcierateqpllreset_us_out;
  input [PL_LINK_CAP_MAX_LINK_WIDTH-1:0]         pciesynctxsyncdone_us_out;
  input [PL_LINK_CAP_MAX_LINK_WIDTH-1:0]         pcieusergen3rdy_us_out;
  input [PL_LINK_CAP_MAX_LINK_WIDTH-1:0]         pcieuserphystatusrst_us_out;
  input [PL_LINK_CAP_MAX_LINK_WIDTH-1:0]         pcieuserratestart_us_out;
  input [(PL_LINK_CAP_MAX_LINK_WIDTH*12)-1:0]    pcsrsvdout_us_out;
  input [PL_LINK_CAP_MAX_LINK_WIDTH-1:0]         phystatus_us_out;
  input [(PL_LINK_CAP_MAX_LINK_WIDTH*3)-1:0]     rxbufstatus_us_out;
  input [PL_LINK_CAP_MAX_LINK_WIDTH-1 : 0]       rxbyteisaligned_us_out;
  input [PL_LINK_CAP_MAX_LINK_WIDTH-1 : 0]       rxbyterealign_us_out;
  input [PL_LINK_CAP_MAX_LINK_WIDTH-1:0]         rxcdrlock_us_out;
  input [(PL_LINK_CAP_MAX_LINK_WIDTH * 2)-1 : 0] rxclkcorcnt_us_out;
  input [PL_LINK_CAP_MAX_LINK_WIDTH-1:0]         rxcommadet_us_out;
  input [(PL_LINK_CAP_MAX_LINK_WIDTH*16)-1:0]    rxctrl0_us_out;
  input [(PL_LINK_CAP_MAX_LINK_WIDTH*16)-1:0]    rxctrl1_us_out;
  input [(PL_LINK_CAP_MAX_LINK_WIDTH*8)-1:0]     rxctrl2_us_out;
  input [(PL_LINK_CAP_MAX_LINK_WIDTH*8)-1:0]     rxctrl3_us_out;
  input [(PL_LINK_CAP_MAX_LINK_WIDTH*128)-1:0]   rxdata_us_out;
  input [PL_LINK_CAP_MAX_LINK_WIDTH-1:0]         rxdlysresetdone_us_out;
  input [PL_LINK_CAP_MAX_LINK_WIDTH-1:0]         rxelecidle_us_out;
  input [PL_LINK_CAP_MAX_LINK_WIDTH-1 : 0]       rxoutclk_us_out;
  input [PL_LINK_CAP_MAX_LINK_WIDTH-1:0]         rxphaligndone_us_out;
  input [PL_LINK_CAP_MAX_LINK_WIDTH-1:0]         rxpmaresetdone_us_out;
  input [PL_LINK_CAP_MAX_LINK_WIDTH-1:0]         rxprbserr_us_out;
  input [PL_LINK_CAP_MAX_LINK_WIDTH-1:0]         rxprbslocked_us_out;
  input [PL_LINK_CAP_MAX_LINK_WIDTH-1:0]         rxprgdivresetdone_us_out;
  input [PL_LINK_CAP_MAX_LINK_WIDTH-1:0]         rxratedone_us_out;
  input [PL_LINK_CAP_MAX_LINK_WIDTH-1:0]         rxresetdone_us_out;
  input [(PL_LINK_CAP_MAX_LINK_WIDTH* 3)-1:0]    rxstatus_us_out;
  input [PL_LINK_CAP_MAX_LINK_WIDTH-1:0]         rxsyncdone_us_out;
  input [PL_LINK_CAP_MAX_LINK_WIDTH-1:0]         rxvalid_us_out;
  input [PL_LINK_CAP_MAX_LINK_WIDTH-1:0]         txdlysresetdone_us_out;
  input [PL_LINK_CAP_MAX_LINK_WIDTH-1:0]         txoutclk_us_out;
  input [PL_LINK_CAP_MAX_LINK_WIDTH-1:0]         txphaligndone_us_out;
  input [PL_LINK_CAP_MAX_LINK_WIDTH-1:0]         txphinitdone_us_out;
  input [PL_LINK_CAP_MAX_LINK_WIDTH-1 : 0]       txpmaresetdone_us_out;
  input [PL_LINK_CAP_MAX_LINK_WIDTH-1:0]         txprgdivresetdone_us_out;
  input [PL_LINK_CAP_MAX_LINK_WIDTH-1:0]         txresetdone_us_out;
  input [PL_LINK_CAP_MAX_LINK_WIDTH-1:0]         txsyncout_us_out;
  input [PL_LINK_CAP_MAX_LINK_WIDTH-1 : 0]       txsyncdone_us_out;

  output [PL_LINK_CAP_MAX_LINK_WIDTH-1:0]    cpllpd_us_in;
  output [PL_LINK_CAP_MAX_LINK_WIDTH-1 : 0]  rxdfeagchold_us_in;
  output [PL_LINK_CAP_MAX_LINK_WIDTH-1 : 0]  rxdfecfokhold_us_in;
  output [PL_LINK_CAP_MAX_LINK_WIDTH-1 : 0]  rxdfelfhold_us_in;
  output [PL_LINK_CAP_MAX_LINK_WIDTH-1 : 0]  rxdfekhhold_us_in;
  output [PL_LINK_CAP_MAX_LINK_WIDTH-1 : 0]  rxdfetap2hold_us_in;
  output [PL_LINK_CAP_MAX_LINK_WIDTH-1 : 0]  rxdfetap3hold_us_in;
  output [PL_LINK_CAP_MAX_LINK_WIDTH-1 : 0]  rxdfetap4hold_us_in;
  output [PL_LINK_CAP_MAX_LINK_WIDTH-1 : 0]  rxdfetap5hold_us_in;
  output [PL_LINK_CAP_MAX_LINK_WIDTH-1 : 0]  rxdfetap6hold_us_in;
  output [PL_LINK_CAP_MAX_LINK_WIDTH-1 : 0]  rxdfetap7hold_us_in;
  output [PL_LINK_CAP_MAX_LINK_WIDTH-1 : 0]  rxdfetap8hold_us_in;
  output [PL_LINK_CAP_MAX_LINK_WIDTH-1 : 0]  rxdfetap9hold_us_in;
  output [PL_LINK_CAP_MAX_LINK_WIDTH-1 : 0]  rxdfetap10hold_us_in;
  output [PL_LINK_CAP_MAX_LINK_WIDTH-1 : 0]  rxdfetap11hold_us_in;
  output [PL_LINK_CAP_MAX_LINK_WIDTH-1 : 0]  rxdfetap12hold_us_in;
  output [PL_LINK_CAP_MAX_LINK_WIDTH-1 : 0]  rxdfetap13hold_us_in;
  output [PL_LINK_CAP_MAX_LINK_WIDTH-1 : 0]  rxdfetap14hold_us_in;
  output [PL_LINK_CAP_MAX_LINK_WIDTH-1 : 0]  rxdfetap15hold_us_in;
  output [PL_LINK_CAP_MAX_LINK_WIDTH-1 : 0]  rxdfeuthold_us_in;
  output [PL_LINK_CAP_MAX_LINK_WIDTH-1 : 0]  rxdfevphold_us_in;
  output [PL_LINK_CAP_MAX_LINK_WIDTH-1 : 0]  rxoshold_us_in;
  output [PL_LINK_CAP_MAX_LINK_WIDTH-1 : 0]  rxlpmgchold_us_in;
  output [PL_LINK_CAP_MAX_LINK_WIDTH-1 : 0]  rxlpmhfhold_us_in;
  output [PL_LINK_CAP_MAX_LINK_WIDTH-1 : 0]  rxlpmlfhold_us_in;
  output [PL_LINK_CAP_MAX_LINK_WIDTH-1 : 0]  rxlpmoshold_us_in;

  output [PL_LINK_CAP_MAX_LINK_WIDTH-1:0]         cpllreset_us_in;
  output [PL_LINK_CAP_MAX_LINK_WIDTH-1:0]         dmonfiforeset_us_in;
  output [PL_LINK_CAP_MAX_LINK_WIDTH-1:0]         dmonitorclk_us_in;
  output [PL_LINK_CAP_MAX_LINK_WIDTH-1:0]         drpclk_us_in;
  output [(PL_LINK_CAP_MAX_LINK_WIDTH* 9)-1:0]    drpaddr_us_in;
  output [(PL_LINK_CAP_MAX_LINK_WIDTH* 16)-1:0]   drpdi_us_in;
  output [(PL_LINK_CAP_MAX_LINK_WIDTH* 1)-1:0]    drpen_us_in;
  output [(PL_LINK_CAP_MAX_LINK_WIDTH* 1)-1:0]    drpwe_us_in;
  output [PL_LINK_CAP_MAX_LINK_WIDTH-1:0]         eyescanreset_us_in;
  output [PL_LINK_CAP_MAX_LINK_WIDTH-1:0]         gthrxn_us_in;
  output [PL_LINK_CAP_MAX_LINK_WIDTH-1:0]         gthrxp_us_in;
  output [PL_LINK_CAP_MAX_LINK_WIDTH-1:0]         gtrefclk0_us_in;
  output [PL_LINK_CAP_MAX_LINK_WIDTH-1:0]         gtrxreset_us_in;
  output [PL_LINK_CAP_MAX_LINK_WIDTH-1:0]         gttxreset_us_in;
  output   gtwiz_reset_rx_done_us_in;
  output   gtwiz_reset_tx_done_us_in;
  output   gtwiz_userclk_rx_active_us_in ;
  output   gtwiz_userclk_tx_active_us_in ;
  output   gtwiz_userclk_tx_reset_us_in;
  output [(PL_LINK_CAP_MAX_LINK_WIDTH* 3)-1:0]    loopback_us_in;
  output [PL_LINK_CAP_MAX_LINK_WIDTH-1:0]         pcieeqrxeqadaptdone_us_in ;
  output [PL_LINK_CAP_MAX_LINK_WIDTH-1:0]         pcierstidle_us_in;
  output [PL_LINK_CAP_MAX_LINK_WIDTH-1:0]         pciersttxsyncstart_us_in;
  output [PL_LINK_CAP_MAX_LINK_WIDTH-1:0]         pcieuserratedone_us_in;
  output [(PL_LINK_CAP_MAX_LINK_WIDTH*16)-1:0]    pcsrsvdin_us_in;
  output [PL_LINK_CAP_MAX_LINK_WIDTH-1:0]         rx8b10ben_us_in;
  output [PL_LINK_CAP_MAX_LINK_WIDTH-1:0]         rxbufreset_us_in;
  output [PL_LINK_CAP_MAX_LINK_WIDTH-1:0]         rxcdrhold_us_in;
  output [PL_LINK_CAP_MAX_LINK_WIDTH-1:0]         rxcommadeten_us_in;
  output [PL_LINK_CAP_MAX_LINK_WIDTH-1:0]         rxlpmen_us_in;
  output [PL_LINK_CAP_MAX_LINK_WIDTH-1:0]         rxmcommaalignen_us_in;
  output [PL_LINK_CAP_MAX_LINK_WIDTH-1:0]         rxpcommaalignen_us_in;
  output [(PL_LINK_CAP_MAX_LINK_WIDTH* 2)-1:0]    rxpd_us_in;
  output [PL_LINK_CAP_MAX_LINK_WIDTH-1:0]         rxpolarity_us_in;
  output [PL_LINK_CAP_MAX_LINK_WIDTH-1:0]         rxprbscntreset_us_in;
  output [(PL_LINK_CAP_MAX_LINK_WIDTH* 4)-1:0]    rxprbssel_us_in;
  output [PL_LINK_CAP_MAX_LINK_WIDTH-1:0]         rxprogdivreset_us_in;
  output [(PL_LINK_CAP_MAX_LINK_WIDTH* 3)-1:0]    rxrate_us_in;
  output [PL_LINK_CAP_MAX_LINK_WIDTH-1:0]         rxratemode_us_in;
  output [PL_LINK_CAP_MAX_LINK_WIDTH-1:0]         rxslide_us_in;
  output [PL_LINK_CAP_MAX_LINK_WIDTH-1:0]         rxuserrdy_us_in;
  output [PL_LINK_CAP_MAX_LINK_WIDTH-1:0]         rxusrclk2_us_in;
  output [PL_LINK_CAP_MAX_LINK_WIDTH-1:0]         rxusrclk_us_in;
  output [PL_LINK_CAP_MAX_LINK_WIDTH-1:0]         tx8b10ben_us_in;
  output [(PL_LINK_CAP_MAX_LINK_WIDTH*16)-1:0]    txctrl0_us_in;
  output [(PL_LINK_CAP_MAX_LINK_WIDTH*16)-1:0]    txctrl1_us_in;
  output [(PL_LINK_CAP_MAX_LINK_WIDTH* 8)-1:0]    txctrl2_us_in;
  output [(PL_LINK_CAP_MAX_LINK_WIDTH*128)-1:0]   txdata_us_in;
  output [PL_LINK_CAP_MAX_LINK_WIDTH-1:0]         txdeemph_us_in;
  output [PL_LINK_CAP_MAX_LINK_WIDTH-1:0]         txdetectrx_us_in;
  output [(PL_LINK_CAP_MAX_LINK_WIDTH*4)-1:0]     txdiffctrl_us_in;
  output [PL_LINK_CAP_MAX_LINK_WIDTH-1:0]         txdlybypass_us_in;
  output [PL_LINK_CAP_MAX_LINK_WIDTH-1:0]         txdlyen_us_in;
  output [PL_LINK_CAP_MAX_LINK_WIDTH-1:0]         txdlyhold_us_in;
  output [PL_LINK_CAP_MAX_LINK_WIDTH-1:0]         txdlyovrden_us_in;
  output [PL_LINK_CAP_MAX_LINK_WIDTH-1:0]         txdlysreset_us_in;
  output [PL_LINK_CAP_MAX_LINK_WIDTH-1:0]         txdlyupdown_us_in;
  output [PL_LINK_CAP_MAX_LINK_WIDTH-1:0]         txelecidle_us_in;
  output [PL_LINK_CAP_MAX_LINK_WIDTH-1:0]         txinhibit_us_in;
  output [(PL_LINK_CAP_MAX_LINK_WIDTH* 7)-1:0]    txmaincursor_us_in;
  output [(PL_LINK_CAP_MAX_LINK_WIDTH* 3)-1:0]    txmargin_us_in;
  output [(PL_LINK_CAP_MAX_LINK_WIDTH* 3)-1:0]    txoutclksel_us_in;
  output [(PL_LINK_CAP_MAX_LINK_WIDTH* 2)-1:0]    txpd_us_in;
  output [PL_LINK_CAP_MAX_LINK_WIDTH-1:0]         txphalign_us_in;
  output [PL_LINK_CAP_MAX_LINK_WIDTH-1:0]         txphalignen_us_in;
  output [PL_LINK_CAP_MAX_LINK_WIDTH-1:0]         txphdlypd_us_in;
  output [PL_LINK_CAP_MAX_LINK_WIDTH-1:0]         txphdlyreset_us_in;
  output [PL_LINK_CAP_MAX_LINK_WIDTH-1:0]         txphdlytstclk_us_in ;
  output [PL_LINK_CAP_MAX_LINK_WIDTH-1:0]         txphinit_us_in;
  output [PL_LINK_CAP_MAX_LINK_WIDTH-1:0]         txphovrden_us_in;
  output [(PL_LINK_CAP_MAX_LINK_WIDTH* 5)-1:0]    txpostcursor_us_in;
  output [PL_LINK_CAP_MAX_LINK_WIDTH-1:0]         txprbsforceerr_us_in;
  output [(PL_LINK_CAP_MAX_LINK_WIDTH* 4)-1:0]    txprbssel_us_in;
  output [(PL_LINK_CAP_MAX_LINK_WIDTH* 5)-1:0]    txprecursor_us_in;
  output [PL_LINK_CAP_MAX_LINK_WIDTH-1:0]         txprogdivreset_us_in;
  output [(PL_LINK_CAP_MAX_LINK_WIDTH* 3)-1:0]    txrate_us_in;
  output [PL_LINK_CAP_MAX_LINK_WIDTH-1:0]         txswing_us_in;
  output [(PL_LINK_CAP_MAX_LINK_WIDTH-1) : 0]     txsyncallin_us_in;
  output [(PL_LINK_CAP_MAX_LINK_WIDTH-1) : 0]     txsyncin_us_in;
  output [PL_LINK_CAP_MAX_LINK_WIDTH-1:0]         txsyncmode_us_in;
  output [PL_LINK_CAP_MAX_LINK_WIDTH-1:0]         txuserrdy_us_in;
  output [PL_LINK_CAP_MAX_LINK_WIDTH-1:0]         txusrclk2_us_in;
  output [PL_LINK_CAP_MAX_LINK_WIDTH-1:0]         txusrclk_us_in;

  output [PL_LINK_CAP_MAX_LINK_WIDTH-1 : 0]       qpll0clk_us_in;
  output [PL_LINK_CAP_MAX_LINK_WIDTH-1 : 0]       qpll0refclk_us_in;
  output [PL_LINK_CAP_MAX_LINK_WIDTH-1 : 0]       qpll1clk_us_in;
  output [PL_LINK_CAP_MAX_LINK_WIDTH-1 : 0]       qpll1refclk_us_in;

  output [(PL_LINK_CAP_MAX_LINK_WIDTH-1)>>2:0]    gtrefclk01_us_in;
  output [(PL_LINK_CAP_MAX_LINK_WIDTH-1)>>2:0]    qpll1pd_us_in;
  output [(PL_LINK_CAP_MAX_LINK_WIDTH-1)>>2:0]    qpll1reset_us_in;
  output [((((PL_LINK_CAP_MAX_LINK_WIDTH-1)>>2)+1)* 5)-1:0] qpllrsvd2_us_in;
  output [((((PL_LINK_CAP_MAX_LINK_WIDTH-1)>>2)+1)* 5)-1:0] qpllrsvd3_us_in;
  input [(PL_LINK_CAP_MAX_LINK_WIDTH-1)>>2:0]     qpll1lock_us_out;
  input [(PL_LINK_CAP_MAX_LINK_WIDTH-1)>>2:0]     qpll1outclk_us_out;
  input [(PL_LINK_CAP_MAX_LINK_WIDTH-1)>>2:0]     qpll1outrefclk_us_out;

  input  [31:0]			pipe_debug_ctl_in_tx0;
  input	 [31:0]		  pipe_debug_ctl_in_tx1;
  input	 [31:0]		  pipe_debug_ctl_in_rx0;
  input  [31:0]			pipe_debug_ctl_in_rx1;
  input					    pipe_debug_ltssm_rec_spd_1;
  input					    pipe_debug_ltssm_pol_act;
  input  [3:0] 			pipe_debug_ctl_vec4;
  input  [31:0] 		pipe_debug_mux_ctl;
  output [127:0]		pipe_debug_debug_out_128_0;
  output [15:0]			pipe_debug_debug_out_ext_16_0;
  output [127:0]		pipe_debug_debug_out_128_1;
  output [15:0]			pipe_debug_debug_out_ext_16_1;
  output [127:0]		pipe_debug_debug_out_128_2;
  output [15:0]			pipe_debug_debug_out_ext_16_2;
  output [127:0]		pipe_debug_debug_out_128_3;
  output [15:0]			pipe_debug_debug_out_ext_16_3;
  output [7:0] 			pipe_debug_inject_tx_status;
  output [7:0] 			pipe_debug_inject_rx_status;

  input  [15:0]    cfg_vend_id;
  input  [15:0]    cfg_subsys_vend_id;
  input  [15:0]    cfg_dev_id_pf0;
  input  [15:0]    cfg_dev_id_pf1;
  input  [15:0]    cfg_dev_id_pf2;
  input  [15:0]    cfg_dev_id_pf3;
  input  [7:0]     cfg_rev_id_pf0;
  input  [7:0]     cfg_rev_id_pf1;
  input  [7:0]     cfg_rev_id_pf2;
  input  [7:0]     cfg_rev_id_pf3;
  input  [15:0]    cfg_subsys_id_pf0;
  input  [15:0]    cfg_subsys_id_pf1;
  input  [15:0]    cfg_subsys_id_pf2;
  input  [15:0]    cfg_subsys_id_pf3;

  input  [25:0] common_commands_in;
  input  [83:0] pipe_rx_0_sigs;
  input  [83:0] pipe_rx_1_sigs;
  input  [83:0] pipe_rx_2_sigs;
  input  [83:0] pipe_rx_3_sigs;
  input  [83:0] pipe_rx_4_sigs;
  input  [83:0] pipe_rx_5_sigs;
  input  [83:0] pipe_rx_6_sigs;
  input  [83:0] pipe_rx_7_sigs;
  input  [83:0] pipe_rx_8_sigs;
  input  [83:0] pipe_rx_9_sigs;
  input  [83:0] pipe_rx_10_sigs;
  input  [83:0] pipe_rx_11_sigs;
  input  [83:0] pipe_rx_12_sigs;
  input  [83:0] pipe_rx_13_sigs;
  input  [83:0] pipe_rx_14_sigs;
  input  [83:0] pipe_rx_15_sigs;

  output [25:0] common_commands_out;
  output [83:0] pipe_tx_0_sigs;
  output [83:0] pipe_tx_1_sigs;
  output [83:0] pipe_tx_2_sigs;
  output [83:0] pipe_tx_3_sigs;
  output [83:0] pipe_tx_4_sigs;
  output [83:0] pipe_tx_5_sigs;
  output [83:0] pipe_tx_6_sigs;
  output [83:0] pipe_tx_7_sigs;
  output [83:0] pipe_tx_8_sigs;
  output [83:0] pipe_tx_9_sigs;
  output [83:0] pipe_tx_10_sigs;
  output [83:0] pipe_tx_11_sigs;
  output [83:0] pipe_tx_12_sigs;
  output [83:0] pipe_tx_13_sigs;
  output [83:0] pipe_tx_14_sigs;
  output [83:0] pipe_tx_15_sigs;

  input  [18:0] cfg_mgmt_addr;
  input         cfg_mgmt_write;
  input  [31:0] cfg_mgmt_write_data;
  input  [3:0]  cfg_mgmt_byte_enable;
  input         cfg_mgmt_read;
  output [31:0] cfg_mgmt_read_data;
  output        cfg_mgmt_read_write_done;
  input         cfg_mgmt_type1_cfg_reg_access;

  output gt_drp_clk ;
  output axi_aclk;
  output axi_aresetn;

  input        axi_ctl_aclk;
  output       axi_ctl_aresetn;
  output [5:0] cfg_ltssm_state;

  input  [XDMA_NUM_USR_IRQ-1:0]   usr_irq_req;
  output [XDMA_NUM_USR_IRQ-1:0]   usr_irq_ack;
  input  [2*XDMA_NUM_USR_IRQ-1:0] usr_irq_function_number;
  output                          msi_enable;
  output                          msix_enable;
  output [2:0]                    msi_vector_width;

  output  [C_M_AXI_ID_WIDTH-1 : 0]     m_axi_awid;
  output  [AXI_ADDR_WIDTH-1 : 0]       m_axi_awaddr;
  output  [7 : 0]                      m_axi_awlen;
  output  [2 : 0]                      m_axi_awsize;
  output  [1 : 0]                      m_axi_awburst;
  output  [2 : 0]                      m_axi_awprot;
  output                               m_axi_awvalid;
  input                                m_axi_awready;
  output                               m_axi_awlock;
  output  [3 : 0]                      m_axi_awcache;
  output  [C_M_AXI_DATA_WIDTH-1 : 0]   m_axi_wdata;
  output  [C_M_AXI_DATA_WIDTH/8-1 : 0] m_axi_wuser;
  output  [C_M_AXI_DATA_WIDTH/8-1 : 0] m_axi_wstrb;
  output                               m_axi_wlast;
  output                               m_axi_wvalid;
  input                                m_axi_wready;
  input  [C_M_AXI_ID_WIDTH-1 : 0]      m_axi_bid;
  input  [1 : 0]                       m_axi_bresp;
  input                                m_axi_bvalid;
  output                               m_axi_bready;
  output  [C_M_AXI_ID_WIDTH-1 : 0]     m_axi_arid;
  output  [AXI_ADDR_WIDTH-1 : 0]       m_axi_araddr;
  output  [7 : 0]                      m_axi_arlen;
  output  [2 : 0]                      m_axi_arsize;
  output  [1 : 0]                      m_axi_arburst;
  output  [2 : 0]                      m_axi_arprot;
  output                               m_axi_arvalid;
  input                                m_axi_arready;
  output                               m_axi_arlock;
  output  [3 : 0]                      m_axi_arcache;
  input  [C_M_AXI_ID_WIDTH-1 : 0]      m_axi_rid;
  input  [C_M_AXI_DATA_WIDTH-1 : 0]    m_axi_rdata;
  input  [C_M_AXI_DATA_WIDTH/8-1 : 0]  m_axi_ruser;
  input  [1 : 0]                       m_axi_rresp;
  input                                m_axi_rlast;
  input                                m_axi_rvalid;
  output                               m_axi_rready;
  // Axi bypass
  output  [C_M_AXI_ID_WIDTH-1 : 0]     m_axib_awid;
  output  [AXI_ADDR_WIDTH-1 : 0]       m_axib_awaddr;
  output  [C_M_AXI_AWUSER_WIDTH-1 : 0] m_axib_awuser;
  output  [7 : 0]                      m_axib_awlen;
  output  [2 : 0]                      m_axib_awsize;
  output  [1 : 0]                      m_axib_awburst;
  output  [2 : 0]                      m_axib_awprot;
  output                               m_axib_awvalid;
  input                                m_axib_awready;
  output                               m_axib_awlock;
  output  [3 : 0]                      m_axib_awcache;
  output  [C_M_AXI_DATA_WIDTH-1 : 0]   m_axib_wdata ;
  output  [C_M_AXI_DATA_WIDTH/8-1 : 0] m_axib_wuser;
  output  [C_M_AXI_DATA_WIDTH/8-1 : 0] m_axib_wstrb ;
  output                               m_axib_wlast ;
  output                               m_axib_wvalid ;
  input                                m_axib_wready ;
  input  [C_M_AXI_ID_WIDTH-1 : 0]      m_axib_bid ;
  input  [1 : 0]                       m_axib_bresp ;
  input                                m_axib_bvalid ;
  output                               m_axib_bready ;
  output  [C_M_AXI_ID_WIDTH-1 : 0]     m_axib_arid ;
  output  [AXI_ADDR_WIDTH-1 : 0]       m_axib_araddr ;
  output  [C_M_AXI_ARUSER_WIDTH-1 : 0] m_axib_aruser ;
  output  [7 : 0]                      m_axib_arlen ;
  output  [2 : 0]                      m_axib_arsize ;
  output  [1 : 0]                      m_axib_arburst ;
  output  [2 : 0]                      m_axib_arprot ;
  output                               m_axib_arvalid ;
  input                                m_axib_arready ;
  output                               m_axib_arlock;
  output  [3 : 0]                      m_axib_arcache;
  input  [C_M_AXI_ID_WIDTH-1 : 0]      m_axib_rid ;
  input  [C_M_AXI_DATA_WIDTH-1 : 0]    m_axib_rdata ;
  input  [C_M_AXI_DATA_WIDTH/8-1 : 0]  m_axib_ruser;
  input  [1 : 0]                       m_axib_rresp ;
  input                                m_axib_rlast ;
  input                                m_axib_rvalid ;
  output                               m_axib_rready ;

  // C2H AXI ST interface to user Channle 0
  input    [C_S_AXIS_DATA_WIDTH-1:0]   s_axis_c2h_tdata_0;
  input                                s_axis_c2h_tlast_0;
  input    [C_S_AXIS_DATA_WIDTH/8-1:0] s_axis_c2h_tuser_0;
  input    [C_S_AXIS_DATA_WIDTH/8-1:0] s_axis_c2h_tkeep_0;
  input                                s_axis_c2h_tvalid_0;
  output                               s_axis_c2h_tready_0;
  // C2H AXI ST interface to user Channle 1
  input    [C_S_AXIS_DATA_WIDTH-1:0]   s_axis_c2h_tdata_1;
  input                                s_axis_c2h_tlast_1;
  input    [C_S_AXIS_DATA_WIDTH/8-1:0] s_axis_c2h_tuser_1;
  input    [C_S_AXIS_DATA_WIDTH/8-1:0] s_axis_c2h_tkeep_1;
  input                                s_axis_c2h_tvalid_1;
  output                               s_axis_c2h_tready_1;
  // C2H AXI ST interface to user Channle 2
  input    [C_S_AXIS_DATA_WIDTH-1:0]   s_axis_c2h_tdata_2;
  input                                s_axis_c2h_tlast_2;
  input    [C_S_AXIS_DATA_WIDTH/8-1:0] s_axis_c2h_tuser_2;
  input    [C_S_AXIS_DATA_WIDTH/8-1:0] s_axis_c2h_tkeep_2;
  input                                s_axis_c2h_tvalid_2;
  output                               s_axis_c2h_tready_2;
  // C2H AXI ST interface to user Channle 3
  input    [C_S_AXIS_DATA_WIDTH-1:0]   s_axis_c2h_tdata_3;
  input                                s_axis_c2h_tlast_3;
  input    [C_S_AXIS_DATA_WIDTH/8-1:0] s_axis_c2h_tuser_3;
  input    [C_S_AXIS_DATA_WIDTH/8-1:0] s_axis_c2h_tkeep_3;
  input                                s_axis_c2h_tvalid_3;
  output                               s_axis_c2h_tready_3;

  // H2C AXI ST interface to user Channel 0
  output   [C_M_AXIS_DATA_WIDTH-1:0]   m_axis_h2c_tdata_0;
  output                               m_axis_h2c_tlast_0;
  output   [C_M_AXIS_DATA_WIDTH/8-1:0] m_axis_h2c_tuser_0;
  output   [C_M_AXIS_DATA_WIDTH/8-1:0] m_axis_h2c_tkeep_0;
  output                               m_axis_h2c_tvalid_0;
  input                                m_axis_h2c_tready_0;
  // H2C AXI ST interface to user Channel 1
  output   [C_M_AXIS_DATA_WIDTH-1:0]   m_axis_h2c_tdata_1;
  output                               m_axis_h2c_tlast_1;
  output   [C_M_AXIS_DATA_WIDTH/8-1:0] m_axis_h2c_tuser_1;
  output   [C_M_AXIS_DATA_WIDTH/8-1:0] m_axis_h2c_tkeep_1;
  output                               m_axis_h2c_tvalid_1;
  input                                m_axis_h2c_tready_1;
  // H2C AXI ST interface to user Channel 2
  output   [C_M_AXIS_DATA_WIDTH-1:0]   m_axis_h2c_tdata_2;
  output                               m_axis_h2c_tlast_2;
  output   [C_M_AXIS_DATA_WIDTH/8-1:0] m_axis_h2c_tuser_2;
  output   [C_M_AXIS_DATA_WIDTH/8-1:0] m_axis_h2c_tkeep_2;
  output                               m_axis_h2c_tvalid_2;
  input                                m_axis_h2c_tready_2;
  // H2C AXI ST interface to user Channel 3
  output   [C_M_AXIS_DATA_WIDTH-1:0]   m_axis_h2c_tdata_3;
  output                               m_axis_h2c_tlast_3;
  output   [C_M_AXIS_DATA_WIDTH/8-1:0] m_axis_h2c_tuser_3;
  output   [C_M_AXIS_DATA_WIDTH/8-1:0] m_axis_h2c_tkeep_3;
  output                               m_axis_h2c_tvalid_3;
  input                                m_axis_h2c_tready_3;

  output  [31 : 0]                     m_axil_awaddr;
  output  [C_M_AXIL_AWUSER_WIDTH-1: 0] m_axil_awuser;
  output  [2 : 0]                      m_axil_awprot;
  output                               m_axil_awvalid;
  input                                m_axil_awready;
  output  [31 : 0]                     m_axil_wdata;
  output  [3 : 0]                      m_axil_wstrb;
  output                               m_axil_wvalid;
  input                                m_axil_wready;
  input                                m_axil_bvalid;
  input  [1:0]                         m_axil_bresp;
  output                               m_axil_bready;
  output  [31 : 0]                     m_axil_araddr;
  output  [C_M_AXIL_ARUSER_WIDTH-1: 0] m_axil_aruser;
  output  [2 : 0]                      m_axil_arprot;
  output                               m_axil_arvalid;
  input                                m_axil_arready;
  input  [31 : 0]                      m_axil_rdata ;
  input  [1 : 0]                       m_axil_rresp ;
  input                                m_axil_rvalid;
  output                               m_axil_rready;
  input  [31 : 0]                      s_axil_awaddr;
  input  [2 : 0]                       s_axil_awprot;
  input                                s_axil_awvalid;
  output                               s_axil_awready;
  input  [31 : 0]                      s_axil_wdata ;
  input  [3 : 0]                       s_axil_wstrb ;
  input                                s_axil_wvalid;
  output                               s_axil_wready;
  output                               s_axil_bvalid;
  output  [1:0]                        s_axil_bresp;
  input                                s_axil_bready;
  input  [31 : 0]                      s_axil_araddr;
  input  [2 : 0]                       s_axil_arprot;
  input                                s_axil_arvalid;
  output                               s_axil_arready;
  output  [31 : 0]                     s_axil_rdata ;
  output  [1 : 0]                      s_axil_rresp;
  output                               s_axil_rvalid;
  input                                s_axil_rready;
  //-- AXI Slave Write Address Channel
  input [C_S_AXI_ID_WIDTH-1:0]         s_axib_awid;
  input [AXI_ADDR_WIDTH-1:0]           s_axib_awaddr;
  input [3:0]                          s_axib_awregion;
  input [7:0]                          s_axib_awlen;
  input [2:0]                          s_axib_awsize;
  input [1:0]                          s_axib_awburst;
  input                                s_axib_awvalid;
  output                               s_axib_awready;
  //-- AXI Slave Write Data Channel
  input [C_S_AXI_DATA_WIDTH-1:0]       s_axib_wdata;
  input [C_S_AXI_DATA_WIDTH/8-1:0]     s_axib_wuser;
  input [C_S_AXI_DATA_WIDTH/8-1:0]     s_axib_wstrb;
  input                                s_axib_wlast;
  input                                s_axib_wvalid;
  output                               s_axib_wready;
  //-- AXI Slave Write Response Channel
  output [C_S_AXI_ID_WIDTH-1:0]        s_axib_bid;
  output [1:0]                         s_axib_bresp;
  output                               s_axib_bvalid;
  input                                s_axib_bready;
  //-- AXI Slave Read Address Channel
  input  [C_S_AXI_ID_WIDTH-1:0]        s_axib_arid;
  input  [AXI_ADDR_WIDTH-1:0]          s_axib_araddr;
  input  [3:0]                         s_axib_arregion;
  input  [7:0]                         s_axib_arlen;
  input  [2:0]                         s_axib_arsize;
  input  [1:0]                         s_axib_arburst;
  input                                s_axib_arvalid;
  output                               s_axib_arready;
  //-- AXI Slave Read Data Channel
  output [C_S_AXI_ID_WIDTH-1:0]        s_axib_rid;
  output [1:0]                         s_axib_rresp;
  output                               s_axib_rlast;
  output                               s_axib_rvalid;
  output [C_S_AXI_DATA_WIDTH-1:0]      s_axib_rdata;
  output [(C_S_AXI_DATA_WIDTH/8)-1:0]  s_axib_ruser;
  input                                s_axib_rready;
  // Descriptor Bypass channel 0
  output         c2h_dsc_byp_ready_0;
  input  [63:0]  c2h_dsc_byp_src_addr_0;
  input  [63:0]  c2h_dsc_byp_dst_addr_0;
  input  [27:0]  c2h_dsc_byp_len_0;
  input  [15:0]  c2h_dsc_byp_ctl_0;
  input          c2h_dsc_byp_load_0;

  output         h2c_dsc_byp_ready_0;
  input  [63:0]  h2c_dsc_byp_src_addr_0;
  input  [63:0]  h2c_dsc_byp_dst_addr_0;
  input  [27:0]  h2c_dsc_byp_len_0;
  input  [15:0]  h2c_dsc_byp_ctl_0;
  input          h2c_dsc_byp_load_0;

  // Descriptor Bypass channel 1
  output         c2h_dsc_byp_ready_1;
  input  [63:0]  c2h_dsc_byp_src_addr_1;
  input  [63:0]  c2h_dsc_byp_dst_addr_1;
  input  [27:0]  c2h_dsc_byp_len_1;
  input  [15:0]  c2h_dsc_byp_ctl_1;
  input          c2h_dsc_byp_load_1;

  output          h2c_dsc_byp_ready_1;
  input   [63:0]  h2c_dsc_byp_src_addr_1;
  input   [63:0]  h2c_dsc_byp_dst_addr_1;
  input   [27:0]  h2c_dsc_byp_len_1;
  input   [15:0]  h2c_dsc_byp_ctl_1;
  input           h2c_dsc_byp_load_1;

  // Descriptor Bypass channel 2
  output         c2h_dsc_byp_ready_2;
  input  [63:0]  c2h_dsc_byp_src_addr_2;
  input  [63:0]  c2h_dsc_byp_dst_addr_2;
  input  [27:0]  c2h_dsc_byp_len_2;
  input  [15:0]  c2h_dsc_byp_ctl_2;
  input          c2h_dsc_byp_load_2;

  output         h2c_dsc_byp_ready_2;
  input  [63:0]  h2c_dsc_byp_src_addr_2;
  input  [63:0]  h2c_dsc_byp_dst_addr_2;
  input  [27:0]  h2c_dsc_byp_len_2;
  input  [15:0]  h2c_dsc_byp_ctl_2;
  input          h2c_dsc_byp_load_2;

  // Descriptor Bypass channel 3
  output         c2h_dsc_byp_ready_3;
  input  [63:0]  c2h_dsc_byp_src_addr_3;
  input  [63:0]  c2h_dsc_byp_dst_addr_3;
  input  [27:0]  c2h_dsc_byp_len_3;
  input  [15:0]  c2h_dsc_byp_ctl_3;
  input          c2h_dsc_byp_load_3;

  output         h2c_dsc_byp_ready_3;
  input  [63:0]  h2c_dsc_byp_src_addr_3;
  input  [63:0]  h2c_dsc_byp_dst_addr_3;
  input  [27:0]  h2c_dsc_byp_len_3;
  input  [15:0]  h2c_dsc_byp_ctl_3;
  input          h2c_dsc_byp_load_3;

  // Status Channel 0
  output   [STS_WIDTH-1:0] c2h_sts_0;
  output   [STS_WIDTH-1:0] h2c_sts_0;

  // Status Channel 1
  output   [STS_WIDTH-1:0] c2h_sts_1;
  output   [STS_WIDTH-1:0] h2c_sts_1;

  // Status Channel 2
  output   [STS_WIDTH-1:0] c2h_sts_2;
  output   [STS_WIDTH-1:0] h2c_sts_2;

  // Status Channel 3
  output   [STS_WIDTH-1:0] c2h_sts_3;
  output   [STS_WIDTH-1:0] h2c_sts_3;

  output  rd_interrupt;
  output  wr_interrupt;
  output  ats_pri_en;

  // AXI SLAVE Interface to MicroProcessor
  // AXI Lite Slave interface to DVSEC block;
  input   s_aclk;
  input   s_aresetn;

  input   [13:0]  s_axi_araddr;
  input   [1:0]   s_axi_arburst;
  input   [3:0]   s_axi_arcache;
  input   [15:0]  s_axi_arid;
  input   [7:0]   s_axi_arlen;
  input   [0:0]   s_axi_arlock;
  input   [2:0]   s_axi_arprot;
  input   [3:0]   s_axi_arqos;
  output          s_axi_arready;
  input   [2:0]   s_axi_arsize;
  input   [15:0]  s_axi_aruser;
  input           s_axi_arvalid;
  input   [13:0]  s_axi_awaddr;
  input   [1:0]   s_axi_awburst;
  input   [3:0]   s_axi_awcache;
  input   [15:0]  s_axi_awid;
  input   [7:0]   s_axi_awlen;
  input   [0:0]   s_axi_awlock;
  input   [2:0]   s_axi_awprot;
  input   [3:0]   s_axi_awqos;
  output          s_axi_awready;
  input   [2:0]   s_axi_awsize;
  input   [15:0]  s_axi_awuser;
  input           s_axi_awvalid;
  output   [15:0] s_axi_bid;
  input           s_axi_bready;
  output   [1:0]  s_axi_bresp;
  output          s_axi_bvalid;
  output   [31:0] s_axi_rdata;
  output   [15:0] s_axi_rid;
  output          s_axi_rlast;
  input           s_axi_rready;
  output   [1:0]  s_axi_rresp;
  output          s_axi_rvalid;
  input   [31:0]  s_axi_wdata;
  input           s_axi_wlast;
  output          s_axi_wready;
  input   [3:0]   s_axi_wstrb;
  input           s_axi_wvalid;

  input           cfg_fc_vc_sel;
  output          core_clk;

  // CXS interface
  input           cxs0_active_req_tx;
  output          cxs0_active_ack_tx;
  output          cxs0_deact_hint_tx;
  input           cxs0_valid_tx;
  output          cxs0_crdgnt_tx;
  input           cxs0_crdrtn_tx;
  input  [AXIS_CCIX_TX_TUSER_WIDTH-(AXIS_CCIX_TX_TDATA_WIDTH/8)-2:0]   cxs0_cntl_tx;
  input  [AXIS_CCIX_TX_TDATA_WIDTH-1:0]  cxs0_data_tx;
  input           cxs0_valid_chk_tx;
  output          cxs0_crdgnt_chk_tx;
  input           cxs0_crdrtn_chk_tx;
  input           cxs0_cntl_chk_tx;
  input  [AXIS_CCIX_TX_TDATA_WIDTH/8-1:0]   cxs0_data_chk_tx;
  output          cxs0_active_req_rx;
  input           cxs0_active_ack_rx;
  input           cxs0_deact_hint_rx;
  output          cxs0_valid_rx;
  input           cxs0_crdgnt_rx;
  output          cxs0_crdrtn_rx;
  output [AXIS_CCIX_RX_TUSER_WIDTH-(AXIS_CCIX_RX_TDATA_WIDTH/8)-2:0]   cxs0_cntl_rx;
  output [AXIS_CCIX_RX_TDATA_WIDTH-1:0]  cxs0_data_rx;
  output          cxs0_valid_chk_rx;
  input           cxs0_crdgnt_chk_rx;
  output          cxs0_crdrtn_chk_rx;
  output          cxs0_cntl_chk_rx;
  output [AXIS_CCIX_RX_TDATA_WIDTH/8-1:0]   cxs0_data_chk_rx;

  input           ccix_optimized_tlp_tx_and_rx_enable_in;

  // CXS interface
  output    pcie4_cxs0_active_req_tx_sd;
  input     pcie4_cxs0_active_ack_tx_sd;
  input     pcie4_cxs0_deact_hint_tx_sd;
  output    pcie4_cxs0_valid_tx_sd;
  input     pcie4_cxs0_crdgnt_tx_sd;
  output    pcie4_cxs0_crdrtn_tx_sd;
  output [AXIS_CCIX_TX_TUSER_WIDTH-(AXIS_CCIX_TX_TDATA_WIDTH/8)-2:0]   pcie4_cxs0_cntl_tx_sd;
  output [AXIS_CCIX_TX_TDATA_WIDTH-1:0]  pcie4_cxs0_data_tx_sd;
  output    pcie4_cxs0_valid_chk_tx_sd;
  input     pcie4_cxs0_crdgnt_chk_tx_sd;
  output    pcie4_cxs0_crdrtn_chk_tx_sd;
  output    pcie4_cxs0_cntl_chk_tx_sd;
  output [AXIS_CCIX_TX_TDATA_WIDTH/8-1:0]   pcie4_cxs0_data_chk_tx_sd;
  input     pcie4_cxs0_active_req_rx_sd;
  output    pcie4_cxs0_active_ack_rx_sd;
  output    pcie4_cxs0_deact_hint_rx_sd;
  input     pcie4_cxs0_valid_rx_sd;
  output    pcie4_cxs0_crdgnt_rx_sd;
  input     pcie4_cxs0_crdrtn_rx_sd;
  input  [AXIS_CCIX_RX_TUSER_WIDTH-(AXIS_CCIX_RX_TDATA_WIDTH/8)-2:0]   pcie4_cxs0_cntl_rx_sd;
  input  [AXIS_CCIX_RX_TDATA_WIDTH-1:0]  pcie4_cxs0_data_rx_sd;
  input     pcie4_cxs0_valid_chk_rx_sd;
  output    pcie4_cxs0_crdgnt_chk_rx_sd;
  input     pcie4_cxs0_crdrtn_chk_rx_sd;
  input     pcie4_cxs0_cntl_chk_rx_sd;
  input  [AXIS_CCIX_RX_TDATA_WIDTH/8-1:0]   pcie4_cxs0_data_chk_rx_sd;

  // System Cache1 Interface
  //RQ Interface
  input                             sc0_ats_s_axis_rq_tvalid;
  output                            sc0_ats_s_axis_rq_tready;
  input [C_ATS_DATA_WIDTH-1:0]      sc0_ats_s_axis_rq_tdata;
  input [C_ATS_DATA_WIDTH/8-1:0]    sc0_ats_s_axis_rq_tkeep;
  input                             sc0_ats_s_axis_rq_tlast;
  input [C_ATS_RQ_TUSER_WIDTH-1:0]  sc0_ats_s_axis_rq_tuser;

  //RC Interface
  output                            sc0_ats_m_axis_rc_tvalid;
  input                             sc0_ats_m_axis_rc_tready;
  output [C_ATS_DATA_WIDTH-1:0]     sc0_ats_m_axis_rc_tdata;
  output [C_ATS_DATA_WIDTH/8-1:0]   sc0_ats_m_axis_rc_tkeep;
  output                            sc0_ats_m_axis_rc_tlast;
  output [C_ATS_RC_TUSER_WIDTH-1:0] sc0_ats_m_axis_rc_tuser;

  //CC Interface
  input                             sc0_ats_s_axis_cc_tvalid;
  output                            sc0_ats_s_axis_cc_tready;
  input [C_ATS_DATA_WIDTH-1:0]      sc0_ats_s_axis_cc_tdata;
  input [C_ATS_DATA_WIDTH/8-1:0]    sc0_ats_s_axis_cc_tkeep;
  input                             sc0_ats_s_axis_cc_tlast;
  input [C_ATS_CC_TUSER_WIDTH-1:0]  sc0_ats_s_axis_cc_tuser;

  //CQ Interface
  output                            sc0_ats_m_axis_cq_tvalid;
  input                             sc0_ats_m_axis_cq_tready;
  output [C_ATS_DATA_WIDTH-1:0]     sc0_ats_m_axis_cq_tdata;
  output [C_ATS_DATA_WIDTH/8-1:0]   sc0_ats_m_axis_cq_tkeep;
  output                            sc0_ats_m_axis_cq_tlast;
  output [C_ATS_CQ_TUSER_WIDTH-1:0] sc0_ats_m_axis_cq_tuser;


  // System Cache2 Interface
  //RQ Interface
  input                             sc1_ats_s_axis_rq_tvalid;
  output                            sc1_ats_s_axis_rq_tready;
  input [C_ATS_DATA_WIDTH-1:0]      sc1_ats_s_axis_rq_tdata;
  input [C_ATS_DATA_WIDTH/8-1:0]    sc1_ats_s_axis_rq_tkeep;
  input                             sc1_ats_s_axis_rq_tlast;
  input [C_ATS_RQ_TUSER_WIDTH-1:0]  sc1_ats_s_axis_rq_tuser;

  //RC Interface
  output                            sc1_ats_m_axis_rc_tvalid;
  input                             sc1_ats_m_axis_rc_tready;
  output [C_ATS_DATA_WIDTH-1:0]     sc1_ats_m_axis_rc_tdata;
  output [C_ATS_DATA_WIDTH/8-1:0]   sc1_ats_m_axis_rc_tkeep;
  output                            sc1_ats_m_axis_rc_tlast;
  output [C_ATS_RC_TUSER_WIDTH-1:0] sc1_ats_m_axis_rc_tuser;

  //CC Interface
  input                             sc1_ats_s_axis_cc_tvalid;
  output                            sc1_ats_s_axis_cc_tready;
  input [C_ATS_DATA_WIDTH-1:0]      sc1_ats_s_axis_cc_tdata;
  input [C_ATS_DATA_WIDTH/8-1:0]    sc1_ats_s_axis_cc_tkeep;
  input                             sc1_ats_s_axis_cc_tlast;
  input [C_ATS_CC_TUSER_WIDTH-1:0]  sc1_ats_s_axis_cc_tuser;

  //CQ Interface
  output                            sc1_ats_m_axis_cq_tvalid;
  input                             sc1_ats_m_axis_cq_tready;
  output [C_ATS_DATA_WIDTH-1:0]     sc1_ats_m_axis_cq_tdata;
  output [C_ATS_DATA_WIDTH/8-1:0]   sc1_ats_m_axis_cq_tkeep;
  output                            sc1_ats_m_axis_cq_tlast;
  output [C_ATS_CQ_TUSER_WIDTH-1:0] sc1_ats_m_axis_cq_tuser;

  output  [PL_LINK_CAP_MAX_LINK_WIDTH-1 : 0]   pci_exp_txp;
  output  [PL_LINK_CAP_MAX_LINK_WIDTH-1 : 0]   pci_exp_txn;
  input   [PL_LINK_CAP_MAX_LINK_WIDTH-1 : 0]   pci_exp_rxp;
  input   [PL_LINK_CAP_MAX_LINK_WIDTH-1 : 0]   pci_exp_rxn;

  input    sys_clk;
  output   sys_clk_ce_out;
  input    sys_clk_gt;
  input    sys_rst_n;
  input    dma_bridge_resetn;
  output   user_lnk_up;
  input    free_run_clock;

  //----------------------------------------------------------------------------------------------------------------//
  //  Connectivity for external clocking                                                                            //
  //----------------------------------------------------------------------------------------------------------------//
  output          drp_rdy;
  output   [15:0] drp_do;
  input           drp_clk ;
  input           drp_en ;
  input           drp_we ;
  input    [10:0] drp_addr ;
  input    [15:0] drp_di ;

  output          cfg_ext_read_received;
  output          cfg_ext_write_received;
  output  [9:0]   cfg_ext_register_number;
  output  [7:0]   cfg_ext_function_number;
  output  [31:0]  cfg_ext_write_data;
  output  [3:0]   cfg_ext_write_byte_enable;
  input   [31:0]  cfg_ext_read_data;
  input           cfg_ext_read_data_valid;
  output     interrupt_out;
  output     interrupt_out_msi_vec0to31;
  output     interrupt_out_msi_vec32to63;
  output     interrupt_out_msix_0;
  output     interrupt_out_msix_1;
  output     interrupt_out_msix_2;
  output     interrupt_out_msix_3;

  output                                            ext_ch_gt_drpclk ;
  input   [((PL_LINK_CAP_MAX_LINK_WIDTH *  9)-1):0] ext_ch_gt_drpaddr ;
  input   [((PL_LINK_CAP_MAX_LINK_WIDTH *  1)-1):0] ext_ch_gt_drpen ;
  input   [((PL_LINK_CAP_MAX_LINK_WIDTH *  1)-1):0] ext_ch_gt_drpwe ;
  input   [((PL_LINK_CAP_MAX_LINK_WIDTH * 16)-1):0] ext_ch_gt_drpdi ;
  output  [((PL_LINK_CAP_MAX_LINK_WIDTH *  1)-1):0] ext_ch_gt_drprdy ;
  output  [((PL_LINK_CAP_MAX_LINK_WIDTH * 16)-1):0] ext_ch_gt_drpdo ;

  // -----------------------------------------------------------------------
  // Transceiver debug ports for 7 series PCIE gen3 core
  // -----------------------------------------------------------------------
  input   [ 2:0]                                pipe_txprbssel;
  input   [ 2:0]                                pipe_rxprbssel;
  input                                         pipe_txprbsforceerr;
  input                                         pipe_rxprbscntreset;
  input   [ 2:0]                                pipe_loopback;
  output  [PL_LINK_CAP_MAX_LINK_WIDTH-1:0]      pipe_rxprbserr;
  input  [PL_LINK_CAP_MAX_LINK_WIDTH-1:0]       pipe_txinhibit;
  output  [4:0]                                 pipe_rst_fsm;
  output  [11:0]                                pipe_qrst_fsm;
  output  [(PL_LINK_CAP_MAX_LINK_WIDTH*5)-1:0]  pipe_rate_fsm;
  output  [(PL_LINK_CAP_MAX_LINK_WIDTH*6)-1:0]  pipe_sync_fsm_tx;
  output  [(PL_LINK_CAP_MAX_LINK_WIDTH*7)-1:0]  pipe_sync_fsm_rx;
  output  [(PL_LINK_CAP_MAX_LINK_WIDTH*7)-1:0]  pipe_drp_fsm;
  output                                        pipe_rst_idle;
  output                                        pipe_qrst_idle;
  output                                        pipe_rate_idle;
  output  [PL_LINK_CAP_MAX_LINK_WIDTH-1:0]      pipe_eyescandataerror;
  output  [PL_LINK_CAP_MAX_LINK_WIDTH*3-1:0]    pipe_rxstatus;
  output  [PL_LINK_CAP_MAX_LINK_WIDTH*15-1:0]   pipe_dmonitorout;
  output  [(PL_LINK_CAP_MAX_LINK_WIDTH)-1:0]    pipe_cpll_lock;
  output  [(PL_LINK_CAP_MAX_LINK_WIDTH-1)>>2:0] pipe_qpll_lock;
  output  [(PL_LINK_CAP_MAX_LINK_WIDTH)-1:0]    pipe_rxpmaresetdone;
  output  [(PL_LINK_CAP_MAX_LINK_WIDTH*3)-1:0]  pipe_rxbufstatus;
  output  [(PL_LINK_CAP_MAX_LINK_WIDTH)-1:0]    pipe_txphaligndone;
  output  [(PL_LINK_CAP_MAX_LINK_WIDTH)-1:0]    pipe_txphinitdone;
  output  [(PL_LINK_CAP_MAX_LINK_WIDTH)-1:0]    pipe_txdlysresetdone;
  output  [(PL_LINK_CAP_MAX_LINK_WIDTH)-1:0]    pipe_rxphaligndone;
  output  [(PL_LINK_CAP_MAX_LINK_WIDTH)-1:0]    pipe_rxdlysresetdone;
  output  [(PL_LINK_CAP_MAX_LINK_WIDTH)-1:0]    pipe_rxsyncdone;
  output  [(PL_LINK_CAP_MAX_LINK_WIDTH*8)-1:0]  pipe_rxdisperr;
  output  [(PL_LINK_CAP_MAX_LINK_WIDTH*8)-1:0]  pipe_rxnotintable;
  output  [(PL_LINK_CAP_MAX_LINK_WIDTH)-1:0]    pipe_rxcommadet;
  output  [PL_LINK_CAP_MAX_LINK_WIDTH-1:0]      gt_ch_drp_rdy;
  output  [PL_LINK_CAP_MAX_LINK_WIDTH-1:0]      pipe_debug_0;
  output  [PL_LINK_CAP_MAX_LINK_WIDTH-1:0]      pipe_debug_1;
  output  [PL_LINK_CAP_MAX_LINK_WIDTH-1:0]      pipe_debug_2;
  output  [PL_LINK_CAP_MAX_LINK_WIDTH-1:0]      pipe_debug_3;
  output  [PL_LINK_CAP_MAX_LINK_WIDTH-1:0]      pipe_debug_4;
  output  [PL_LINK_CAP_MAX_LINK_WIDTH-1:0]      pipe_debug_5;
  output  [PL_LINK_CAP_MAX_LINK_WIDTH-1:0]      pipe_debug_6;
  output  [PL_LINK_CAP_MAX_LINK_WIDTH-1:0]      pipe_debug_7;
  output  [PL_LINK_CAP_MAX_LINK_WIDTH-1:0]      pipe_debug_8;
  output  [PL_LINK_CAP_MAX_LINK_WIDTH-1:0]      pipe_debug_9;
  output  [31:0]                                pipe_debug;

  // -----------------------------------------------------------------------
  // Transceiver debug ports for Ultrascale PCIE gen3 core
  // -----------------------------------------------------------------------
  input  [((PL_LINK_CAP_MAX_LINK_WIDTH*1)-1):0]  gt_pcieuserratedone;
  input  [((PL_LINK_CAP_MAX_LINK_WIDTH*3)-1):0]  gt_loopback;
  input  [((PL_LINK_CAP_MAX_LINK_WIDTH*1)-1):0]  gt_txprbsforceerr;
  input  [((PL_LINK_CAP_MAX_LINK_WIDTH*1)-1):0]  gt_txinhibit;
  input  [((PL_LINK_CAP_MAX_LINK_WIDTH*4)-1):0]  gt_txprbssel;
  input  [((PL_LINK_CAP_MAX_LINK_WIDTH*4)-1):0]  gt_rxprbssel;
  input  [((PL_LINK_CAP_MAX_LINK_WIDTH*1)-1):0]  gt_rxprbscntreset;
  input  [((PL_LINK_CAP_MAX_LINK_WIDTH*1)-1):0]  gt_dmonitorclk;
  input  [((PL_LINK_CAP_MAX_LINK_WIDTH*1)-1):0]  gt_dmonfiforeset;

  output [((PL_LINK_CAP_MAX_LINK_WIDTH*1)-1):0]  gt_txelecidle;
  output [((PL_LINK_CAP_MAX_LINK_WIDTH*1)-1):0]  gt_txresetdone;
  output [((PL_LINK_CAP_MAX_LINK_WIDTH*1)-1):0]  gt_rxresetdone;
  output [((PL_LINK_CAP_MAX_LINK_WIDTH*1)-1):0]  gt_rxpmaresetdone;
  output [((PL_LINK_CAP_MAX_LINK_WIDTH*1)-1):0]  gt_txphaligndone;
  output [((PL_LINK_CAP_MAX_LINK_WIDTH*1)-1):0]  gt_txphinitdone;
  output [((PL_LINK_CAP_MAX_LINK_WIDTH*1)-1):0]  gt_txdlysresetdone;
  output [((PL_LINK_CAP_MAX_LINK_WIDTH*1)-1):0]  gt_rxphaligndone;
  output [((PL_LINK_CAP_MAX_LINK_WIDTH*1)-1):0]  gt_rxdlysresetdone;
  output [((PL_LINK_CAP_MAX_LINK_WIDTH*1)-1):0]  gt_rxsyncdone;
  output [((PL_LINK_CAP_MAX_LINK_WIDTH*1)-1):0]  gt_eyescandataerror;
  output [((PL_LINK_CAP_MAX_LINK_WIDTH*1)-1):0]  gt_rxprbserr;
  output [((PL_LINK_CAP_MAX_LINK_WIDTH*17)-1):0] gt_dmonitorout;
  output [((PL_LINK_CAP_MAX_LINK_WIDTH*1)-1):0]  gt_rxcommadet;
  output [((PL_LINK_CAP_MAX_LINK_WIDTH*1)-1):0]  gt_phystatus;
  output [((PL_LINK_CAP_MAX_LINK_WIDTH*1)-1):0]  gt_rxvalid;
  output [((PL_LINK_CAP_MAX_LINK_WIDTH*1)-1):0]  gt_rxcdrlock;
  output [((PL_LINK_CAP_MAX_LINK_WIDTH*1)-1):0]  gt_pcierateidle;
  output [((PL_LINK_CAP_MAX_LINK_WIDTH*1)-1):0]  gt_pcieuserratestart;
  output [((PL_LINK_CAP_MAX_LINK_WIDTH*1)-1):0]  gt_gtpowergood;
  output [((PL_LINK_CAP_MAX_LINK_WIDTH*1)-1):0]  gt_cplllock;
  output [((PL_LINK_CAP_MAX_LINK_WIDTH*1)-1):0]  gt_rxoutclk;
  output [((PL_LINK_CAP_MAX_LINK_WIDTH*1)-1):0]  gt_rxrecclkout;
  output [((PL_LINK_CAP_MAX_LINK_WIDTH-1)>>2):0] gt_qpll1lock;
  output [((PL_LINK_CAP_MAX_LINK_WIDTH*3)-1):0]  gt_rxstatus;
  output [((PL_LINK_CAP_MAX_LINK_WIDTH*3)-1):0]  gt_rxbufstatus;
  output [8:0]                                   gt_bufgtdiv;
  output [((PL_LINK_CAP_MAX_LINK_WIDTH*2)-1):0]  phy_txeq_ctrl;
  output [((PL_LINK_CAP_MAX_LINK_WIDTH*4)-1):0]  phy_txeq_preset;
  output [3:0]                                   phy_rst_fsm;
  output [((PL_LINK_CAP_MAX_LINK_WIDTH*3)-1):0]  phy_txeq_fsm;
  output [((PL_LINK_CAP_MAX_LINK_WIDTH*3)-1):0]  phy_rxeq_fsm;
  output                                         phy_rst_idle;
  output                                         phy_rrst_n;
  output                                         phy_prst_n;
  output [((PL_LINK_CAP_MAX_LINK_WIDTH-1)>>2):0] gt_qpll0lock;
  output [PL_LINK_CAP_MAX_LINK_WIDTH-1:0]        gt_gen34_eios_det;
  output [PL_LINK_CAP_MAX_LINK_WIDTH-1:0]        gt_txoutclk;
  output [PL_LINK_CAP_MAX_LINK_WIDTH-1:0]        gt_txoutclkfabric;
  output [PL_LINK_CAP_MAX_LINK_WIDTH-1:0]        gt_rxoutclkfabric;
  output [PL_LINK_CAP_MAX_LINK_WIDTH-1:0]        gt_txoutclkpcs;
  output [PL_LINK_CAP_MAX_LINK_WIDTH-1:0]        gt_rxoutclkpcs;
  input  [PL_LINK_CAP_MAX_LINK_WIDTH-1:0]        gt_txpmareset;
  input  [PL_LINK_CAP_MAX_LINK_WIDTH-1:0]        gt_rxpmareset;
  input  [PL_LINK_CAP_MAX_LINK_WIDTH-1:0]        gt_txpcsreset;
  input  [PL_LINK_CAP_MAX_LINK_WIDTH-1:0]        gt_rxpcsreset;
  input  [PL_LINK_CAP_MAX_LINK_WIDTH-1:0]        gt_rxbufreset;
  input  [PL_LINK_CAP_MAX_LINK_WIDTH-1:0]        gt_rxcdrreset;
  input  [PL_LINK_CAP_MAX_LINK_WIDTH-1:0]        gt_rxdfelpmreset;
  output [PL_LINK_CAP_MAX_LINK_WIDTH-1:0]        gt_txprogdivresetdone;
  output [PL_LINK_CAP_MAX_LINK_WIDTH-1:0]        gt_txpmaresetdone;
  output [PL_LINK_CAP_MAX_LINK_WIDTH-1:0]        gt_txsyncdone;
  output [PL_LINK_CAP_MAX_LINK_WIDTH-1:0]        gt_rxprbslocked;

  // mcap and startup signals.
  output       mcap_design_switch;
  input        mcap_eos_in;
  output       cap_req;
  input        cap_gnt;
  input        cap_rel;
  output       startup_cfgclk;
  output       startup_cfgmclk;
  output [3:0] startup_di;
  output       startup_eos;
  output       startup_preq;
  input  [3:0] startup_do;
  input  [3:0] startup_dts;
  input        startup_fcsbo;
  input        startup_fcsbts;
  input        startup_gsr;
  input        startup_gts;
  input        startup_keyclearb;
  input        startup_pack;
  input        startup_usrcclko;
  input        startup_usrcclkts;
  input        startup_usrdoneo;
  input        startup_usrdonets;

  // Shared Logic Internal
  output                                     int_pclk_out_slave;
  output                                     int_pipe_rxusrclk_out;
  output [(PL_LINK_CAP_MAX_LINK_WIDTH-1):0]  int_rxoutclk_out;
  output                                     int_dclk_out;
  output                                     int_userclk1_out;
  output                                     int_userclk2_out;
  output                                     int_oobclk_out;
  output  [1:0]                              int_qplllock_out;
  output  [1:0]                              int_qplloutclk_out;
  output  [1:0]                              int_qplloutrefclk_out;
  input  [(PL_LINK_CAP_MAX_LINK_WIDTH-1):0]  int_pclk_sel_slave;

  // Shared Logic External Clock
  input                                   pipe_pclk_in;
  input                                   pipe_rxusrclk_in;
  input  [PL_LINK_CAP_MAX_LINK_WIDTH-1:0] pipe_rxoutclk_in;
  input                                   pipe_dclk_in;
  input                                   pipe_userclk1_in;
  input                                   pipe_userclk2_in;
  input                                   pipe_oobclk_in;
  input                                   pipe_mmcm_lock_in;
  input                                   pipe_mmcm_rst_n;
  output                                  pipe_txoutclk_out;
  output [PL_LINK_CAP_MAX_LINK_WIDTH-1:0] pipe_rxoutclk_out;
  output [PL_LINK_CAP_MAX_LINK_WIDTH-1:0] pipe_pclk_sel_out;
  output                                  pipe_gen3_out;

  // Shared Logic External GT COMMON pcie3_7x
  input  [11:0]   qpll_drp_crscode;
  input  [17:0]   qpll_drp_fsm;
  input  [1:0]    qpll_drp_done;
  input  [1:0]    qpll_drp_reset;
  input  [1:0]    qpll_qplllock;
  input  [1:0]    qpll_qplloutclk;
  input  [1:0]    qpll_qplloutrefclk;
  output          qpll_qplld;
  output [1:0]    qpll_qpllreset;
  output          qpll_drp_clk;
  output          qpll_drp_rst_n;
  output          qpll_drp_ovrd;
  output          qpll_drp_gen3;
  output          qpll_drp_start;

  output  [((PL_LINK_CAP_MAX_LINK_WIDTH-1)>>2):0]           int_qpll1lock_out;
  output  [((PL_LINK_CAP_MAX_LINK_WIDTH-1)>>2):0]           int_qpll1outclk_out;
  output  [((PL_LINK_CAP_MAX_LINK_WIDTH-1)>>2):0]           int_qpll1outrefclk_out;
  output  [((PL_LINK_CAP_MAX_LINK_WIDTH-1)>>2):0]           ext_qpll1refclk;
  output  [((PL_LINK_CAP_MAX_LINK_WIDTH-1)>>2):0]           ext_qpll1pd;
  output  [((((PL_LINK_CAP_MAX_LINK_WIDTH-1)>>2)+1)*3)-1:0] ext_qpll1rate;
  output  [((PL_LINK_CAP_MAX_LINK_WIDTH-1)>>2):0]           ext_qpll1reset;
  input   [((PL_LINK_CAP_MAX_LINK_WIDTH-1)>>2):0]           ext_qpll1lock_out;
  input   [((PL_LINK_CAP_MAX_LINK_WIDTH-1)>>2):0]           ext_qpll1outclk_out;
  input   [((PL_LINK_CAP_MAX_LINK_WIDTH-1)>>2):0]           ext_qpll1outrefclk_out;
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
